Daxxn/KiCAD-Component-Library/Models/Connectors/F26P_ASM.stp

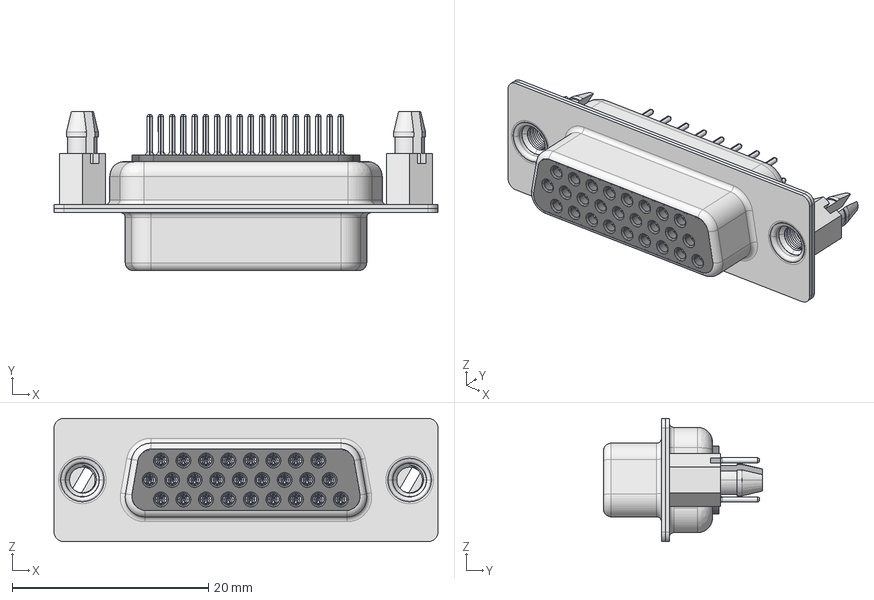
[picture p1: CAD file, 2023-04-23]
Models/Connectors/F26P_ASM.stp
39.1 x 16.2 x 12.6 mm
FHOUSING
26PF_SHELL
FCOVER
FCONTACT_2 x 26
FCONTACT_3 x 26
FCONTACT_4 x 26
HDP-YUCHA x 2
