Daxxn/KiCAD-Component-Library/Models/Arduino/ARDUINO-MICRO v5.step

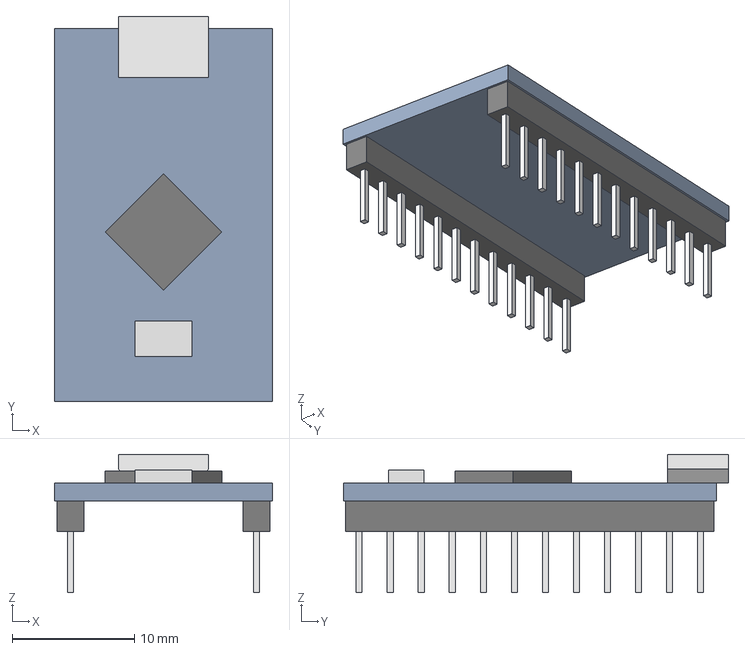
[picture p2: CAD file, 2022-10-09]
Models/Arduino/ARDUINO-MICRO v5.step
17.8 x 31.5 x 11.3 mm
