Daxxn/KiCAD-Component-Library/Models/Batteries/2462.step

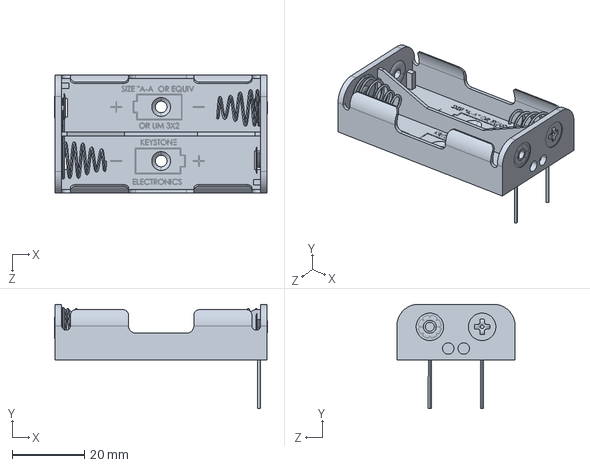
[picture p3: CAD file, 2025-04-12]
Models/Batteries/2462.step
59.1 x 29.0 x 32.8 mm
