Daxxn/KiCAD-Component-Library/Models/Connectors/Connector_BNC/CONBNC001.STEP

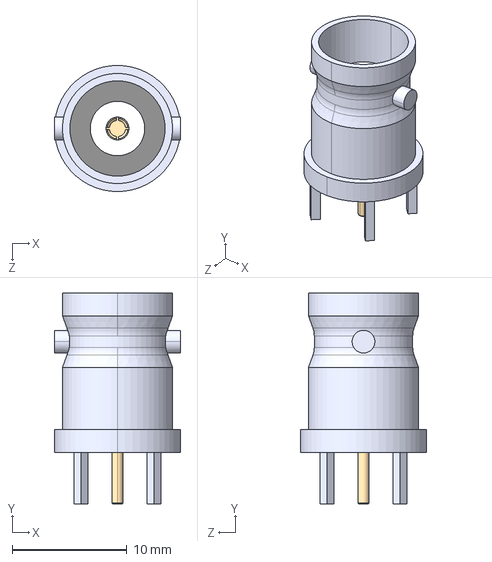
[picture p4: CAD file, 2025-11-15]
Models/Connectors/Connector_BNC/CONBNC001.STEP
11.0 x 18.4 x 11.0 mm
