Daxxn/KiCAD-Component-Library/Models/Connectors/Connector_DIN/57PC5FS.step

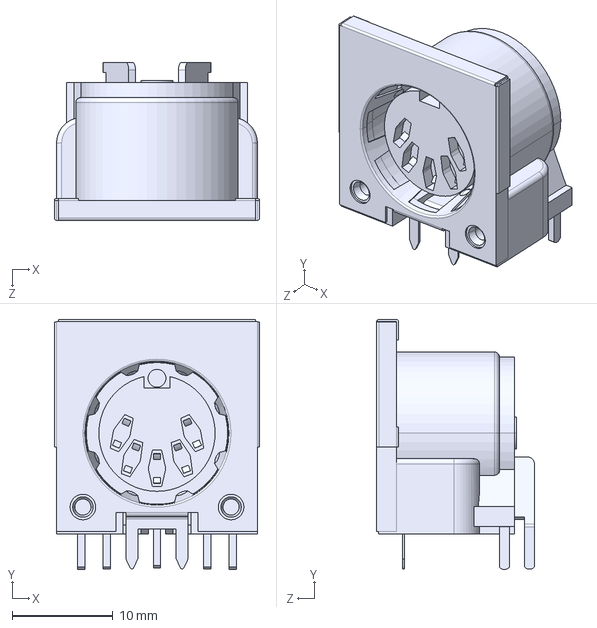
[picture p5: CAD file, 2025-04-12]
Models/Connectors/Connector_DIN/57PC5FS.step
20.4 x 24.9 x 15.7 mm
