Daxxn/KiCAD-Component-Library/Models/Connectors/Connector_DSUB/DD50S564TLF.step

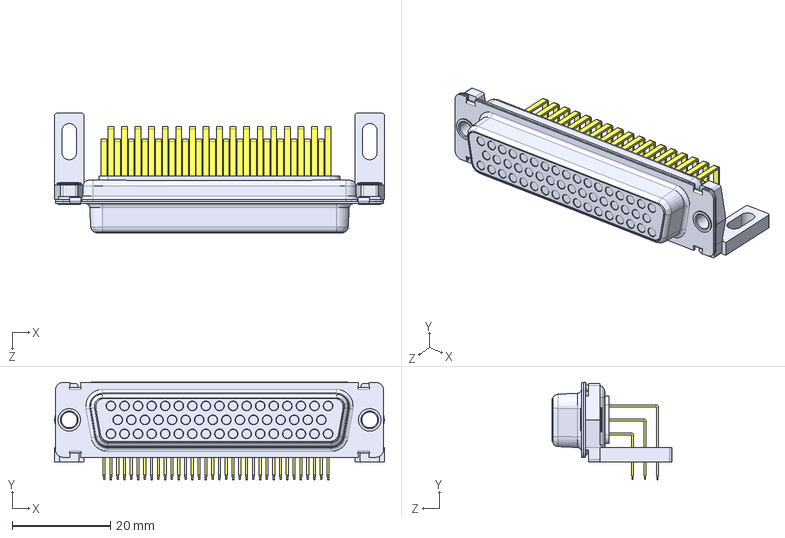
[picture p6: CAD file, 2025-11-15]
Models/Connectors/Connector_DSUB/DD50S564TLF.step
67.1 x 19.9 x 24.4 mm
