Daxxn/KiCAD-Component-Library/Models/Connectors/Connector_Ethernet/RJMG201K21120FR.step

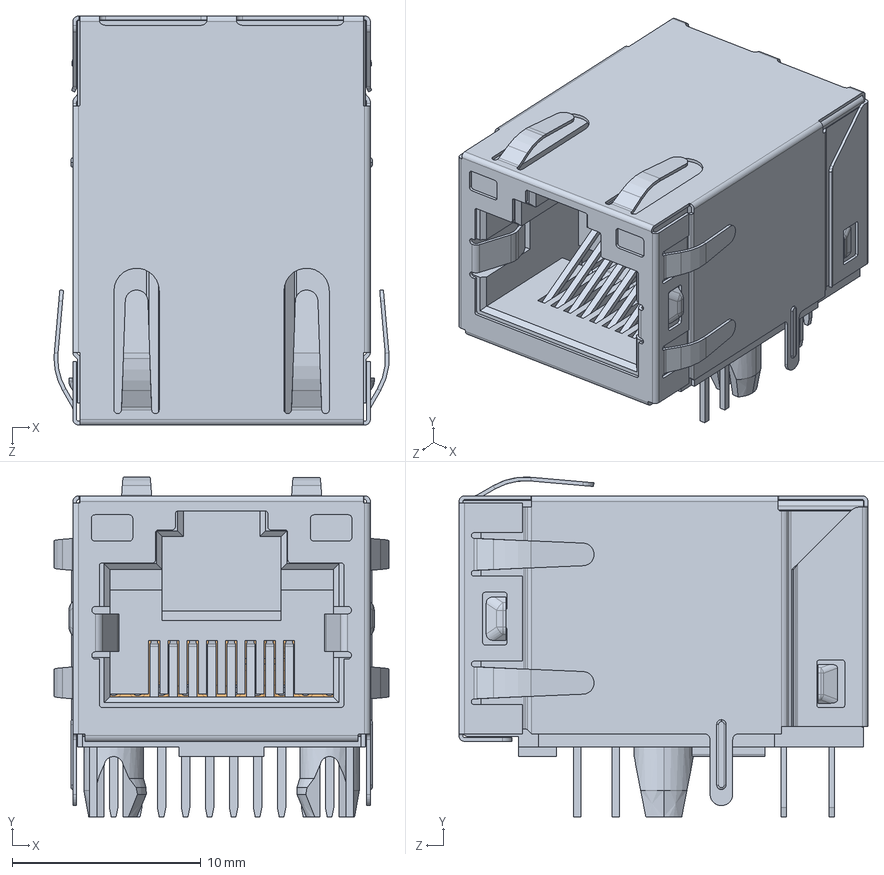
[picture p7: CAD file, 2025-11-15]
Models/Connectors/Connector_Ethernet/RJMG201K21120FR.step
17.7 x 18.0 x 21.7 mm
