Daxxn/KiCAD-Component-Library/Models/Connectors/Connector_Jack/PRT-09739.step

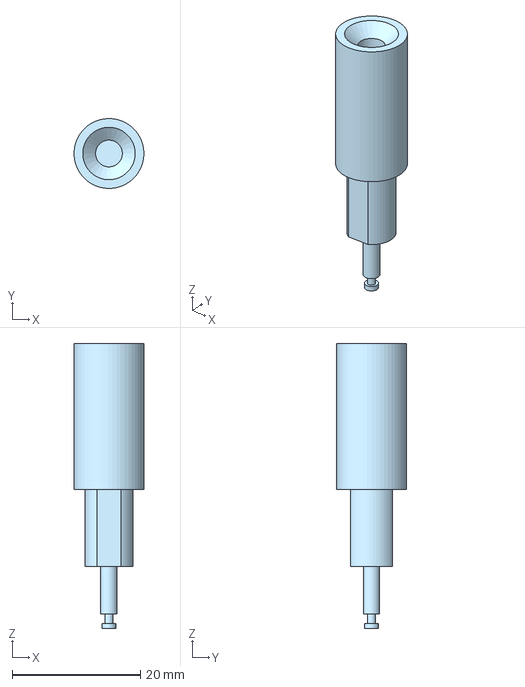
[picture p9: CAD file, 2025-04-12]
Models/Connectors/Connector_Jack/PRT-09739.step
10.9 x 10.9 x 44.4 mm
