Daxxn/KiCAD-Component-Library/Models/Connectors/Connector_PinHeader_2.54mm/PinHeader_2x35_P2.54mm_Vertical_SMD.step

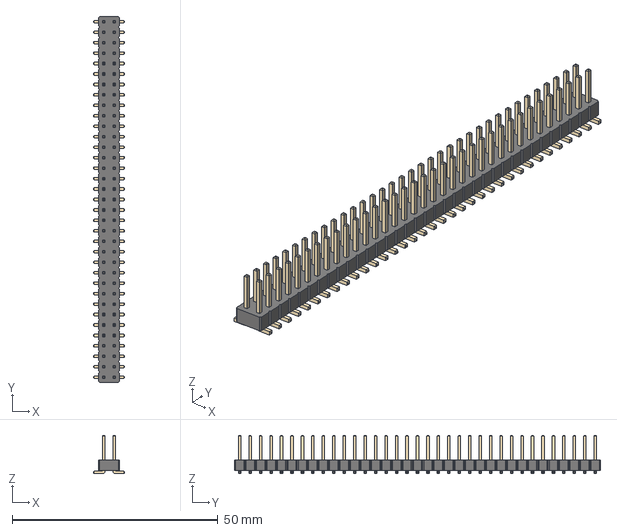
[picture p10: CAD file, 2025-02-12]
Models/Connectors/Connector_PinHeader_2.54mm/PinHeader_2x35_P2.54mm_Vertical_SMD.step
7.54 x 88.9 x 9.30 mm
