Daxxn/KiCAD-Component-Library/Models/Connectors/Connector_Power/739W-X2_03.STEP

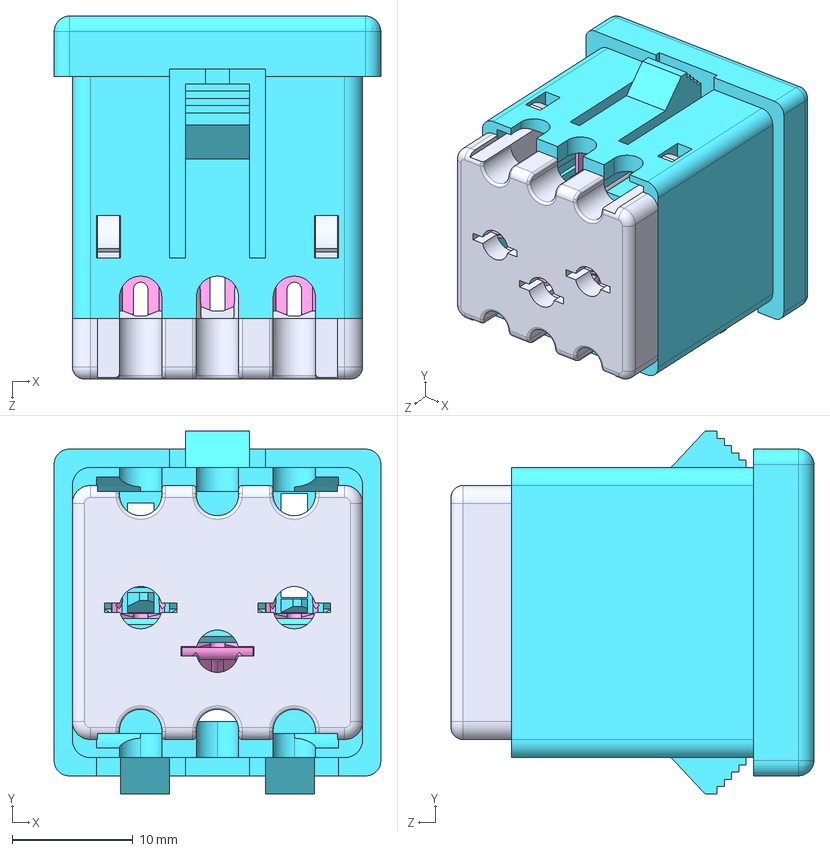
[picture p11: CAD file, 2025-04-12]
Models/Connectors/Connector_Power/739W-X2_03.STEP
27.0 x 30.0 x 30.0 mm
RF6001A
RF6001-001
RF6001-003 x 2
RF6001C
