Daxxn/KiCAD-Component-Library/Models/Connectors/Connector_Programming/FTR-110-51-L-D-06.stp

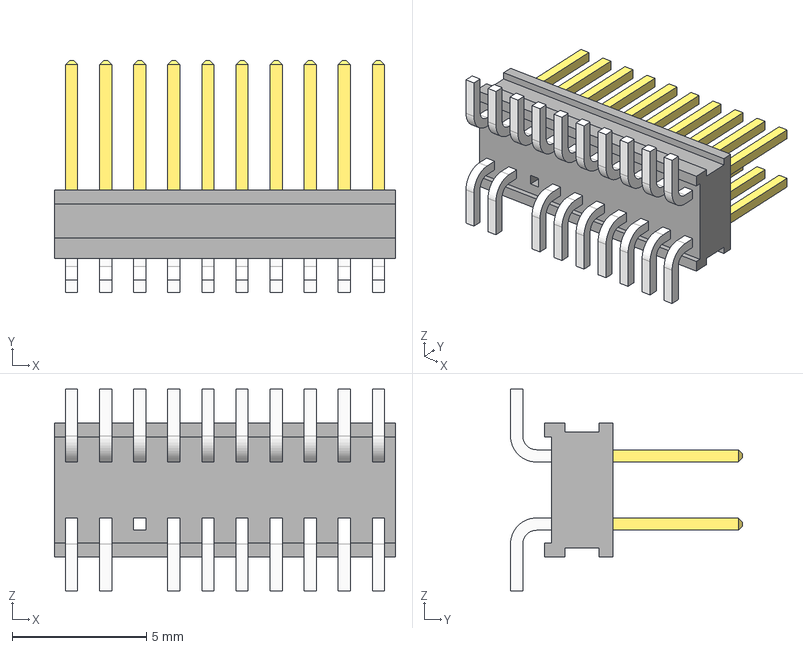
[picture p12: CAD file, 2025-04-12]
Models/Connectors/Connector_Programming/FTR-110-51-L-D-06.stp
12.7 x 8.64 x 7.52 mm
FTR-110-51-L-D-006_body
FTR-110-51-L-D-006_pins
FTR-110-51-L-D-0062PNS
