Daxxn/KiCAD-Component-Library/Models/Connectors/Connector_Samtec/LSHM-110-01-L-DH-A-S-K-TR.step

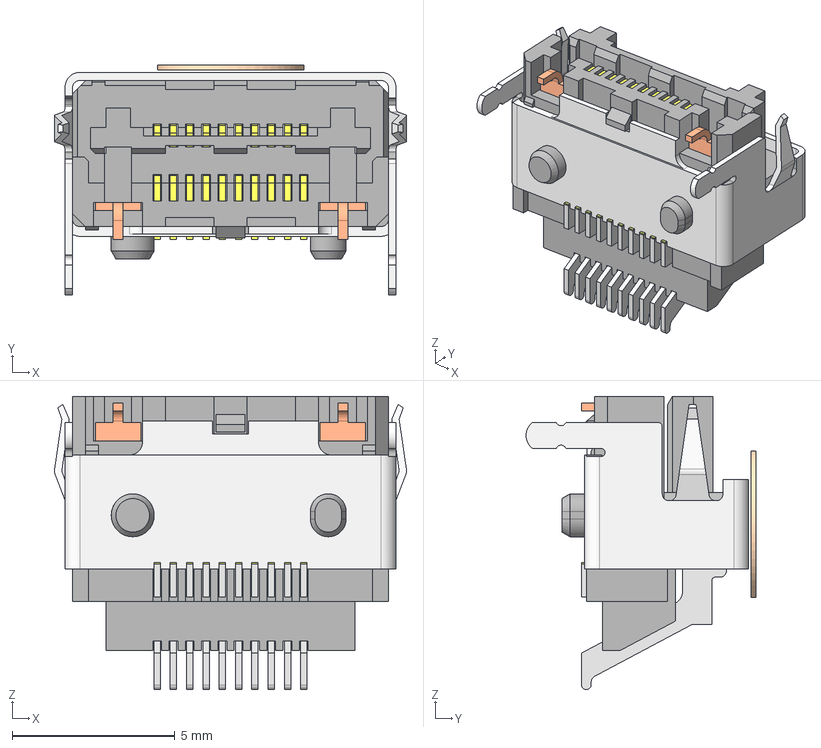
[picture p13: CAD file, 2025-04-12]
Models/Connectors/Connector_Samtec/LSHM-110-01-L-DH-A-S-K-TR.step
10.8 x 7.05 x 9.00 mm
K-DOT-.177-.281-.005pp
WT-135 x 2
C-185--10-01-DH1P2 L
C-185--10-01-L-DH1P
LSHM-10-01-DH-A-S_STRIP
