Daxxn/KiCAD-Component-Library/Models/Connectors/Connector_Samtec_HPM_THT/Samtec_HPM-07-01-x-S_Straight_1x07_Pitch5.08mm.step

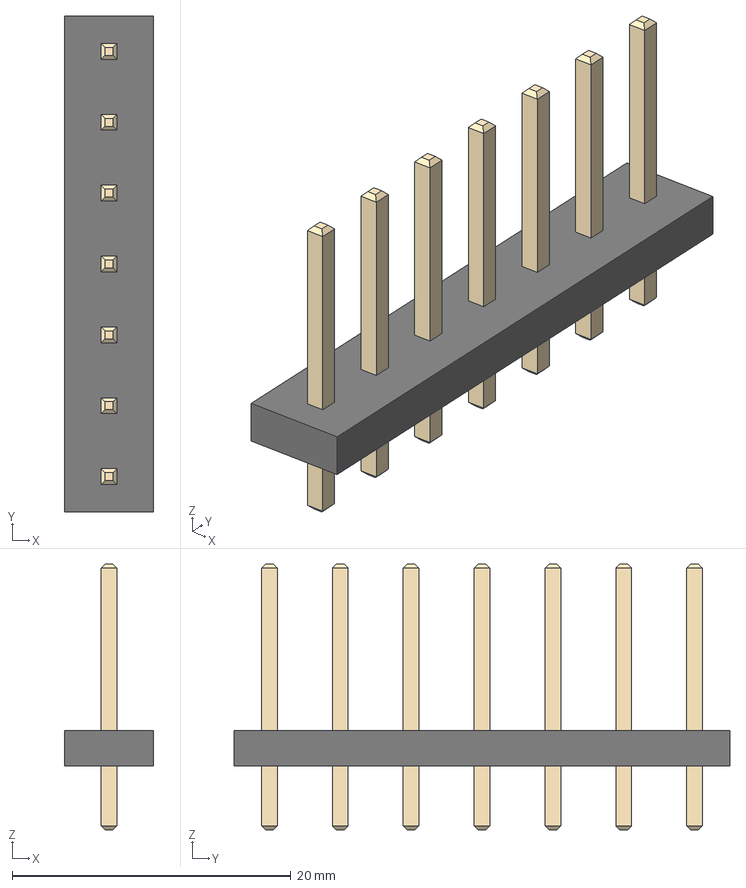
[picture p14: CAD file, 2025-04-12]
Models/Connectors/Connector_Samtec_HPM_THT/Samtec_HPM-07-01-x-S_Straight_1x07_Pitch5.08mm.step
6.35 x 35.6 x 19.1 mm
cf05abca-8c20-11ed-9f4e-a0cec80452fd_part
cf05b020-8c20-11ed-9f4e-a0cec80452fd_part
cf05b32c-8c20-11ed-9f4e-a0cec80452fd_part
