Daxxn/KiCAD-Component-Library/Models/Connectors/Connector_Terminal/7788.STEP

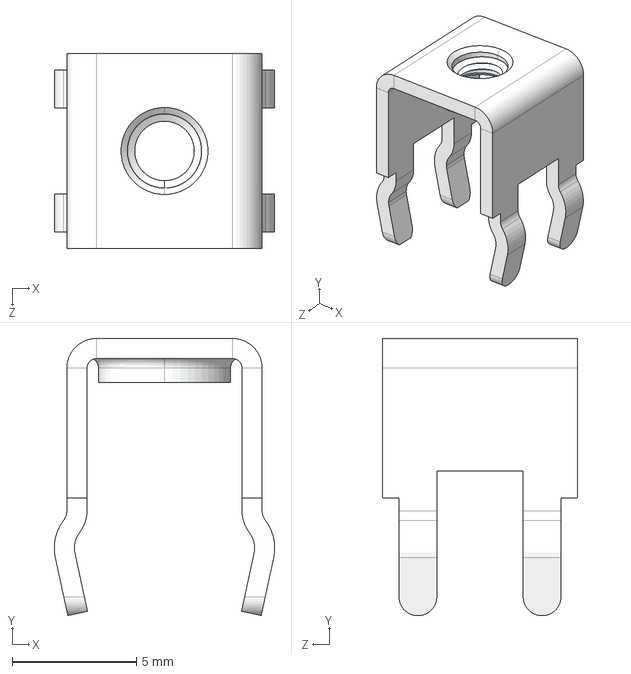
[picture p15: CAD file, 2025-04-12]
Models/Connectors/Connector_Terminal/7788.STEP
8.89 x 11.2 x 7.87 mm
