Daxxn/KiCAD-Component-Library/Models/Connectors/IO-XLR3-M-EH.step

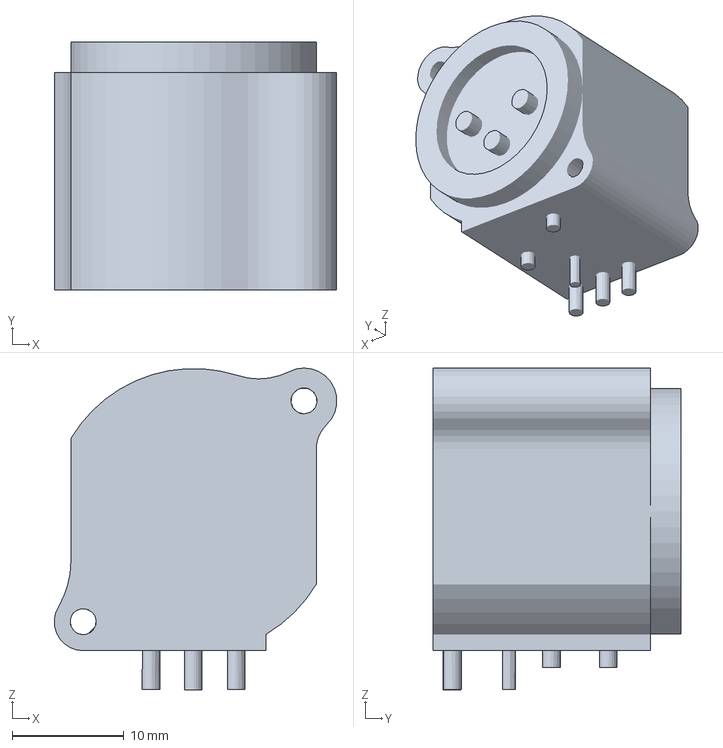
[picture p16: CAD file, 2025-04-12]
Models/Connectors/IO-XLR3-M-EH.step
25.3 x 22.2 x 28.9 mm
