Daxxn/KiCAD-Component-Library/Models/Controls/228CMV.step

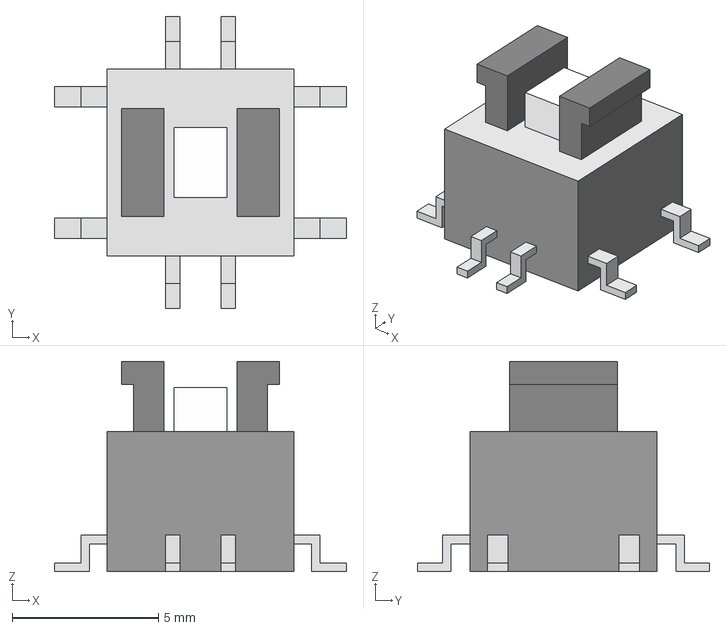
[picture p17: CAD file, 2025-04-12]
Models/Controls/228CMV.step
10.0 x 10.0 x 7.20 mm
