Daxxn/KiCAD-Component-Library/Models/Hardware/Standoff-Brass-M3-10.stp

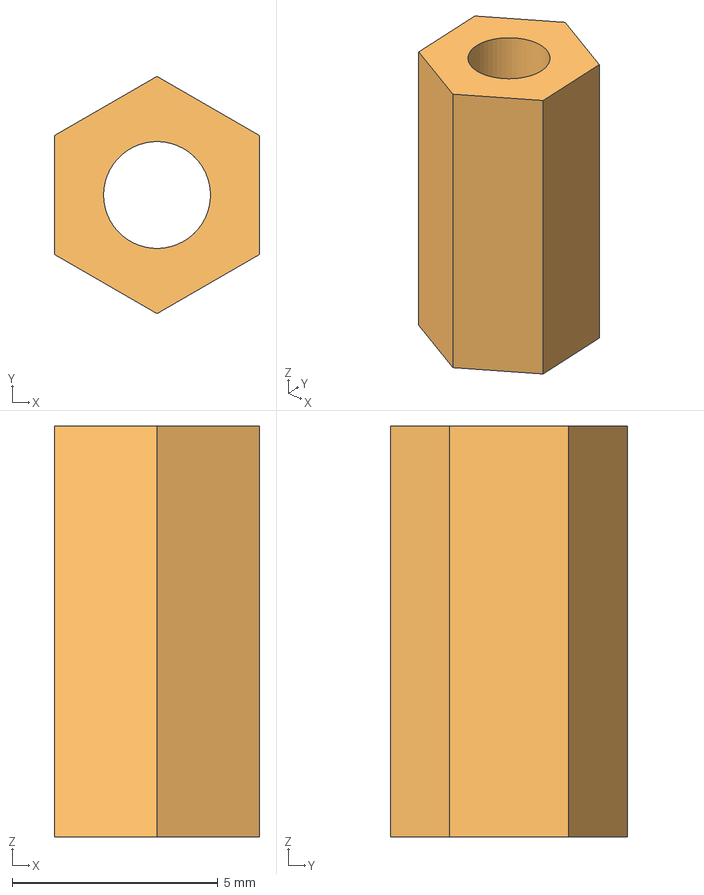
[picture p18: CAD file, 2022-10-09]
Models/Hardware/Standoff-Brass-M3-10.stp
5.00 x 5.77 x 10.0 mm
