Daxxn/KiCAD-Component-Library/Models/LEDs/67-21S.STEP

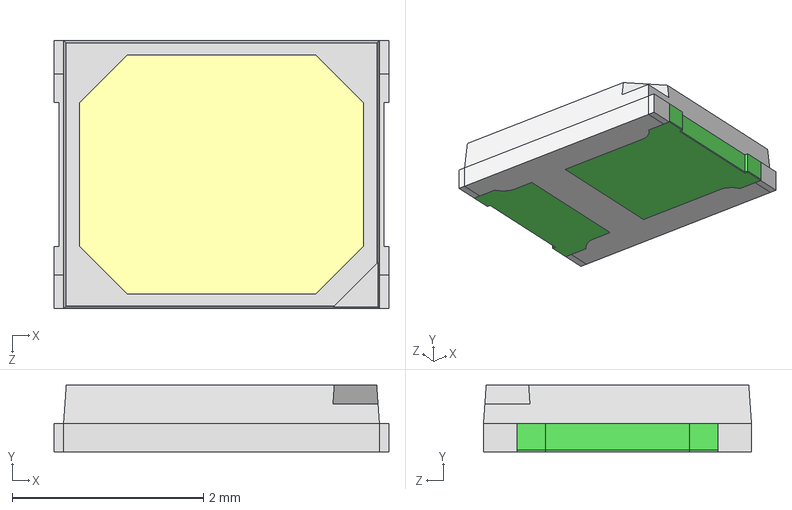
[picture p19: CAD file, 2025-04-12]
Models/LEDs/67-21S.STEP
3.50 x 0.7 x 2.80 mm
