Daxxn/KiCAD-Component-Library/Models/Modules/XBOX-Ctrlr-MCU-1708.step

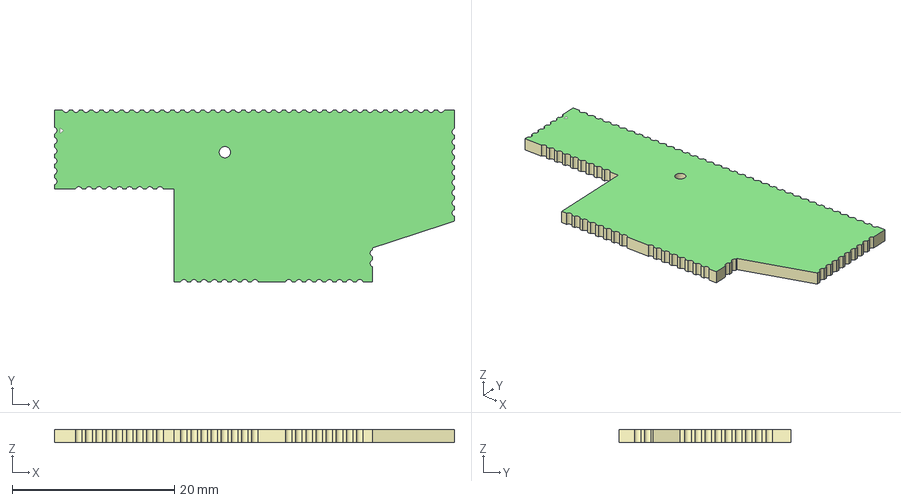
[picture p20: CAD file, 2025-11-15]
Models/Modules/XBOX-Ctrlr-MCU-1708.step
49.3 x 21.2 x 1.61 mm
