Daxxn/KiCAD-Component-Library/Models/Packages/Package_BGA/BGA-96_9.0x13.0mm_Layout2x3x16_P0.8mm.step

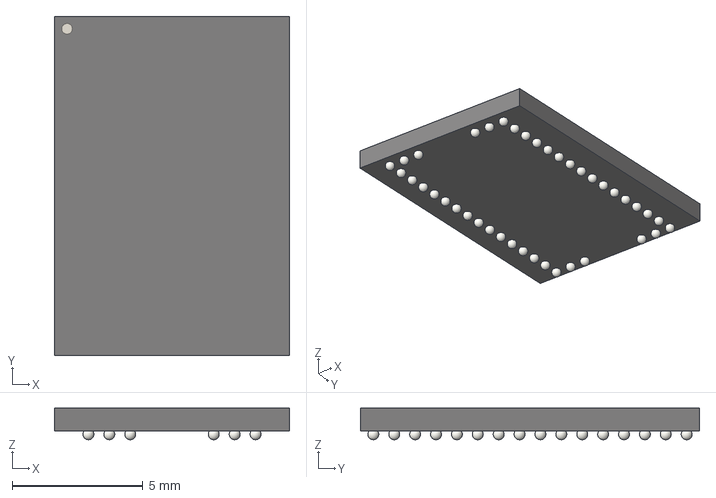
[picture p21: CAD file, 2025-02-12]
Models/Packages/Package_BGA/BGA-96_9.0x13.0mm_Layout2x3x16_P0.8mm.step
9.00 x 13.0 x 1.21 mm
