Daxxn/KiCAD-Component-Library/Models/Packages/Package_CSP/LFCSP-8-1EP_3x3mm_P0.5mm_EP1.45x1.74mm.step

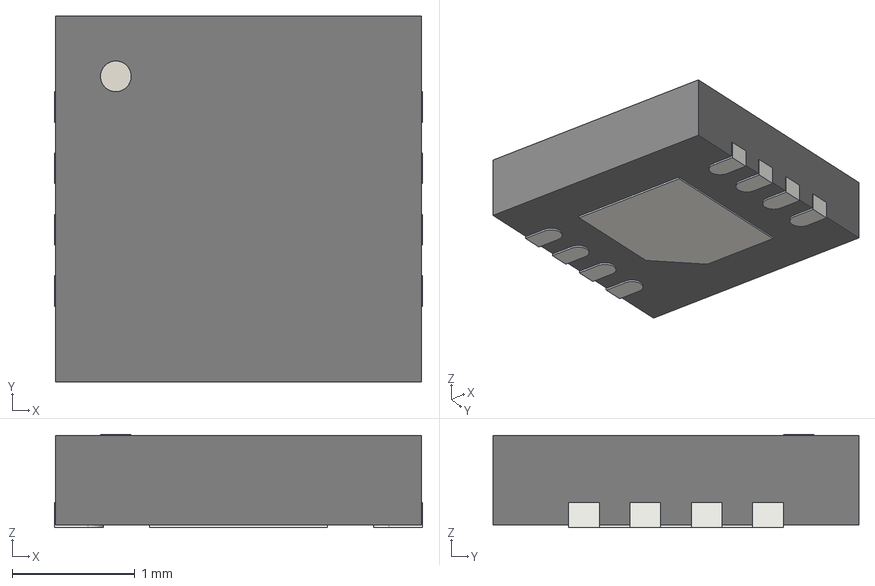
[picture p22: CAD file, 2025-02-12]
Models/Packages/Package_CSP/LFCSP-8-1EP_3x3mm_P0.5mm_EP1.45x1.74mm.step
3.00 x 2.98 x 0.76 mm
b90dc85a-8c68-11ed-89d9-acde48001122_part
b90dcca6-8c68-11ed-89d9-acde48001122_part
b90dcdfa-8c68-11ed-89d9-acde48001122_part
b90dcec2-8c68-11ed-89d9-acde48001122_part
