Daxxn/KiCAD-Component-Library/Models/Packages/Package_DIP/DIP-16_W7.62mm_Socket.step

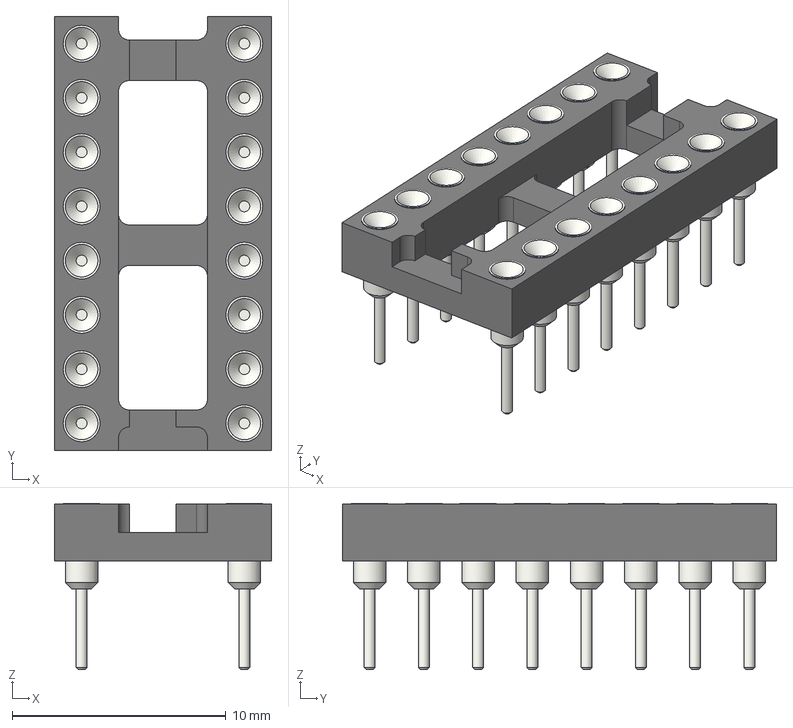
[picture p23: CAD file, 2025-02-12]
Models/Packages/Package_DIP/DIP-16_W7.62mm_Socket.step
10.2 x 20.3 x 7.79 mm
