Daxxn/KiCAD-Component-Library/Models/Packages/Package_LGA/Bosch_LGA-14_3x2.5mm_P0.5mm.step

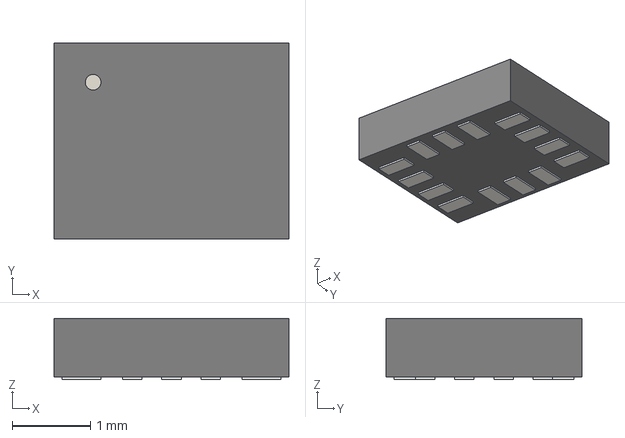
[picture p25: CAD file, 2025-02-12]
Models/Packages/Package_LGA/Bosch_LGA-14_3x2.5mm_P0.5mm.step
3.00 x 2.50 x 0.78 mm
