Daxxn/KiCAD-Component-Library/Models/Packages/Package_QFP/LQFP-32_7x7mm_P0.8mm.step

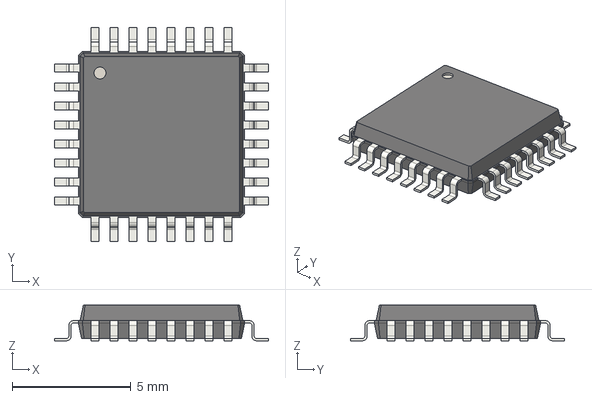
[picture p26: CAD file, 2025-02-12]
Models/Packages/Package_QFP/LQFP-32_7x7mm_P0.8mm.step
9.00 x 9.00 x 1.50 mm
