Daxxn/KiCAD-Component-Library/Models/Packages/Package_SIP/SLA704XM.step

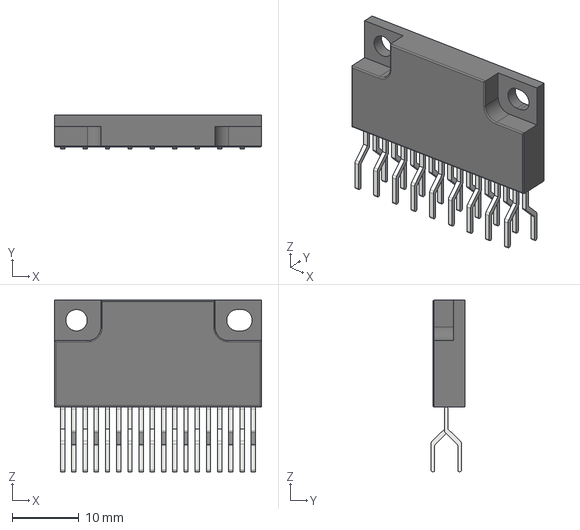
[picture p27: CAD file, 2025-02-12]
Models/Packages/Package_SIP/SLA704XM.step
31.0 x 5.08 x 25.7 mm
