Daxxn/KiCAD-Component-Library/Models/Packages/Package_SO/SSOP-14_5.3x6.2mm_P0.65mm.step

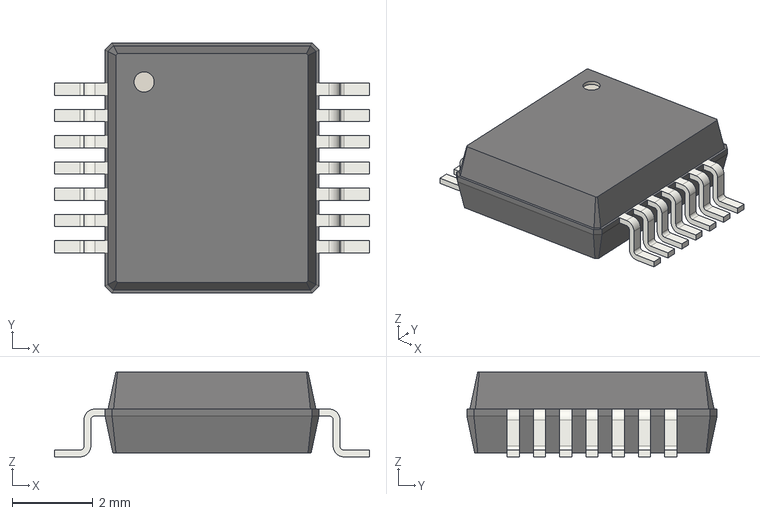
[picture p28: CAD file, 2025-02-12]
Models/Packages/Package_SO/SSOP-14_5.3x6.2mm_P0.65mm.step
7.80 x 6.20 x 2.10 mm
