Daxxn/KiCAD-Component-Library/Models/Packages/Package_SON/VSON-8_PWRPAK_3x3.3mm.step

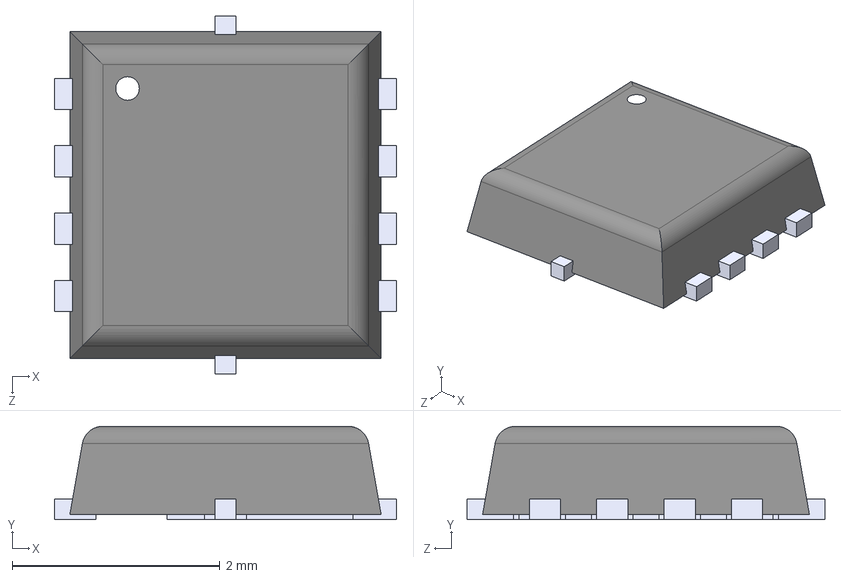
[picture p29: CAD file, 2025-11-15]
Models/Packages/Package_SON/VSON-8_PWRPAK_3x3.3mm.step
3.30 x 0.9 x 3.45 mm
