Daxxn/KiCAD-Component-Library/Models/Packages/Package_TO_SOT_SMD/TO-277A.step

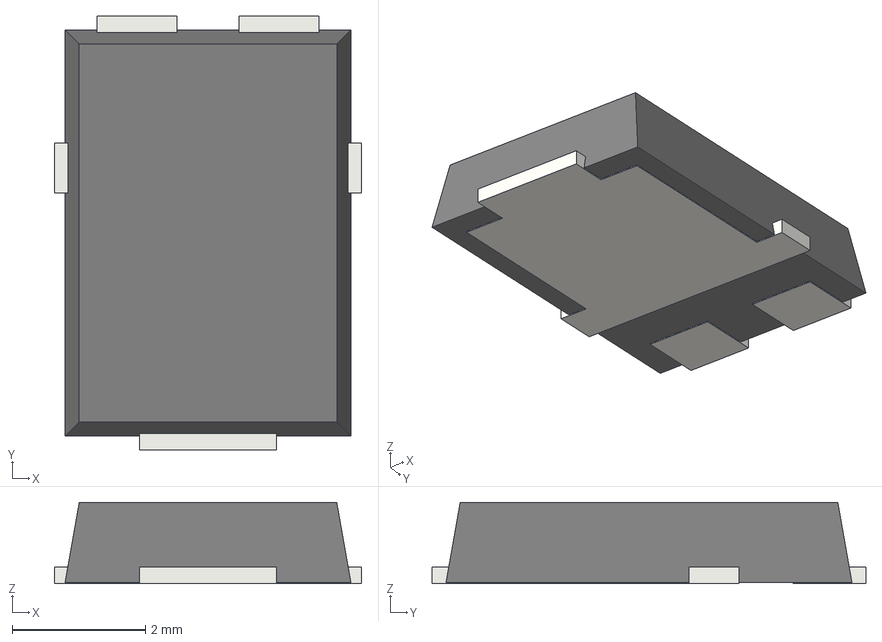
[picture p30: CAD file, 2025-02-12]
Models/Packages/Package_TO_SOT_SMD/TO-277A.step
4.60 x 6.50 x 1.22 mm
