Daxxn/KiCAD-Component-Library/Models/Packages/Package_TO_SOT_THT/TO-92-2_Wide.step

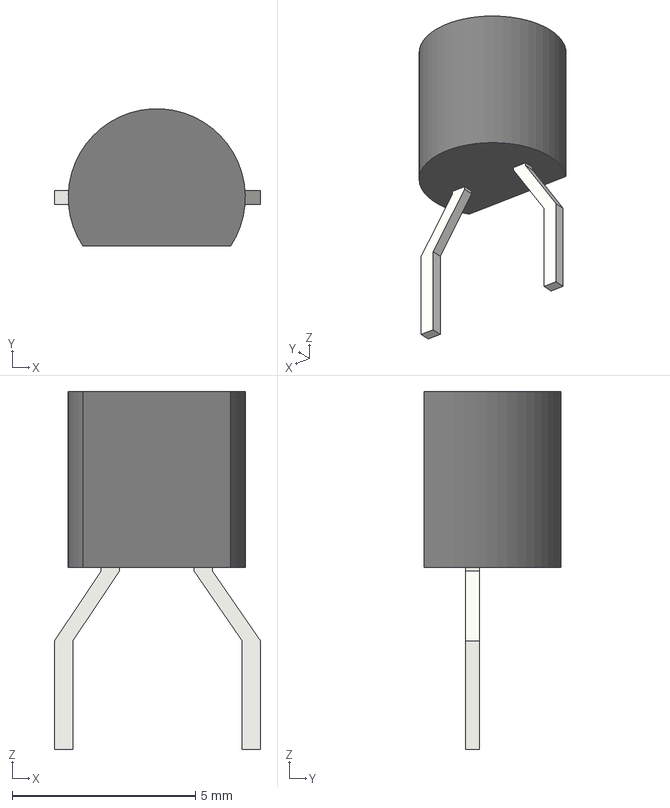
[picture p31: CAD file, 2025-02-12]
Models/Packages/Package_TO_SOT_THT/TO-92-2_Wide.step
5.62 x 3.74 x 9.76 mm
