Daxxn/KiCAD-Component-Library/Models/Packages/QFN-24-1EP_4x4mm_P0.5mm_EP2.6x2.6mm.step

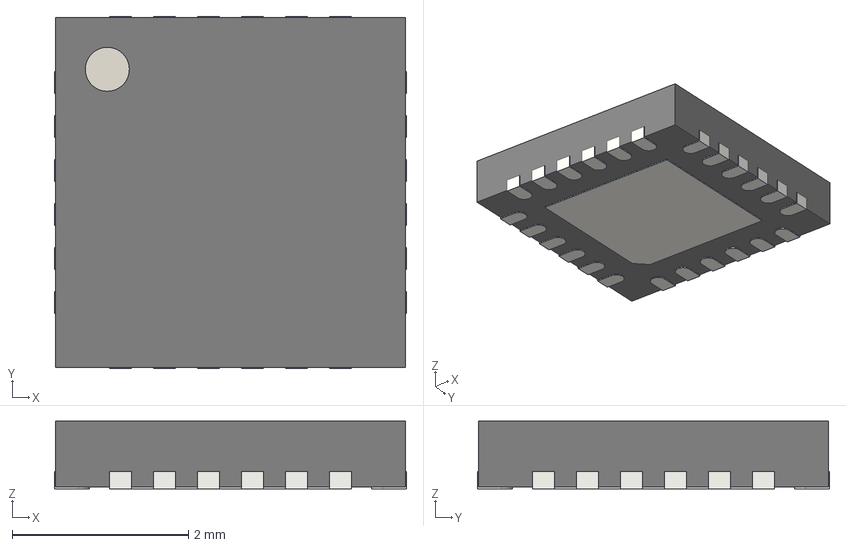
[picture p32: CAD file, 2025-02-12]
Models/Packages/QFN-24-1EP_4x4mm_P0.5mm_EP2.6x2.6mm.step
4.00 x 4.00 x 0.77 mm
