Daxxn/KiCAD-Component-Library/Models/Packages/Transistor_Power_Module/ST_SDIP-25L.step

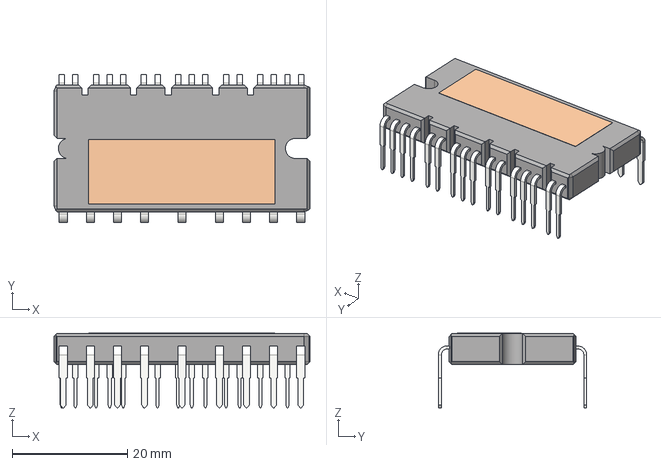
[picture p33: CAD file, 2025-02-12]
Models/Packages/Transistor_Power_Module/ST_SDIP-25L.step
44.4 x 25.8 x 12.9 mm
