Daxxn/KiCAD-Component-Library/Models/Passives/Capacitors/CP_Elec_10x12.5.step

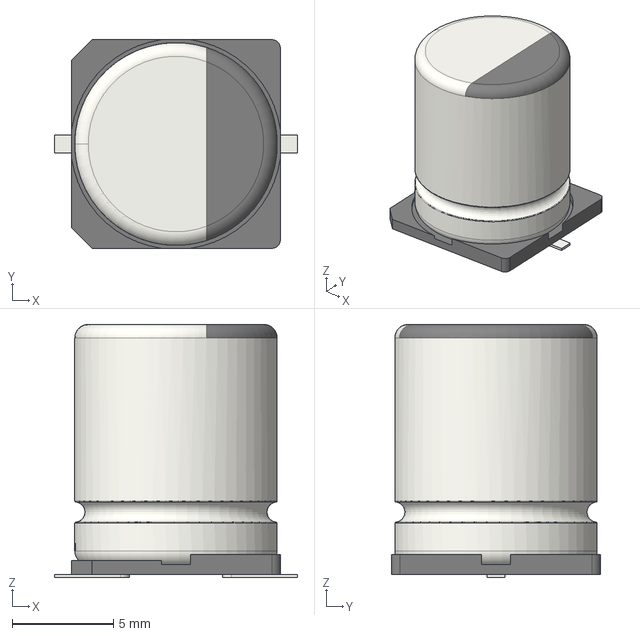
[picture p34: CAD file, 2025-02-12]
Models/Passives/Capacitors/CP_Elec_10x12.5.step
12.0 x 10.3 x 12.5 mm
