Daxxn/KiCAD-Component-Library/Models/Passives/Crystals/Crystal_HC49-4H_Vertical.step

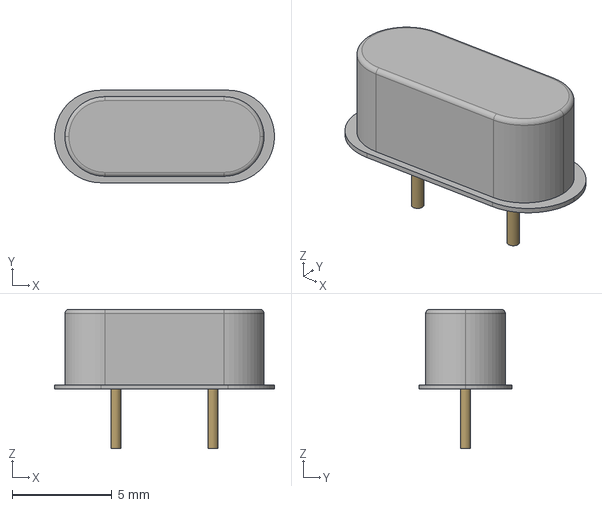
[picture p35: CAD file, 2025-02-12]
Models/Passives/Crystals/Crystal_HC49-4H_Vertical.step
11.1 x 4.65 x 7.00 mm
