Daxxn/KiCAD-Component-Library/Models/Passives/Diodes/D_2010_5025Metric.step

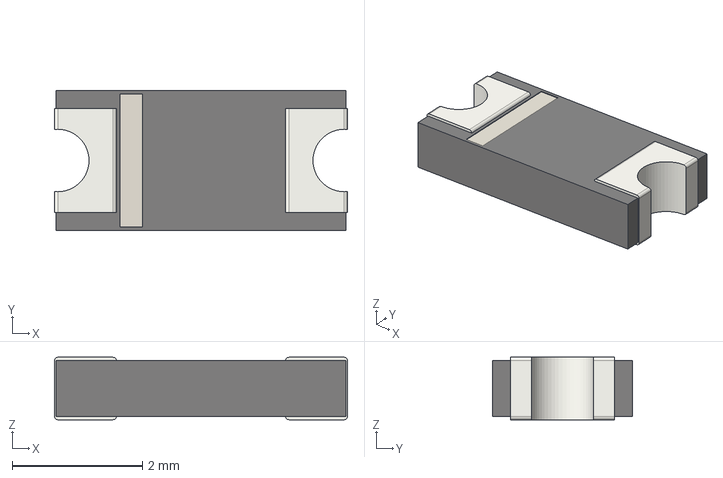
[picture p36: CAD file, 2025-02-12]
Models/Passives/Diodes/D_2010_5025Metric.step
4.50 x 2.15 x 0.96 mm
