Daxxn/KiCAD-Component-Library/Models/Passives/Inductors/IHLP5050FDERR10M01.stp

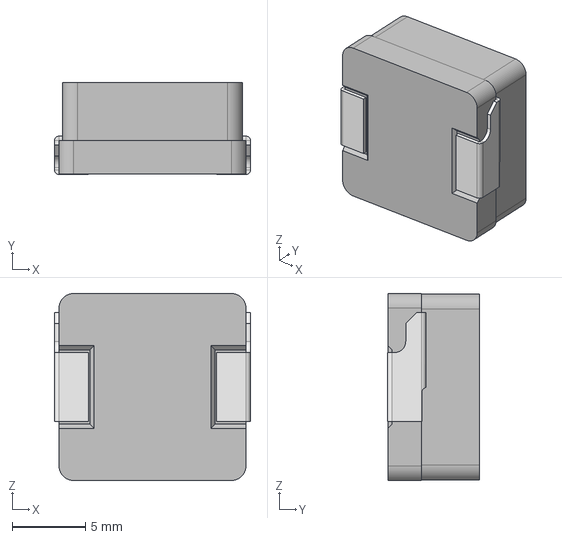
[picture p37: CAD file, 2025-04-12]
Models/Passives/Inductors/IHLP5050FDERR10M01.stp
13.4 x 6.29 x 12.8 mm
