Daxxn/KiCAD-Component-Library/Models/Passives/Resistors/R_Array_Convex_5x1206.step

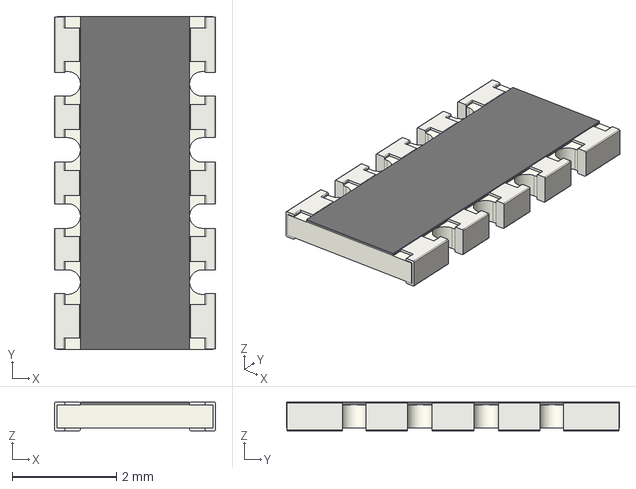
[picture p38: CAD file, 2025-02-12]
Models/Passives/Resistors/R_Array_Convex_5x1206.step
3.10 x 6.40 x 0.55 mm
