Daxxn/KiCAD-Component-Library/Models/Protection/36-3522.step

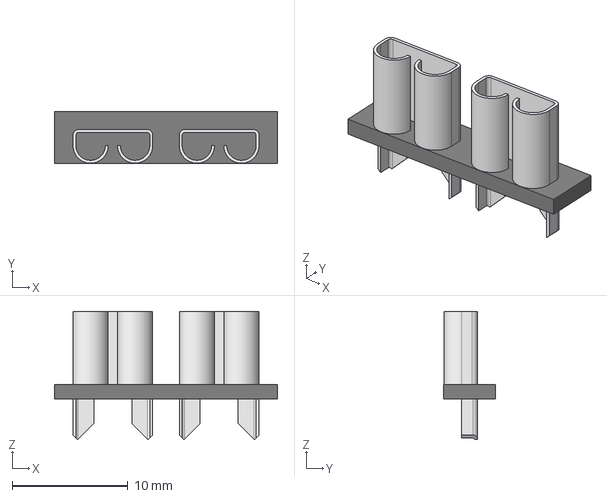
[picture p39: CAD file, 2022-10-09]
Models/Protection/36-3522.step
19.3 x 4.50 x 11.1 mm
