Daxxn/KiCAD-Component-Library/Models/Relays/PT08_0.step

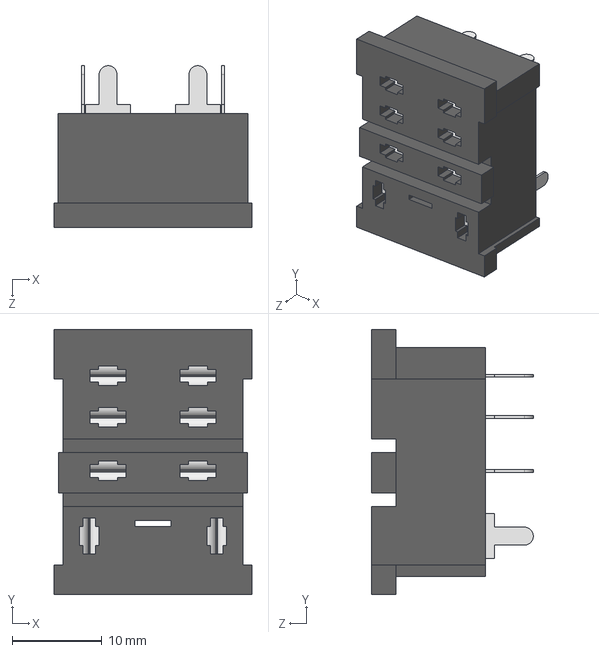
[picture p40: CAD file, 2025-04-12]
Models/Relays/PT08_0.step
22.0 x 29.5 x 18.0 mm
