Daxxn/KiCAD-Component-Library/Models/RF/Antenna/AMCA31-2R450G-S1F-T3.step

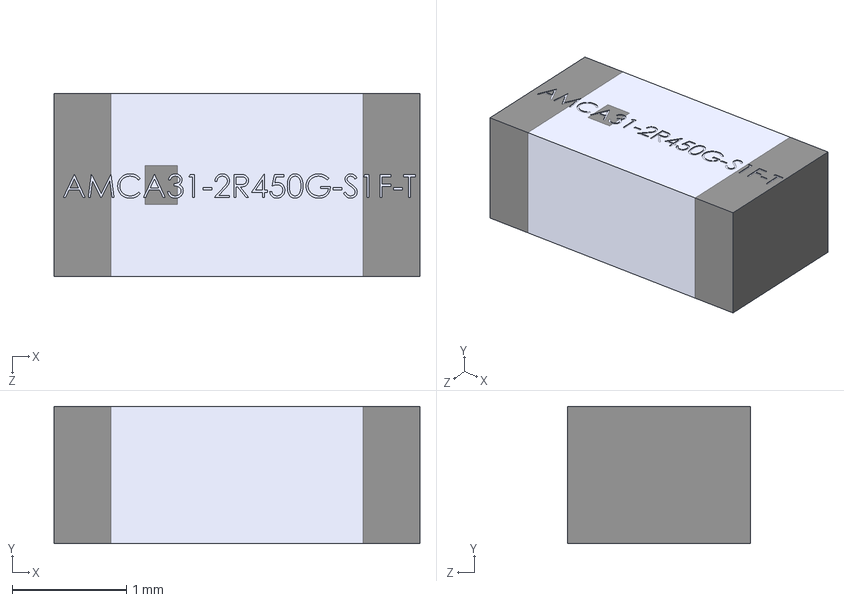
[picture p41: CAD file, 2025-04-12]
Models/RF/Antenna/AMCA31-2R450G-S1F-T3.step
3.20 x 1.20 x 1.60 mm
