Daxxn/KiCAD-Component-Library/Models/Sensors/OPB616.STEP

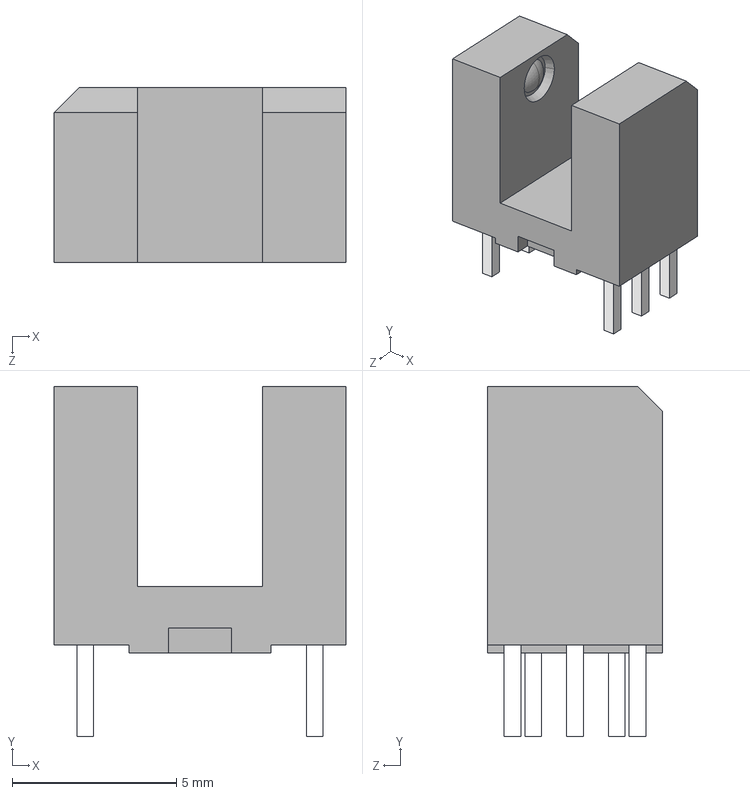
[picture p42: CAD file, 2025-04-12]
Models/Sensors/OPB616.STEP
8.89 x 10.7 x 5.33 mm
