Daxxn/KiCAD-Component-Library/Models/Thermal/ATS-CPX025025015-138-C2-R0.step

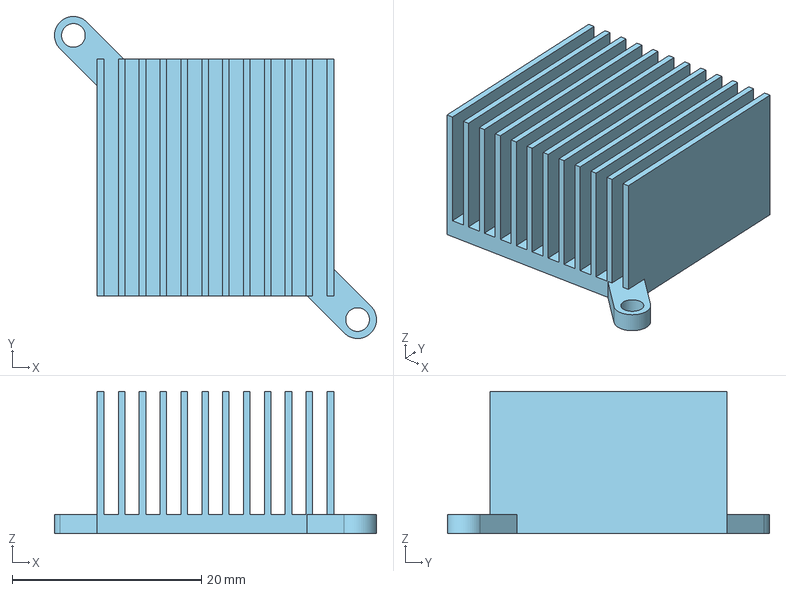
[picture p43: CAD file, 2025-04-12]
Models/Thermal/ATS-CPX025025015-138-C2-R0.step
34.0 x 34.0 x 15.0 mm
