Daxxn/KiCAD-Component-Library/Models/Transformer/Transformer_CHK_EI54-12VA_1xSec.step

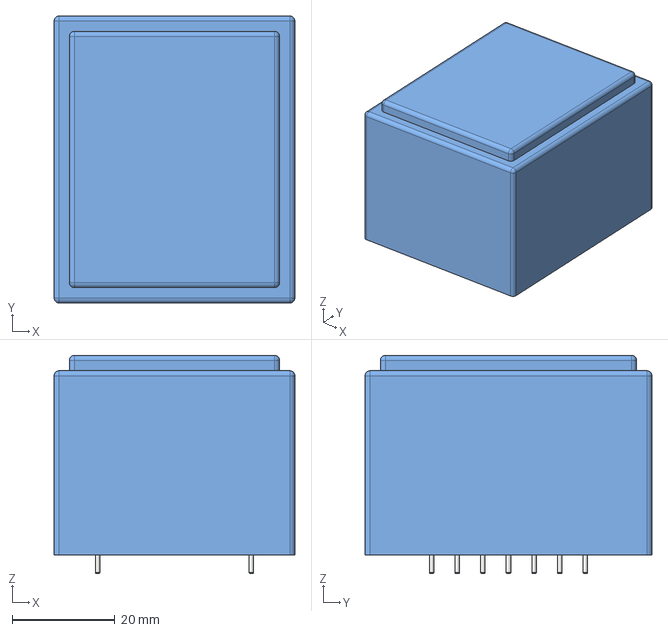
[picture p44: CAD file, 2025-04-12]
Models/Transformer/Transformer_CHK_EI54-12VA_1xSec.step
47.0 x 56.0 x 42.6 mm
Transformer_CHK_EI54_12VA_1xSec001
Transformer_CHK_EI54_12VA_1xSec
