Daxxn/KiCAD-Component-Library/Models/Arduino/ARDUINO-NANO-FP v3.step

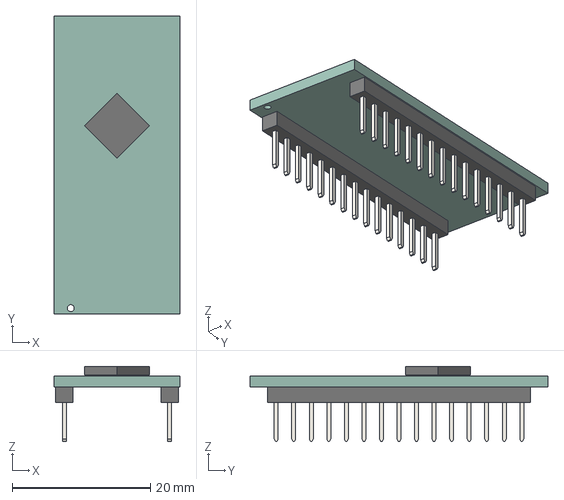
[picture p45: CAD file, 2022-10-09]
Models/Arduino/ARDUINO-NANO-FP v3.step
18.2 x 43.1 x 10.9 mm
