Daxxn/KiCAD-Component-Library/Models/Batteries/BU2032SM-JJ-GTR.step

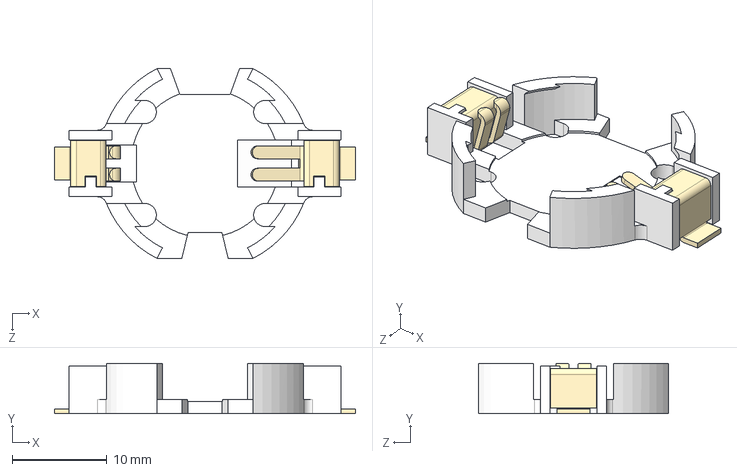
[picture p46: CAD file, 2025-02-12]
Models/Batteries/BU2032SM-JJ-GTR.step
31.7 x 5.30 x 20.0 mm
