Daxxn/KiCAD-Component-Library/Models/Connectors/Connector_DSUB/182-037_NRC.step

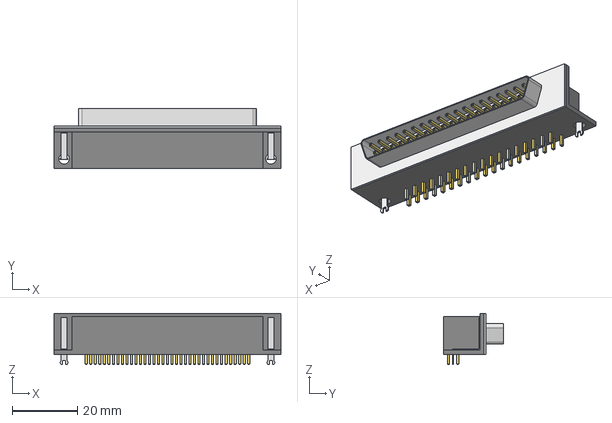
[picture p47: CAD file, 2025-04-12]
Models/Connectors/Connector_DSUB/182-037_NRC.step
69.7 x 18.5 x 15.7 mm
