Daxxn/KiCAD-Component-Library/Models/Connectors/Connector_Ethernet/RJHSE5E80.step

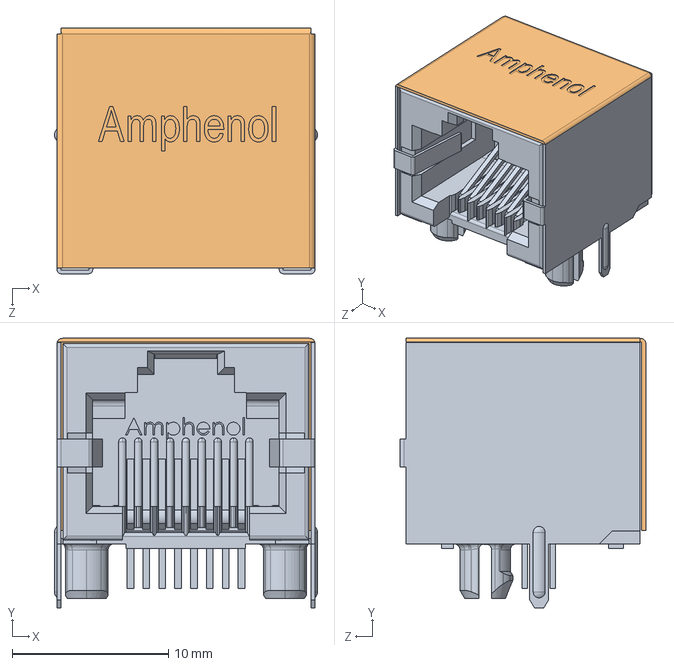
[picture p48: CAD file, 2025-04-12]
Models/Connectors/Connector_Ethernet/RJHSE5E80.step
16.8 x 17.2 x 15.7 mm
