Daxxn/KiCAD-Component-Library/Models/Connectors/Connector_Jack/575-4.step

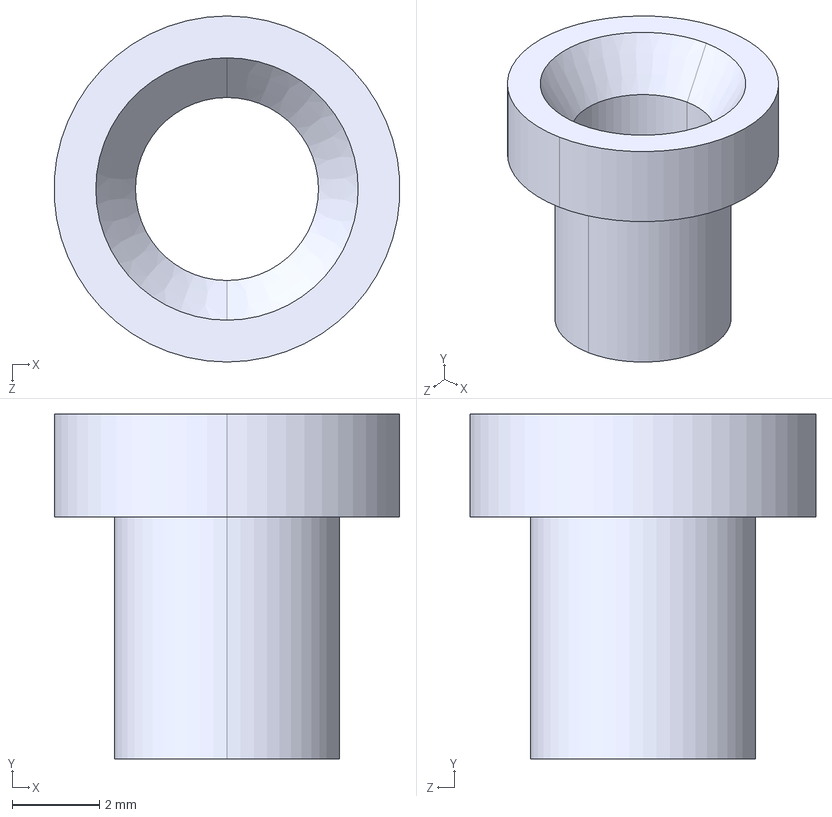
[picture p49: CAD file, 2025-04-12]
Models/Connectors/Connector_Jack/575-4.step
7.91 x 7.90 x 7.92 mm
