Daxxn/KiCAD-Component-Library/Models/Connectors/Connector_Mezzanine/DF40C-100DP.stp

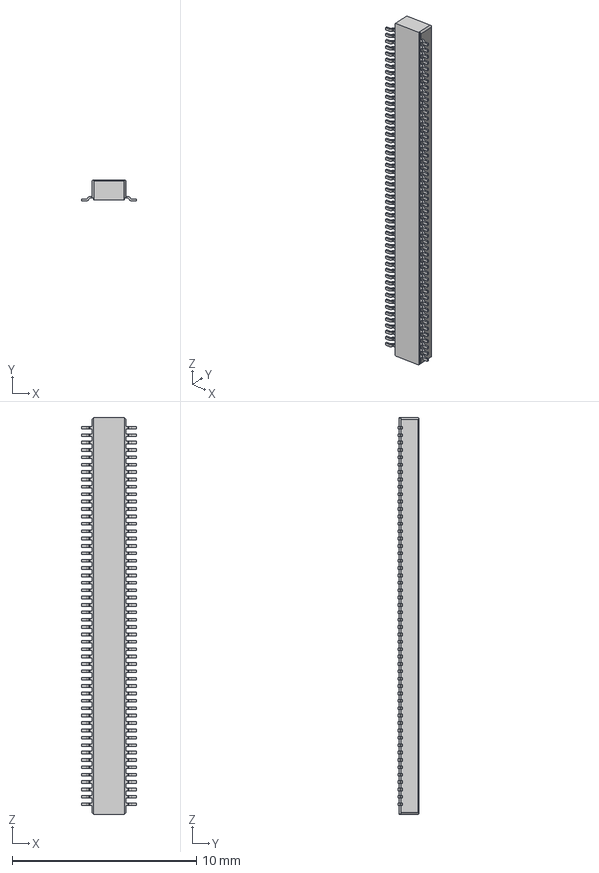
[picture p50: CAD file, 2025-04-12]
Models/Connectors/Connector_Mezzanine/DF40C-100DP.stp
2.97 x 1.14 x 21.5 mm
