Daxxn/KiCAD-Component-Library/Models/Connectors/Connector_PinHeader_2.54mm/PinHeader_1x06_P2.54mm_Vertical.step

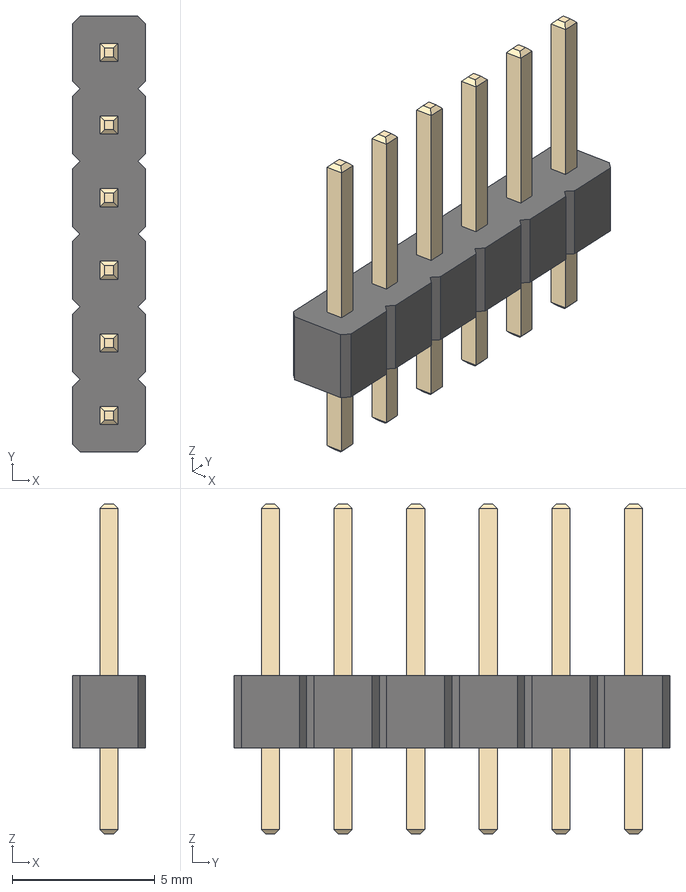
[picture p51: CAD file, 2025-02-12]
Models/Connectors/Connector_PinHeader_2.54mm/PinHeader_1x06_P2.54mm_Vertical.step
2.54 x 15.2 x 11.5 mm
