Daxxn/KiCAD-Component-Library/Models/Connectors/Connector_Samtec/Samtec_FMC_ASP-134602-01_10x40_P1.27mm_Vertical.step

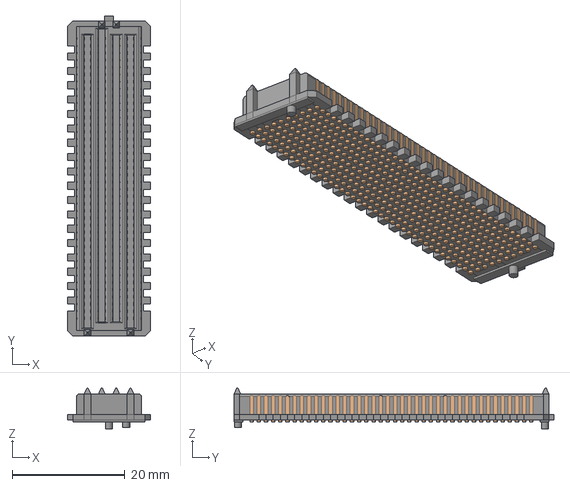
[picture p52: CAD file, 2025-04-12]
Models/Connectors/Connector_Samtec/Samtec_FMC_ASP-134602-01_10x40_P1.27mm_Vertical.step
14.7 x 56.7 x 7.24 mm
