Daxxn/KiCAD-Component-Library/Models/Connectors/Connector_Samtec_HPM_THT/Samtec_HPM-10-05-x-S_Straight_1x10_Pitch5.08mm.step

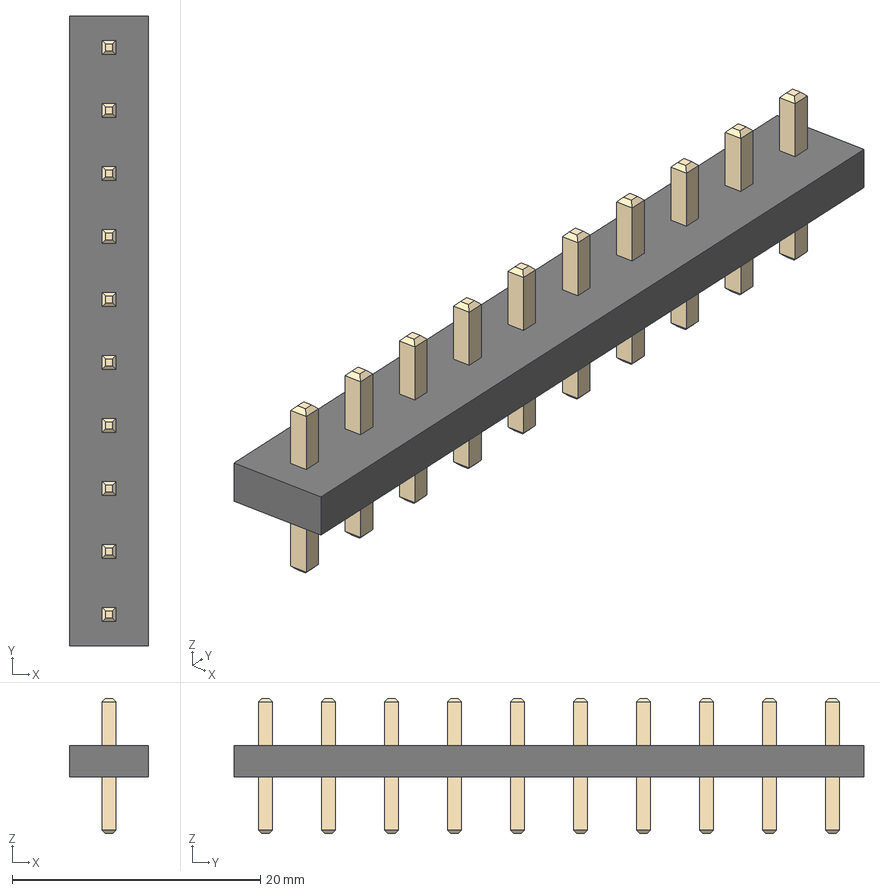
[picture p53: CAD file, 2025-04-12]
Models/Connectors/Connector_Samtec_HPM_THT/Samtec_HPM-10-05-x-S_Straight_1x10_Pitch5.08mm.step
6.35 x 50.8 x 10.9 mm
e14b2620-8c20-11ed-b7ac-a0cec80452fd_part
e14b2a6c-8c20-11ed-b7ac-a0cec80452fd_part
e14b2d3c-8c20-11ed-b7ac-a0cec80452fd_part
