Daxxn/KiCAD-Component-Library/Models/Connectors/Connector_Terminal/7770.STEP

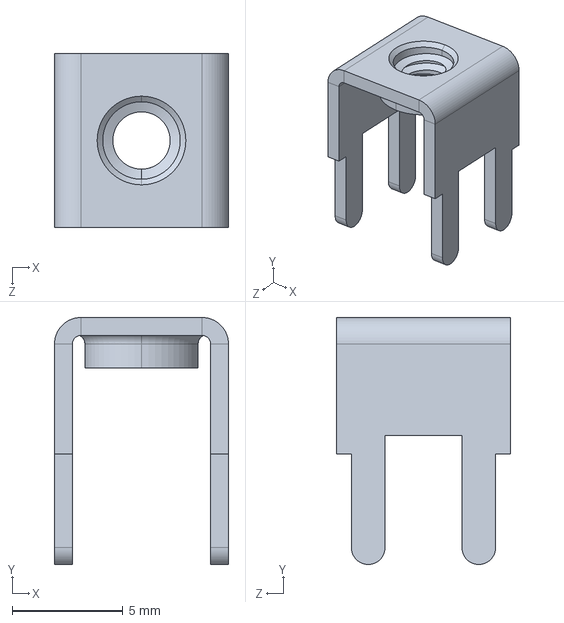
[picture p54: CAD file, 2025-04-12]
Models/Connectors/Connector_Terminal/7770.STEP
7.87 x 11.2 x 7.87 mm
