Daxxn/KiCAD-Component-Library/Models/Connectors/Connector_USB/USB3130-30-A.stp

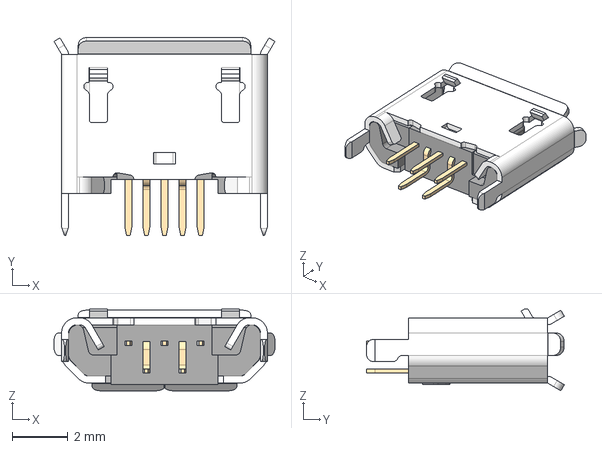
[picture p55: CAD file, 2025-04-12]
Models/Connectors/Connector_USB/USB3130-30-A.stp
7.94 x 7.11 x 2.93 mm
