Daxxn/KiCAD-Component-Library/Models/Connectors/MM8030-2610RJ3.step

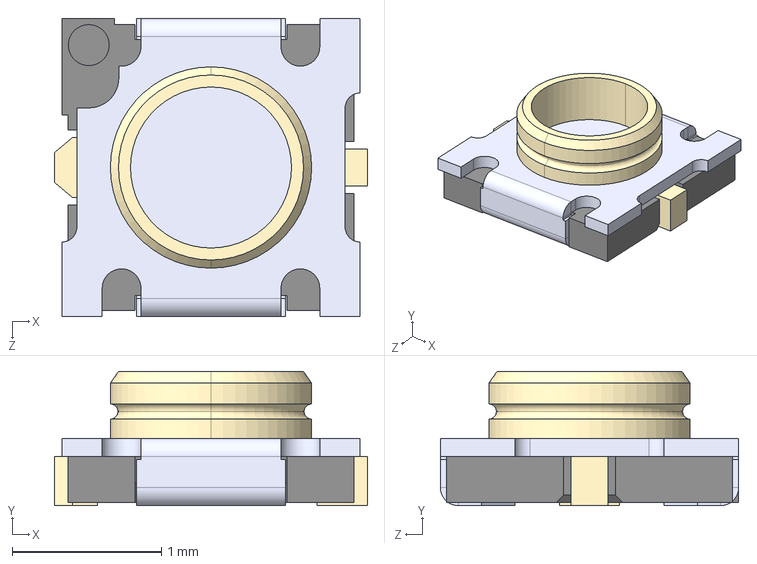
[picture p56: CAD file, 2025-04-12]
Models/Connectors/MM8030-2610RJ3.step
2.10 x 0.9 x 2.00 mm
