Daxxn/KiCAD-Component-Library/Models/Controls/229AP series.stp

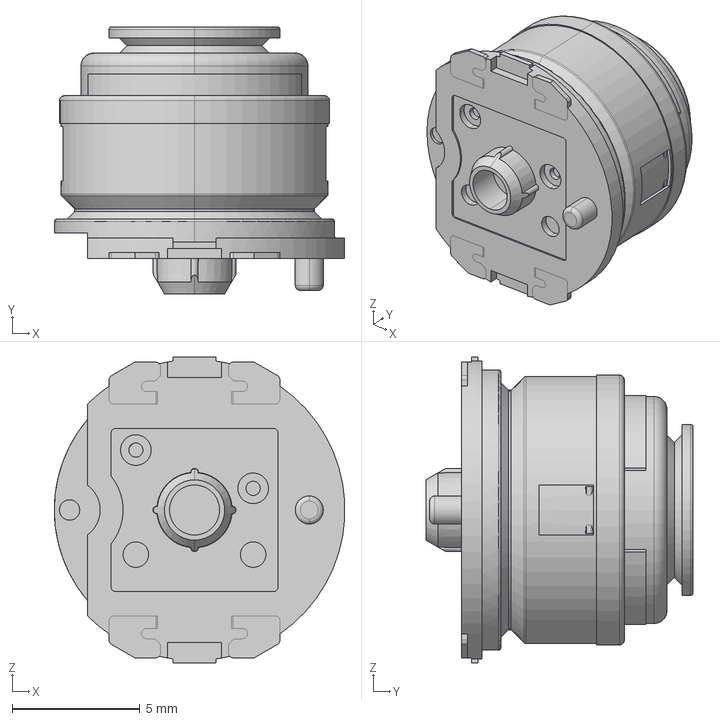
[picture p57: CAD file, 2025-04-12]
Models/Controls/229AP series.stp
11.4 x 10.5 x 12.0 mm
