Daxxn/KiCAD-Component-Library/Models/Displays/HSD088IPW1-A00.step

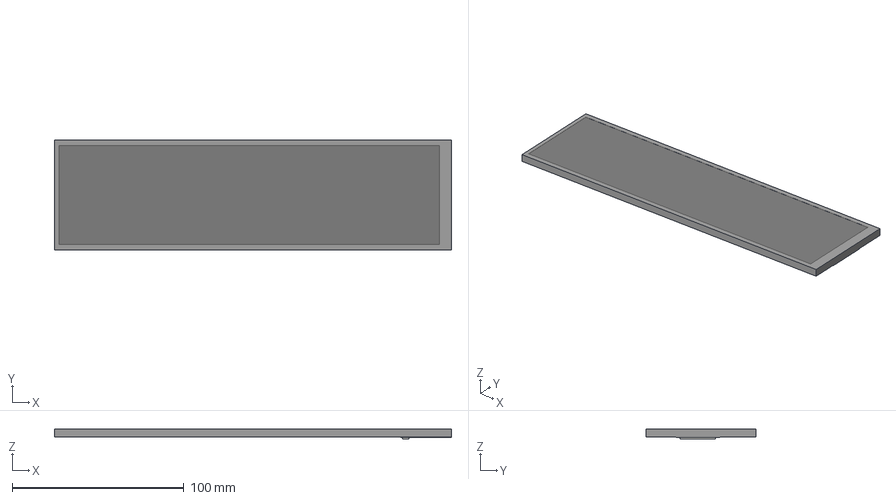
[picture p58: CAD file, 2025-11-15]
Models/Displays/HSD088IPW1-A00.step
231.3 x 64.3 x 6.00 mm
