Daxxn/KiCAD-Component-Library/Models/LEDs/LED_1812_4532Metric.step

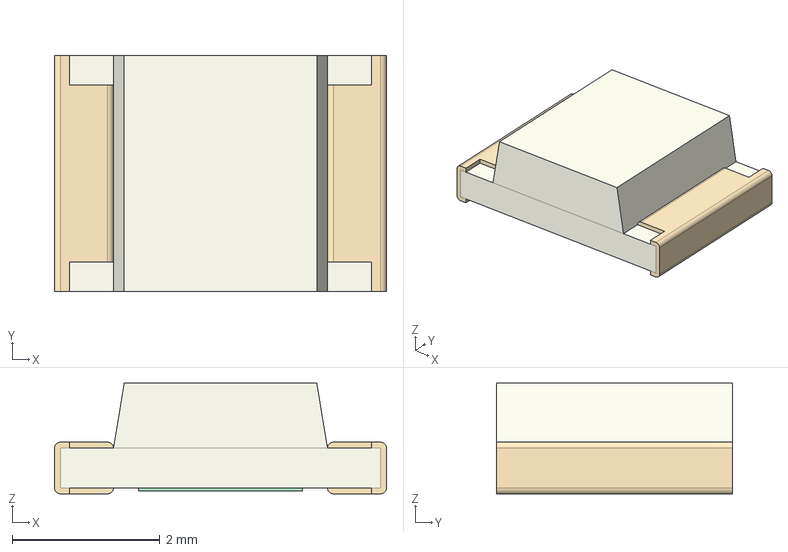
[picture p59: CAD file, 2025-02-12]
Models/LEDs/LED_1812_4532Metric.step
4.50 x 3.20 x 1.50 mm
