Daxxn/KiCAD-Component-Library/Models/Packages/Package_BGA/BGA-100_11.0x11.0mm_Layout10x10_P1.0mm_Ball0.5mm_Pad0.4mm_NSMD.step

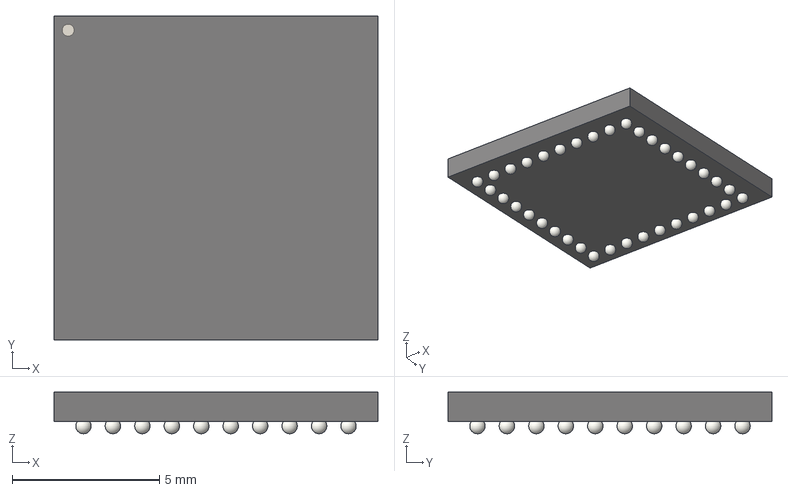
[picture p60: CAD file, 2025-02-12]
Models/Packages/Package_BGA/BGA-100_11.0x11.0mm_Layout10x10_P1.0mm_Ball0.5mm_Pad0.4mm_NSMD.step
11.0 x 11.0 x 1.41 mm
