Daxxn/KiCAD-Component-Library/Models/Packages/Package_CSP/LFCSP-16-1EP_4x4mm_P0.65mm_EP2.6x2.6mm.step

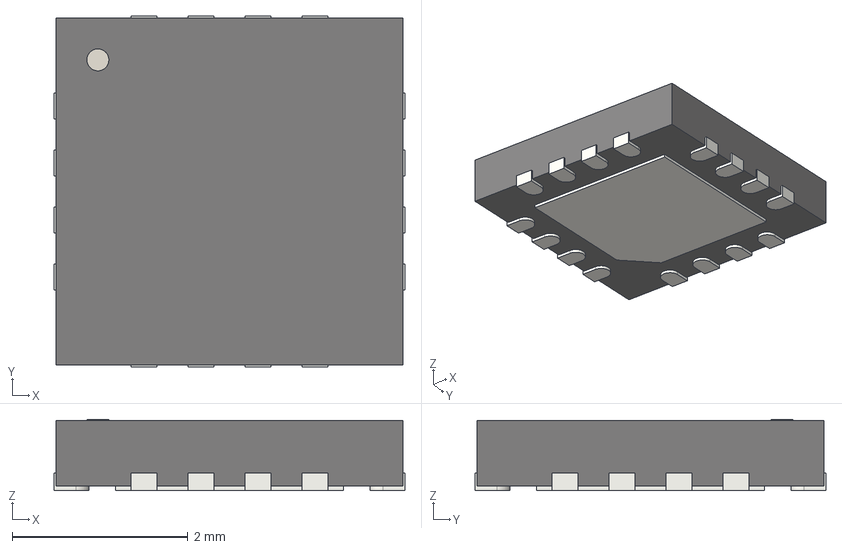
[picture p61: CAD file, 2025-02-12]
Models/Packages/Package_CSP/LFCSP-16-1EP_4x4mm_P0.65mm_EP2.6x2.6mm.step
4.00 x 4.00 x 0.81 mm
2cfbccc0-7fa9-11ed-9d4c-acde48001122_part
2cfbcf72-7fa9-11ed-9d4c-acde48001122_part
2cfbd094-7fa9-11ed-9d4c-acde48001122_part
2cfbd134-7fa9-11ed-9d4c-acde48001122_part
