Daxxn/KiCAD-Component-Library/Models/Packages/Package_DFN_QFN/RWB0012A.stp

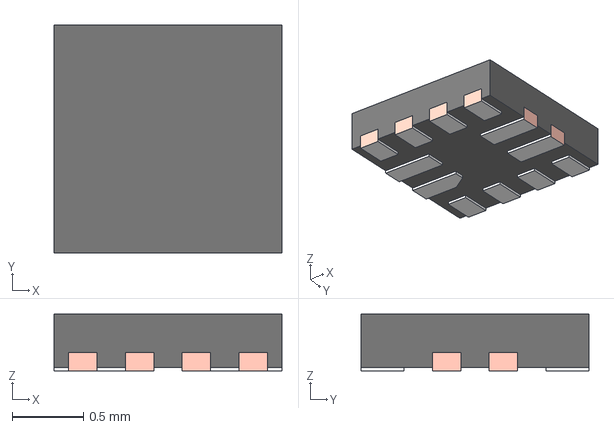
[picture p62: CAD file, 2025-04-12]
Models/Packages/Package_DFN_QFN/RWB0012A.stp
1.60 x 1.60 x 0.4 mm
FRAME-RWB0012A
BODY-QFN
