Daxxn/KiCAD-Component-Library/Models/Packages/Package_DIP/DIP-18_W7.62mm_Socket.step

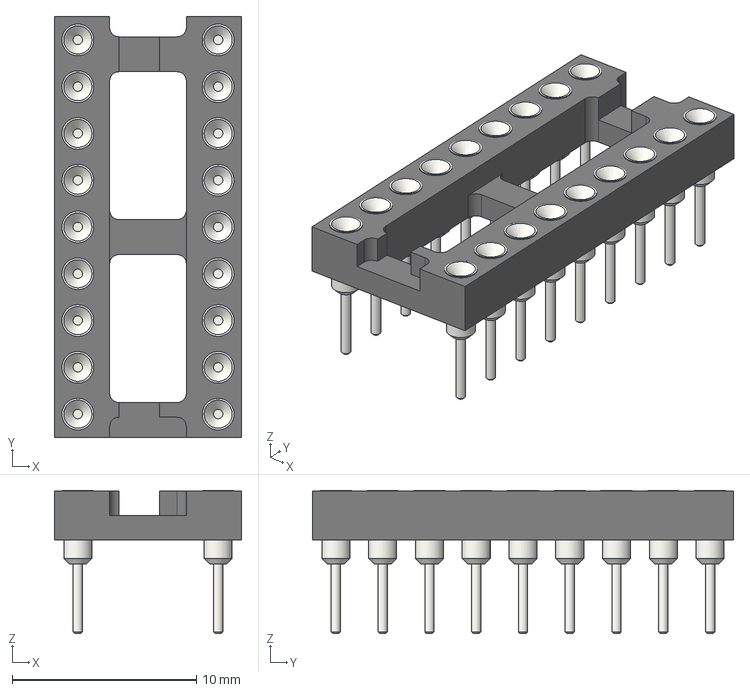
[picture p63: CAD file, 2025-02-12]
Models/Packages/Package_DIP/DIP-18_W7.62mm_Socket.step
10.2 x 22.9 x 7.79 mm
