Daxxn/KiCAD-Component-Library/Models/Packages/Package_DirectFET/DirectFET_MN.step

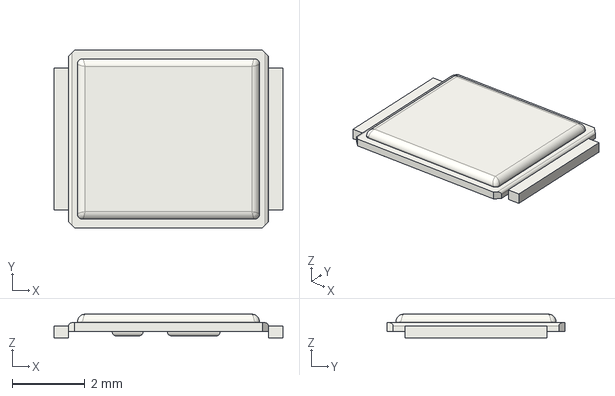
[picture p64: CAD file, 2025-02-12]
Models/Packages/Package_DirectFET/DirectFET_MN.step
6.30 x 4.90 x 0.65 mm
