Daxxn/KiCAD-Component-Library/Models/Packages/Package_LGA/LGA-14_3x5mm_P0.8mm_LayoutBorder1x6y.step

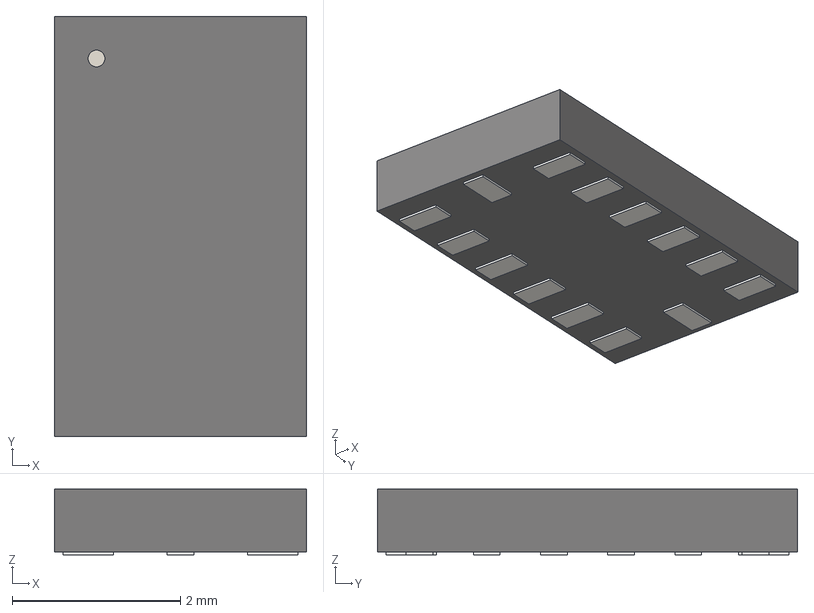
[picture p65: CAD file, 2025-02-12]
Models/Packages/Package_LGA/LGA-14_3x5mm_P0.8mm_LayoutBorder1x6y.step
3.00 x 5.00 x 0.78 mm
