Daxxn/KiCAD-Component-Library/Models/Packages/Package_QFP/LQFP-100_14x14mm_P0.5mm.step

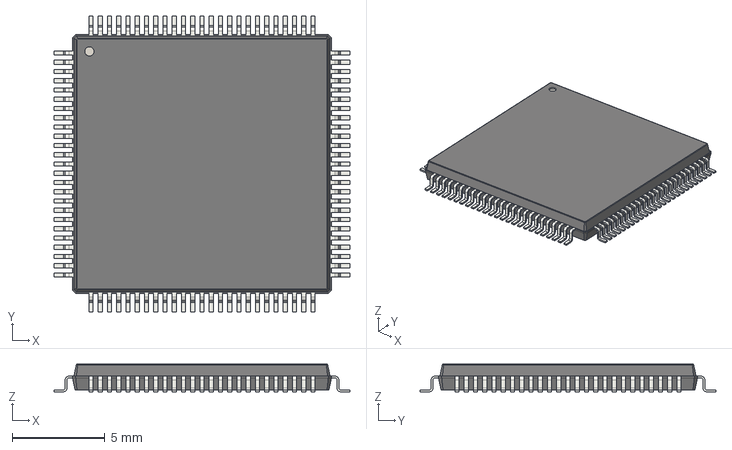
[picture p66: CAD file, 2025-02-12]
Models/Packages/Package_QFP/LQFP-100_14x14mm_P0.5mm.step
16.0 x 16.0 x 1.50 mm
