Daxxn/KiCAD-Component-Library/Models/Packages/Package_SIP/SIP-8_19x3mm_P2.54mm.step

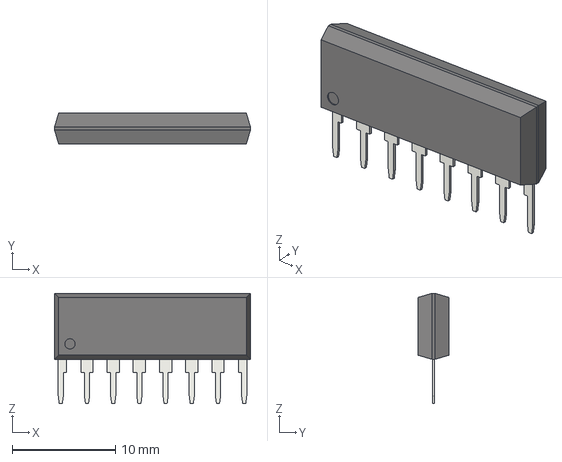
[picture p67: CAD file, 2025-02-12]
Models/Packages/Package_SIP/SIP-8_19x3mm_P2.54mm.step
19.0 x 3.00 x 10.7 mm
