Daxxn/KiCAD-Component-Library/Models/Packages/Package_SO/SSOP-20_5.3x7.2mm_P0.65mm.step

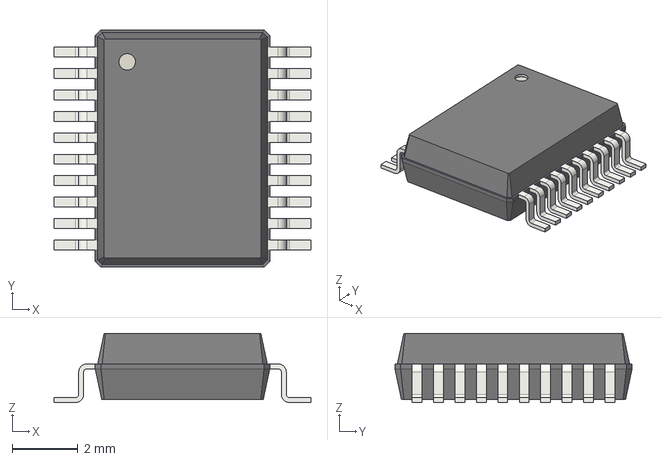
[picture p68: CAD file, 2025-02-12]
Models/Packages/Package_SO/SSOP-20_5.3x7.2mm_P0.65mm.step
7.80 x 7.20 x 2.10 mm
