Daxxn/KiCAD-Component-Library/Models/Packages/Package_SON/DSQ0010A.stp

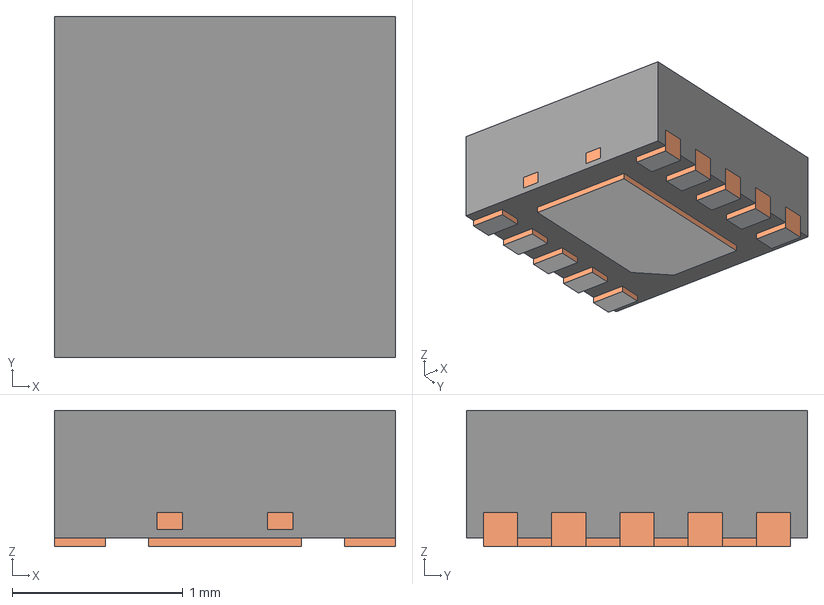
[picture p69: CAD file, 2025-04-12]
Models/Packages/Package_SON/DSQ0010A.stp
2.00 x 2.00 x 0.8 mm
BODY-SON
FRAME-DSQ0010A
PIN1-ID
