Daxxn/KiCAD-Component-Library/Models/Packages/Package_TO_SOT_SMD/TO-252-3_TabPin2.step

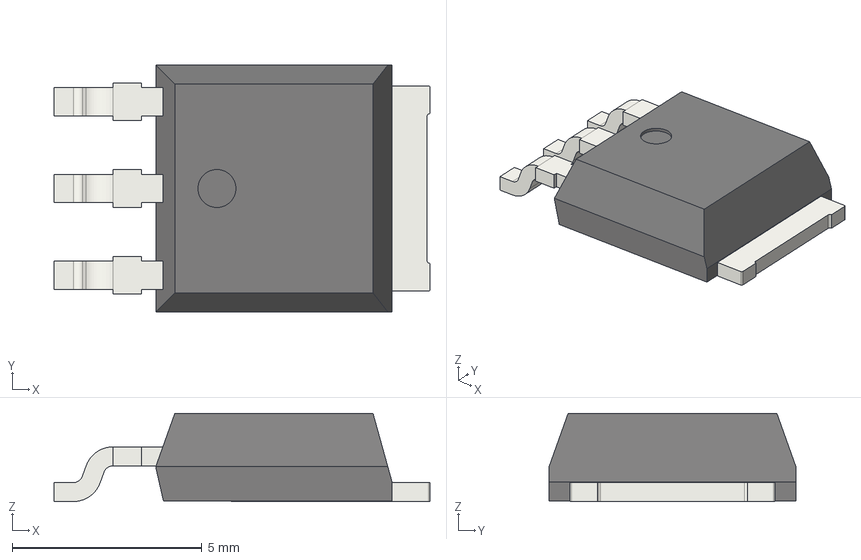
[picture p70: CAD file, 2025-02-12]
Models/Packages/Package_TO_SOT_SMD/TO-252-3_TabPin2.step
9.90 x 6.50 x 2.32 mm
98f8d7e1-9c39-11ed-93f0-dde97e994e83_part
98f8d7e2-9c39-11ed-93f0-dde97e994e83_part
98f8d7e3-9c39-11ed-93f0-dde97e994e83_part
