Daxxn/KiCAD-Component-Library/Models/Packages/Package_TO_SOT_THT/TO-11-2_Window.step

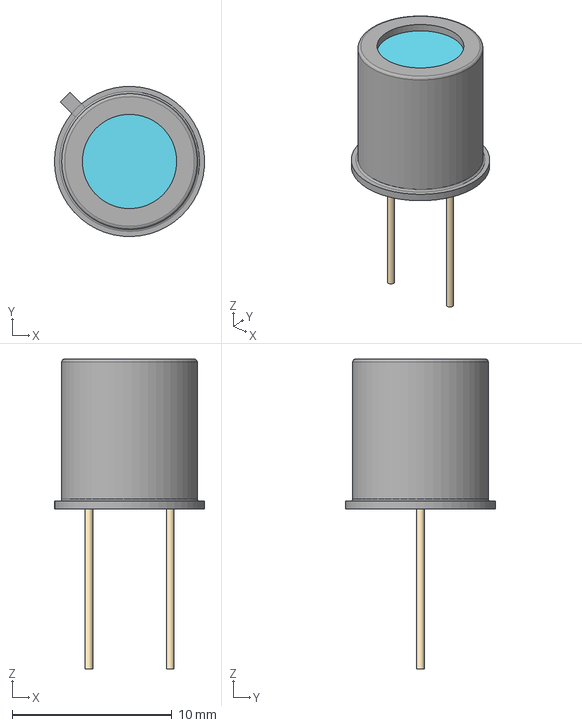
[picture p71: CAD file, 2025-02-12]
Models/Packages/Package_TO_SOT_THT/TO-11-2_Window.step
9.39 x 9.39 x 19.4 mm
