Daxxn/KiCAD-Component-Library/Models/Packages/SOT-223.step

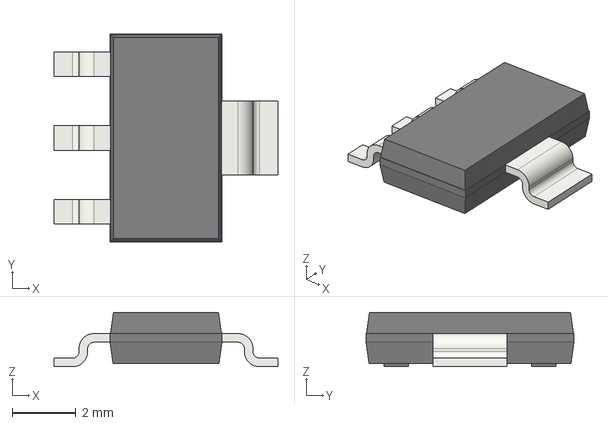
[picture p72: CAD file, 2025-02-12]
Models/Packages/SOT-223.step
7.00 x 6.50 x 1.70 mm
