Daxxn/KiCAD-Component-Library/Models/Packages/Transistor_Power_Module/ST_ACEPACK-2-CIB.step

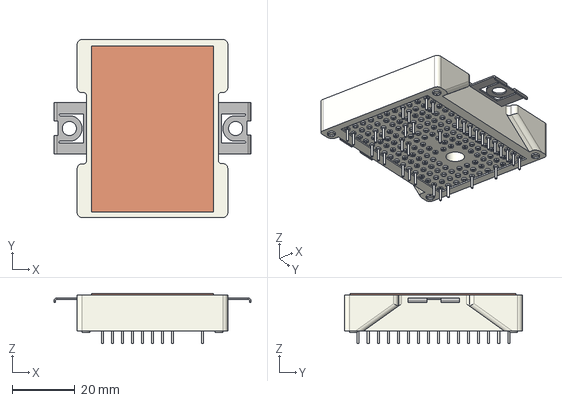
[picture p73: CAD file, 2025-02-12]
Models/Packages/Transistor_Power_Module/ST_ACEPACK-2-CIB.step
62.8 x 56.7 x 16.0 mm
