Daxxn/KiCAD-Component-Library/Models/Passives/Capacitors/C_Elec_8x5.4.step

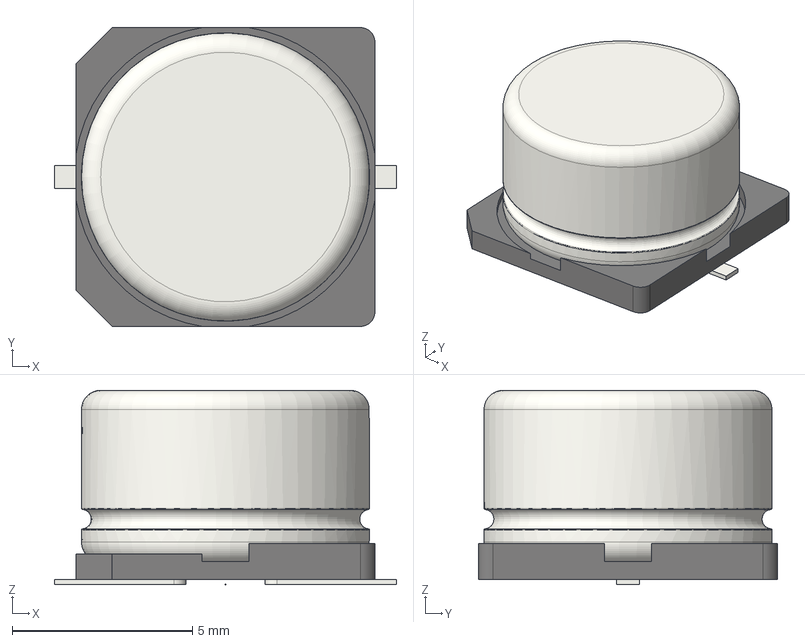
[picture p74: CAD file, 2025-02-12]
Models/Passives/Capacitors/C_Elec_8x5.4.step
9.50 x 8.30 x 5.40 mm
