Daxxn/KiCAD-Component-Library/Models/Passives/Crystals/Crystal_C38-LF_D3.0mm_L8.0mm_Horizontal.step

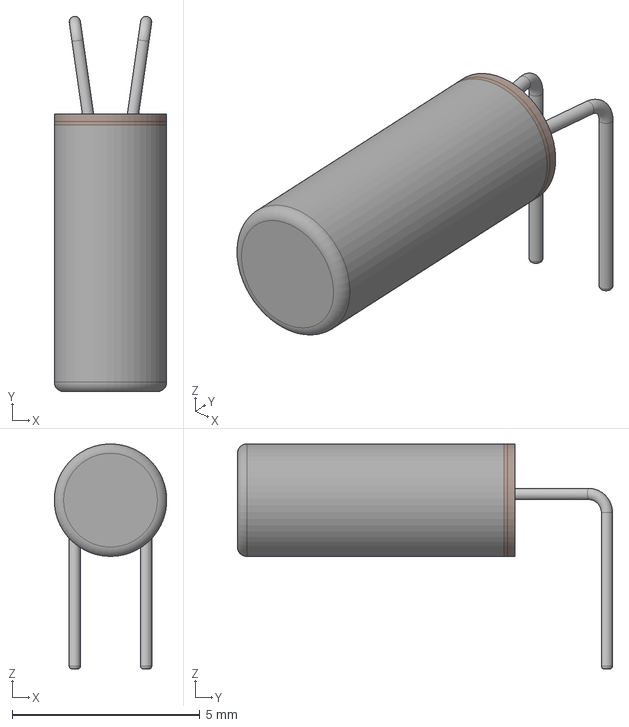
[picture p75: CAD file, 2025-02-12]
Models/Passives/Crystals/Crystal_C38-LF_D3.0mm_L8.0mm_Horizontal.step
3.00 x 10.00 x 6.00 mm
