Daxxn/KiCAD-Component-Library/Models/Passives/Diodes/D_2114_3652Metric.step

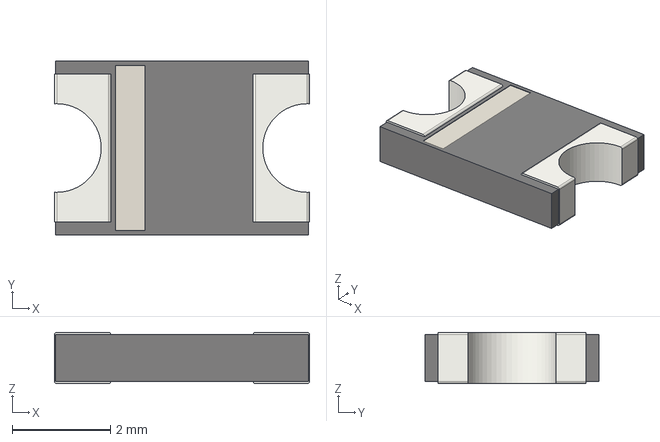
[picture p76: CAD file, 2025-02-12]
Models/Passives/Diodes/D_2114_3652Metric.step
5.20 x 3.55 x 1.05 mm
