Daxxn/KiCAD-Component-Library/Models/Passives/Inductors/LQH32DN3R3M53L.step

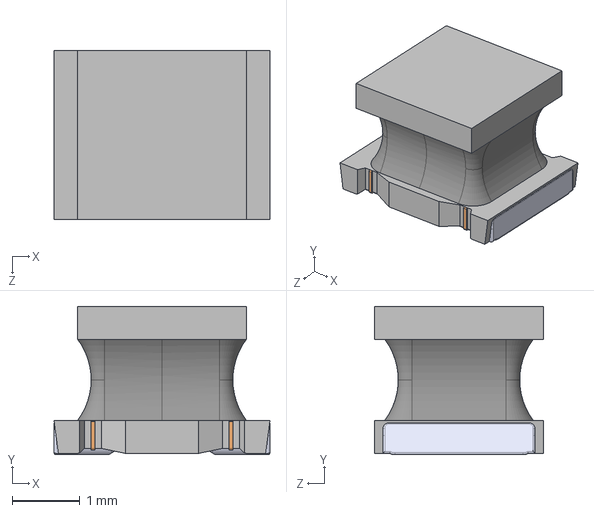
[picture p77: CAD file, 2025-04-12]
Models/Passives/Inductors/LQH32DN3R3M53L.step
3.20 x 2.20 x 2.50 mm
