Daxxn/KiCAD-Component-Library/Models/Passives/Resistors/R_Shunt_Ohmite_LVK25.step

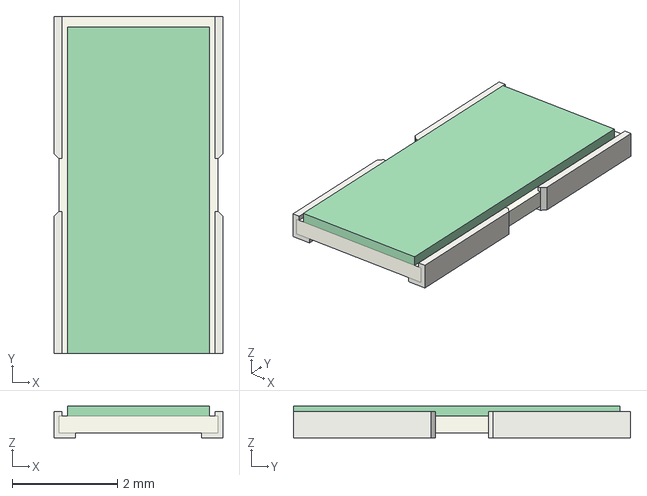
[picture p78: CAD file, 2025-02-12]
Models/Passives/Resistors/R_Shunt_Ohmite_LVK25.step
3.20 x 6.40 x 0.6 mm
