Daxxn/KiCAD-Component-Library/Models/Protection/3557-10.step

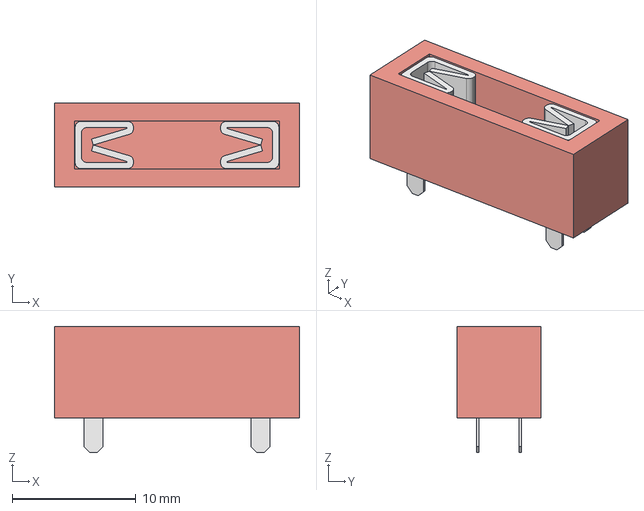
[picture p79: CAD file, 2022-10-09]
Models/Protection/3557-10.step
19.8 x 6.80 x 10.2 mm
