Daxxn/KiCAD-Component-Library/Models/Relays/J1512CT12VDC.9D.stp

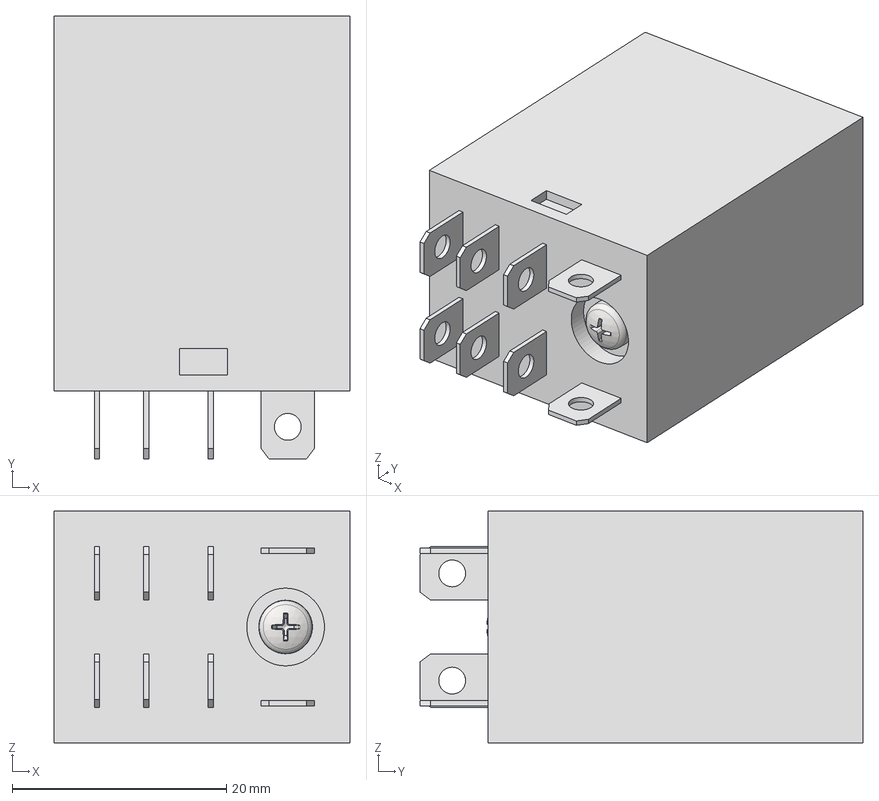
[picture p80: CAD file, 2025-04-12]
Models/Relays/J1512CT12VDC.9D.stp
27.6 x 41.3 x 21.6 mm
COVER
TERMINAL x 8
EN ISO 7045 - M2.5 x 3 - 4.8 - H
