Daxxn/KiCAD-Component-Library/Models/Sensors/FuleLevelSenderHousing v2.step

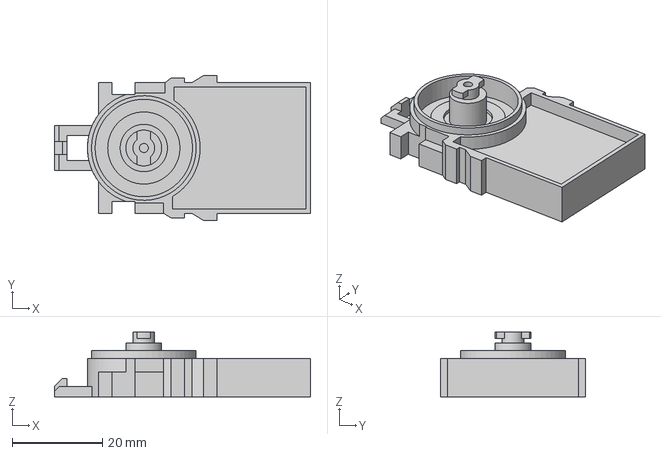
[picture p81: CAD file, 2022-10-09]
Models/Sensors/FuleLevelSenderHousing v2.step
56.8 x 32.1 x 14.4 mm
