Daxxn/KiCAD-Component-Library/Models/Thermal/7106DG.step

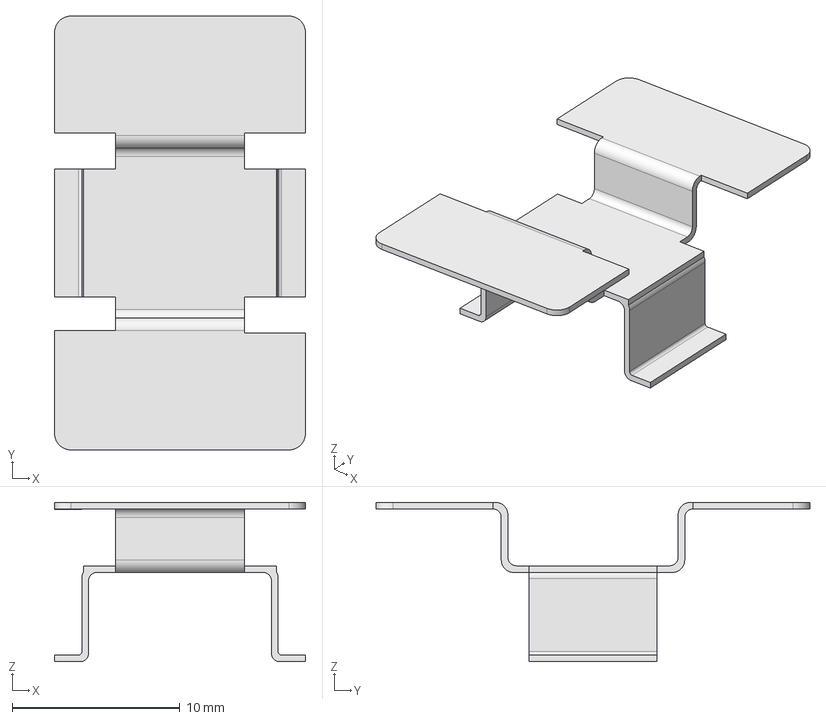
[picture p82: CAD file, 2025-04-12]
Models/Thermal/7106DG.step
15.0 x 25.9 x 9.52 mm
