Daxxn/KiCAD-Component-Library/Models/Transformer/Transformer_CHK_EI48-10VA_1xSec.step

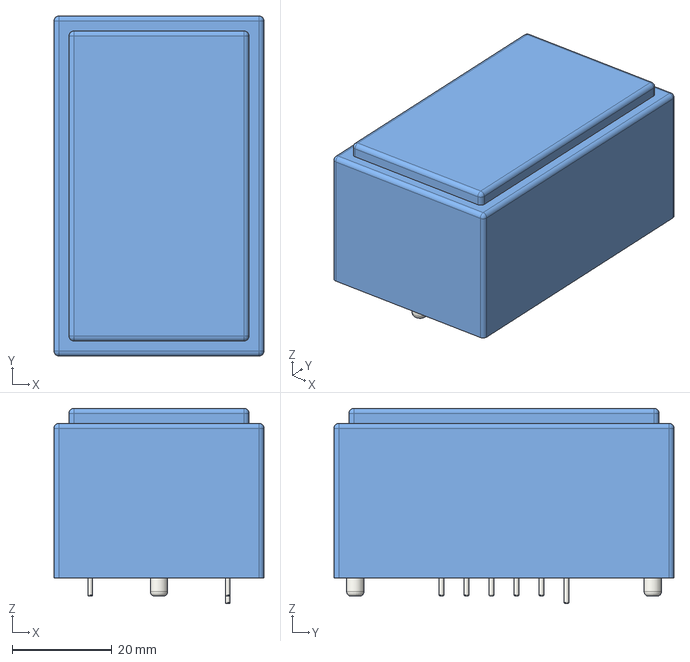
[picture p83: CAD file, 2025-04-12]
Models/Transformer/Transformer_CHK_EI48-10VA_1xSec.step
42.0 x 68.0 x 39.1 mm
Transformer_CHK_EI48_10VA_1xSec001
Transformer_CHK_EI48_10VA_1xSec
