Daxxn/KiCAD-Component-Library/Models/Arduino/ARDUINO-MEGA-2560 v10.step

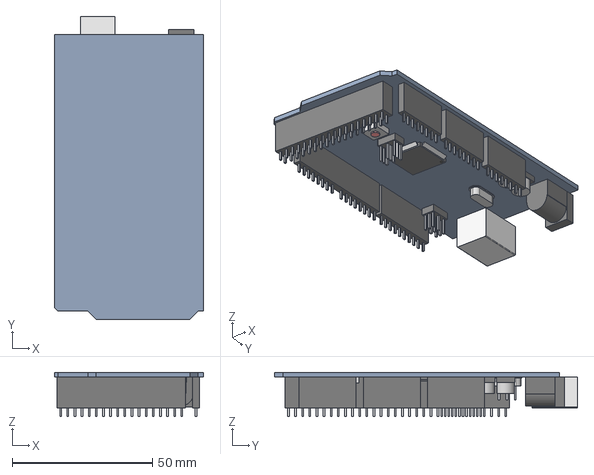
[picture p84: CAD file, 2022-10-09]
Models/Arduino/ARDUINO-MEGA-2560 v10.step
53.2 x 108.0 x 15.9 mm
