Daxxn/KiCAD-Component-Library/Models/Connectors/Connector_DSUB/K66X(HT)-A26P-N_rA4.step

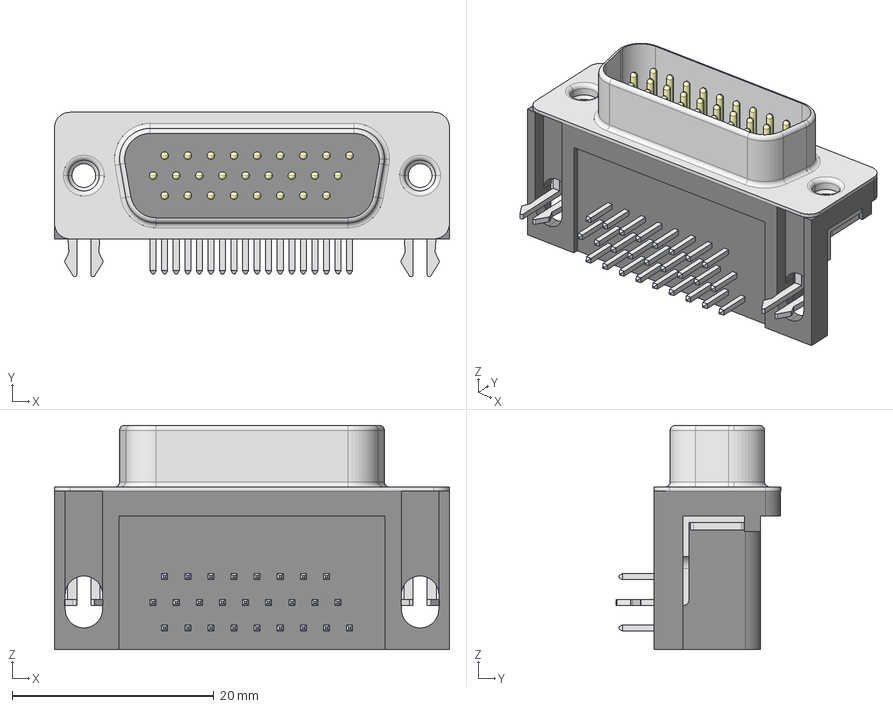
[picture p85: CAD file, 2025-04-12]
Models/Connectors/Connector_DSUB/K66X(HT)-A26P-N_rA4.step
39.1 x 16.3 x 22.2 mm
