Daxxn/KiCAD-Component-Library/Models/Connectors/Connector_Ethernet/RJMG1BD3B8K1ANR.step

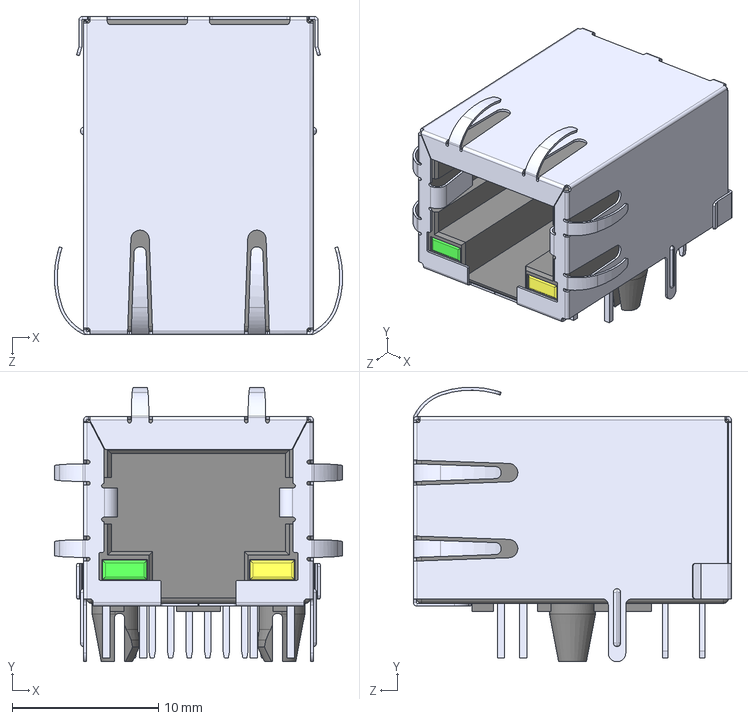
[picture p86: CAD file, 2025-04-12]
Models/Connectors/Connector_Ethernet/RJMG1BD3B8K1ANR.step
19.7 x 18.8 x 21.8 mm
