Daxxn/KiCAD-Component-Library/Models/Connectors/Connector_PinHeader_2.54mm/PinHeader_1x32_P2.54mm_Horizontal.step

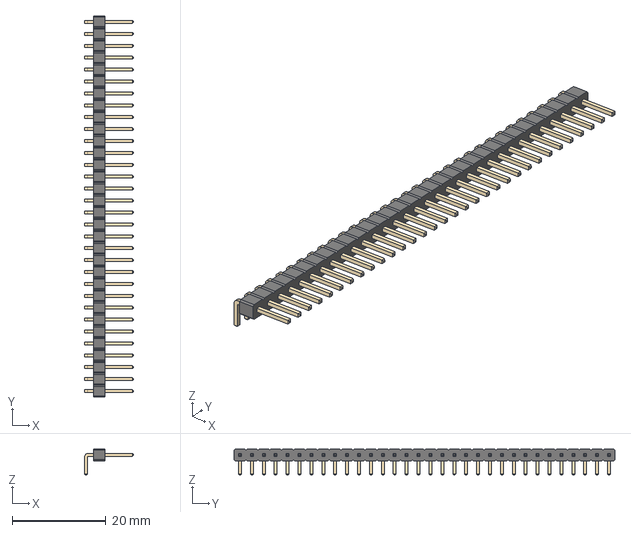
[picture p87: CAD file, 2025-02-12]
Models/Connectors/Connector_PinHeader_2.54mm/PinHeader_1x32_P2.54mm_Horizontal.step
10.4 x 81.3 x 5.54 mm
