Daxxn/KiCAD-Component-Library/Models/Connectors/Connector_Samtec/LSHM-110-02.5-L-DV-A-N-K-TR.step

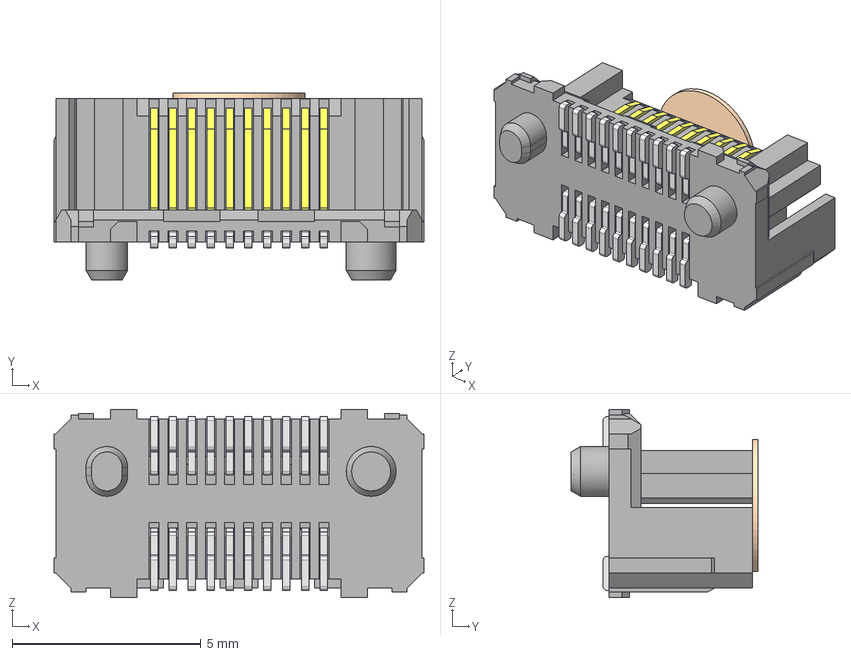
[picture p88: CAD file, 2025-04-12]
Models/Connectors/Connector_Samtec/LSHM-110-02.5-L-DV-A-N-K-TR.step
9.80 x 4.95 x 4.98 mm
K-DOT-.138-.250-.005.pp
C-185--10-02.5-DV1P2 L
C-185--10-02.5-L-DV1P
LSHM-10-02.5-DV-A-N_STRIP
