Daxxn/KiCAD-Component-Library/Models/Connectors/Connector_Samtec_HPM_THT/Samtec_HPM-01-01-x-S_Straight_1x01_Pitch5.08mm.step

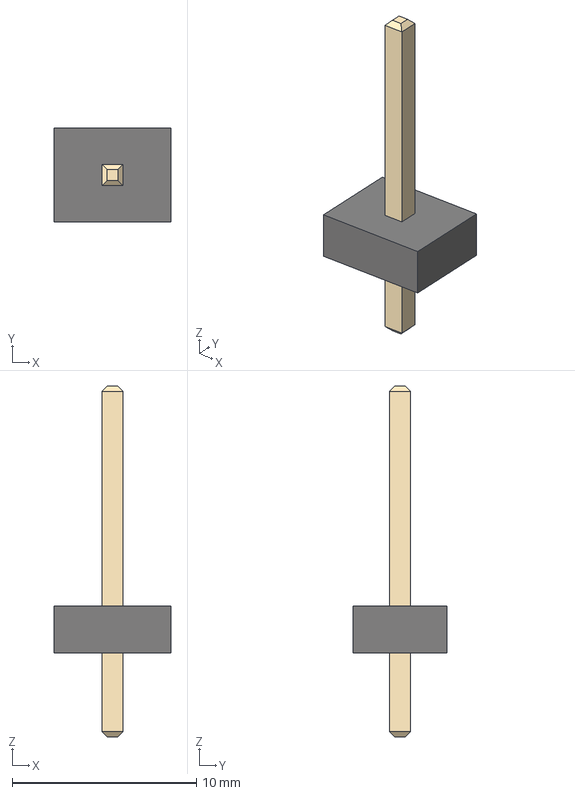
[picture p89: CAD file, 2025-04-12]
Models/Connectors/Connector_Samtec_HPM_THT/Samtec_HPM-01-01-x-S_Straight_1x01_Pitch5.08mm.step
6.35 x 5.08 x 19.1 mm
ce0b80dc-8c20-11ed-9f4e-a0cec80452fd_part
ce0b8596-8c20-11ed-9f4e-a0cec80452fd_part
ce0b885c-8c20-11ed-9f4e-a0cec80452fd_part
