Daxxn/KiCAD-Component-Library/Models/Connectors/Connector_Terminal/7698.STEP

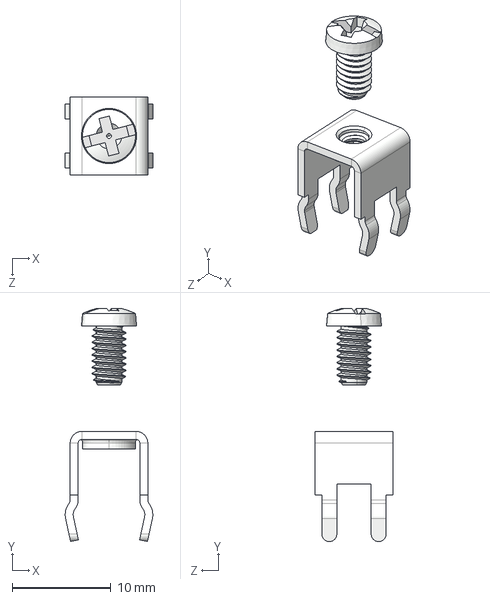
[picture p90: CAD file, 2025-04-12]
Models/Connectors/Connector_Terminal/7698.STEP
8.89 x 23.6 x 7.87 mm
