Daxxn/KiCAD-Component-Library/Models/Controls/229A series.stp

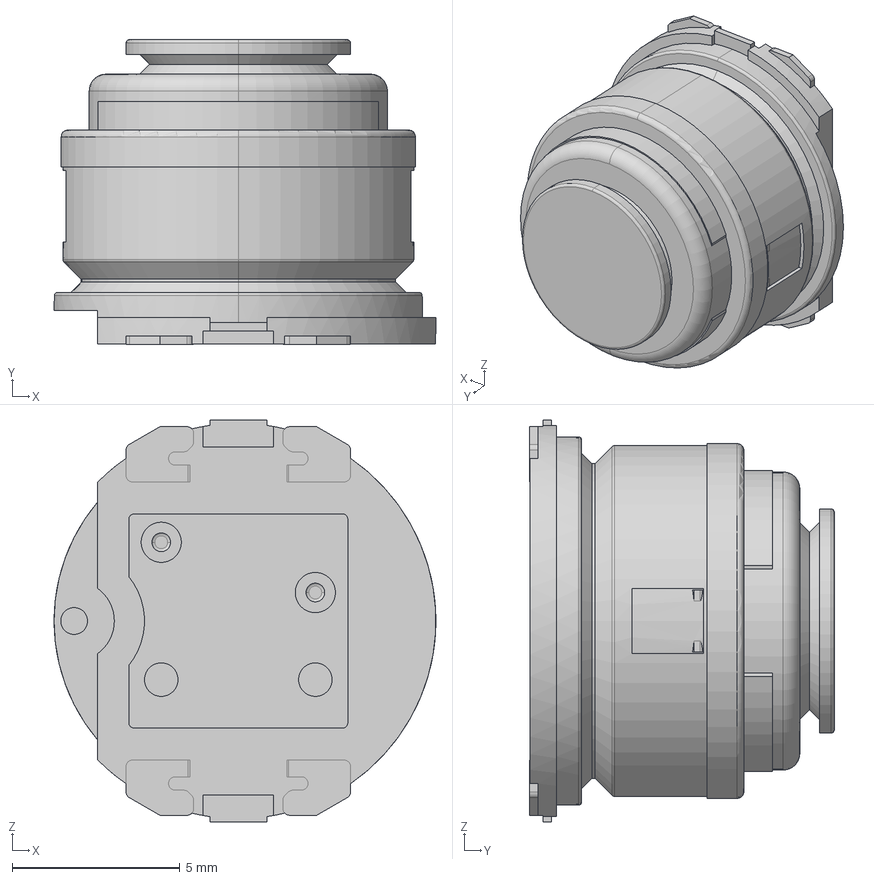
[picture p91: CAD file, 2025-04-12]
Models/Controls/229A series.stp
11.4 x 9.09 x 12.0 mm
