Daxxn/KiCAD-Component-Library/Models/Displays/NHD-C0220BiZ-FSW-FBW-3V3M.STEP

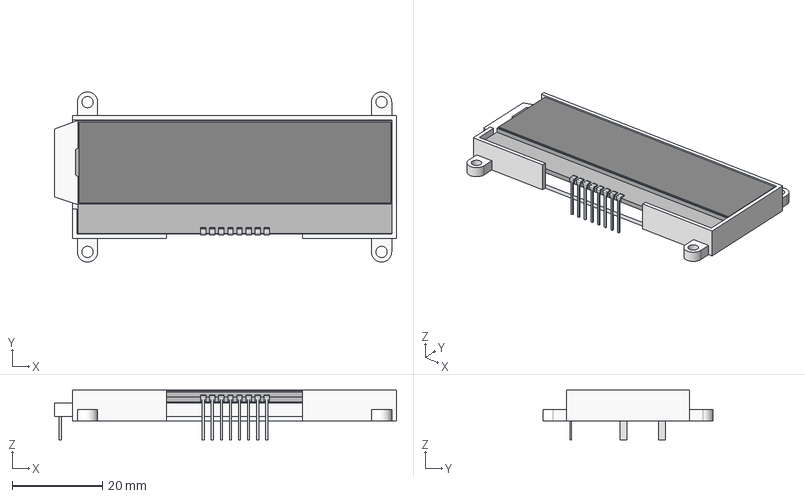
[picture p92: CAD file, 2025-04-12]
Models/Displays/NHD-C0220BiZ-FSW-FBW-3V3M.STEP
75.6 x 37.6 x 11.0 mm
PRT0001 x 8
1112W-3
LCD
