Daxxn/KiCAD-Component-Library/Models/Hardware/Standoff-Alum-M3-15.stp

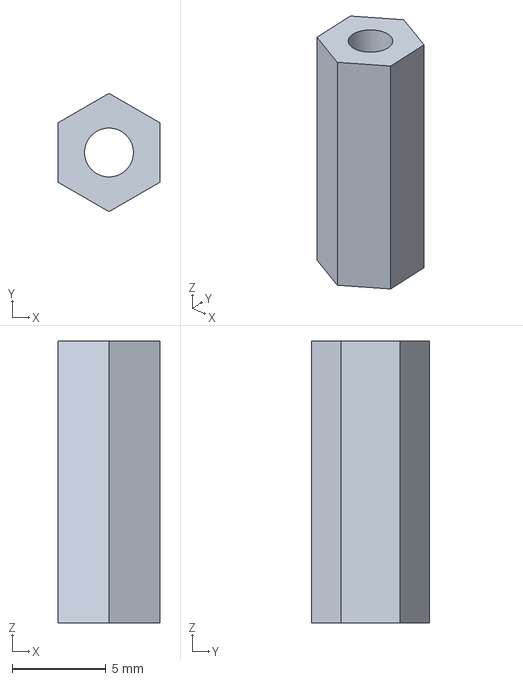
[picture p93: CAD file, 2022-10-09]
Models/Hardware/Standoff-Alum-M3-15.stp
5.45 x 6.29 x 15.0 mm
