Daxxn/KiCAD-Component-Library/Models/LEDs/LED_1206_3216Metric.step

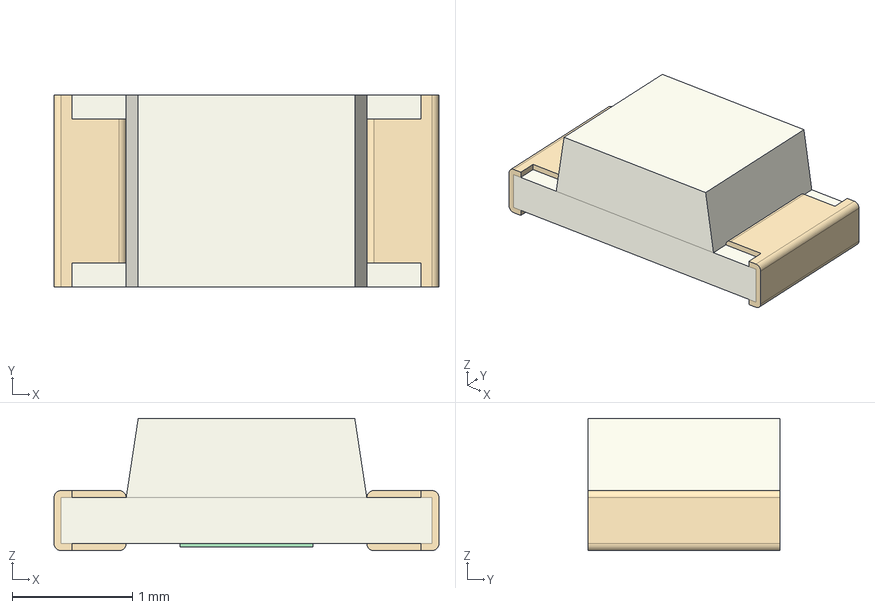
[picture p94: CAD file, 2025-02-12]
Models/LEDs/LED_1206_3216Metric.step
3.20 x 1.60 x 1.10 mm
