Daxxn/KiCAD-Component-Library/Models/Modules/1602A-LCD v3.step

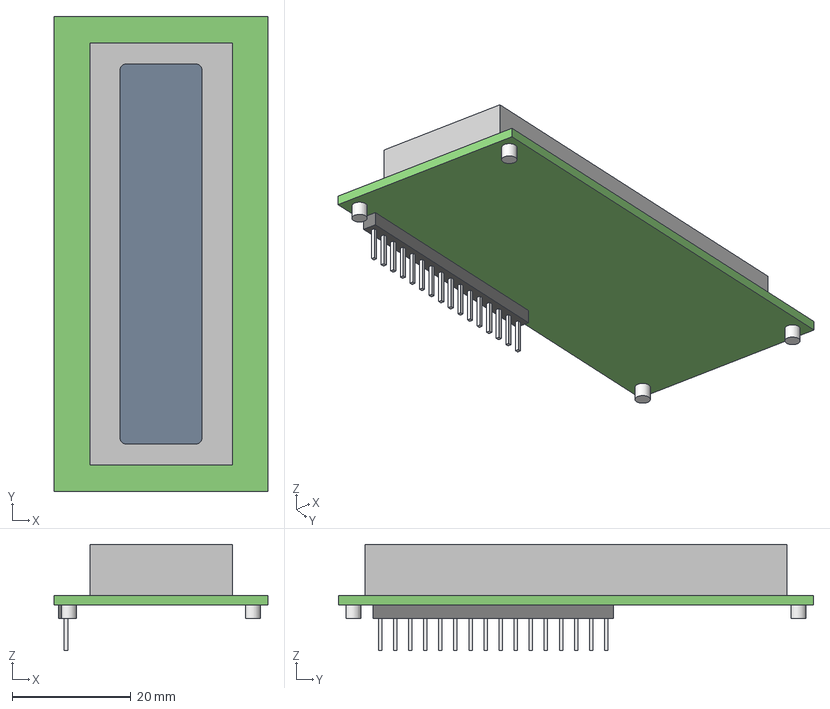
[picture p95: CAD file, 2022-10-09]
Models/Modules/1602A-LCD v3.step
36.0 x 80.0 x 17.9 mm
