Daxxn/KiCAD-Component-Library/Models/Packages/Package_BGA/UFBGA-176+25_P0.65mm_B10x10mm.step

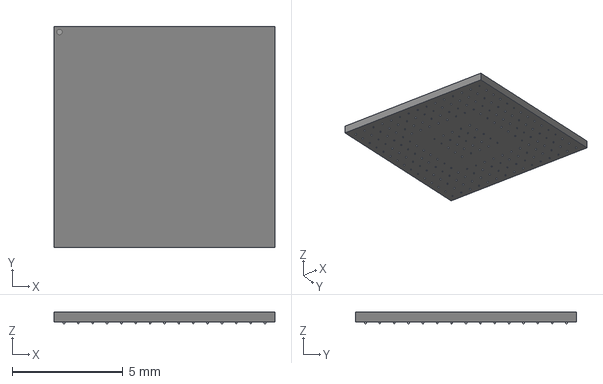
[picture p96: CAD file, 2025-02-12]
Models/Packages/Package_BGA/UFBGA-176+25_P0.65mm_B10x10mm.step
10.0 x 10.0 x 0.53 mm
