Daxxn/KiCAD-Component-Library/Models/Packages/Package_CSP/LFCSP-20-1EP_4x4mm_P0.5mm_EP2.5x2.5mm.step

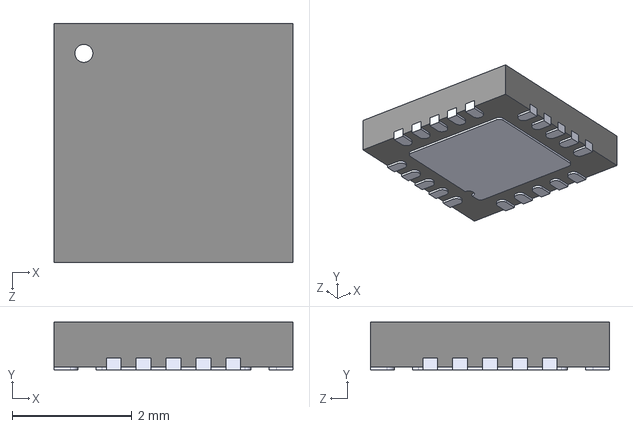
[picture p97: CAD file, 2025-02-12]
Models/Packages/Package_CSP/LFCSP-20-1EP_4x4mm_P0.5mm_EP2.5x2.5mm.step
4.00 x 0.8 x 4.00 mm
