Daxxn/KiCAD-Component-Library/Models/Packages/Package_DFN_QFN/DFN-8_2x2mm_P0.5mm.step

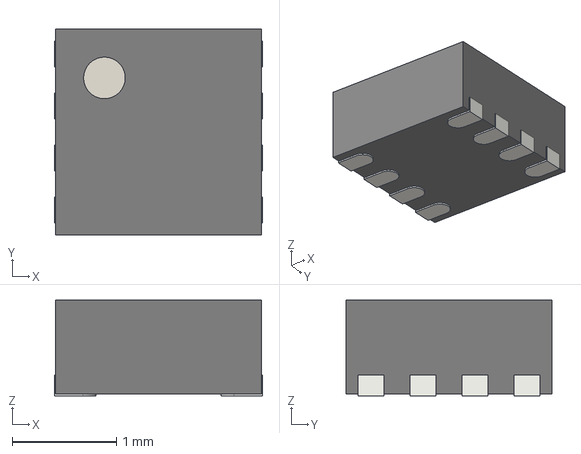
[picture p98: CAD file, 2025-02-12]
Models/Packages/Package_DFN_QFN/DFN-8_2x2mm_P0.5mm.step
2.00 x 1.98 x 0.92 mm
