Daxxn/KiCAD-Component-Library/Models/Packages/Package_DIP/SMDIP-4_W9.53mm_Clearance8mm.step

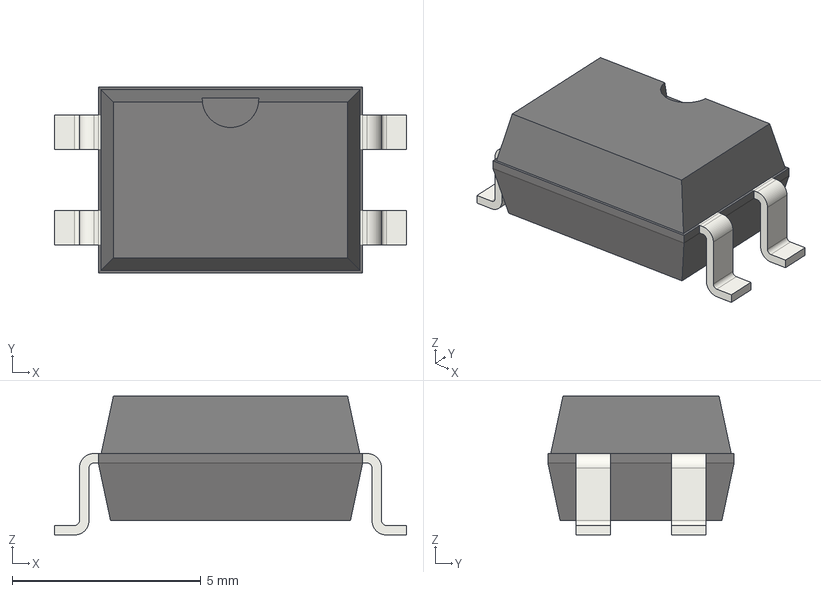
[picture p99: CAD file, 2025-02-12]
Models/Packages/Package_DIP/SMDIP-4_W9.53mm_Clearance8mm.step
9.32 x 4.93 x 3.68 mm
