Daxxn/KiCAD-Component-Library/Models/Packages/Package_DirectFET/DirectFET_SQ.step

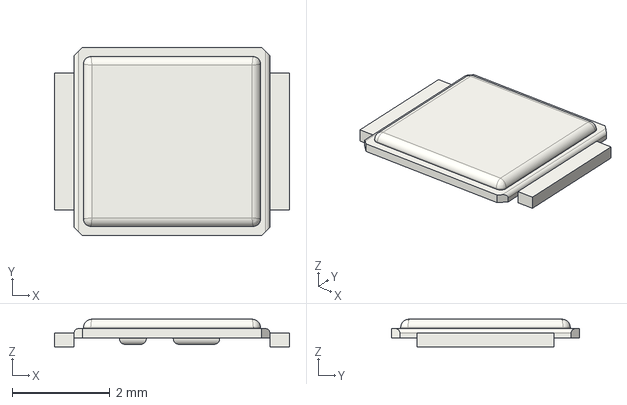
[picture p100: CAD file, 2025-02-12]
Models/Packages/Package_DirectFET/DirectFET_SQ.step
4.80 x 3.85 x 0.565 mm
