Daxxn/KiCAD-Component-Library/Models/Packages/Package_LGA/VLGA-4_2x2.5mm_P1.65mm.step

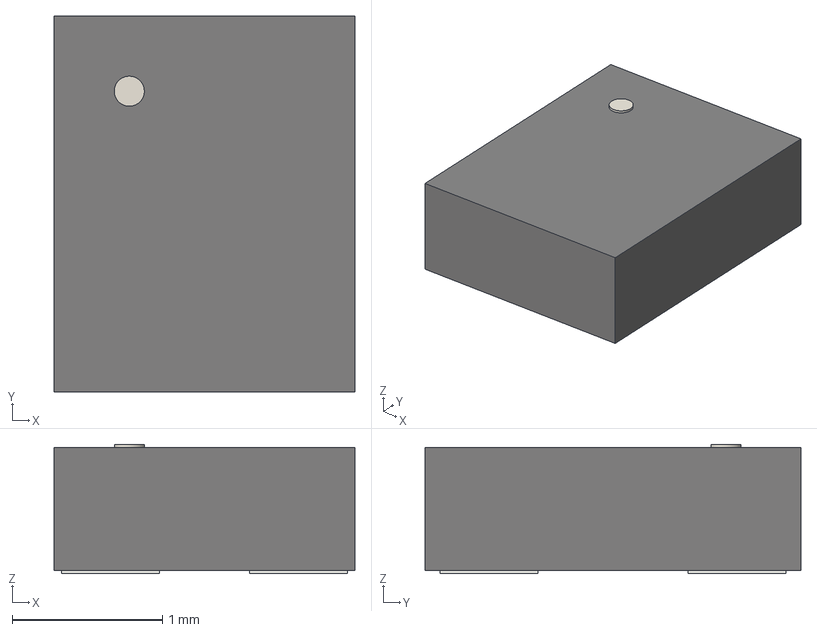
[picture p101: CAD file, 2025-02-12]
Models/Packages/Package_LGA/VLGA-4_2x2.5mm_P1.65mm.step
2.00 x 2.50 x 0.86 mm
acd0f824-8c67-11ed-a6ab-acde48001122_part
acd0fce8-8c67-11ed-a6ab-acde48001122_part
acd0fe14-8c67-11ed-a6ab-acde48001122_part
acd0fee6-8c67-11ed-a6ab-acde48001122_part
