Daxxn/KiCAD-Component-Library/Models/Packages/Package_QFP/TQFP-100_14x14mm_P0.5mm_EP5x5mm.step

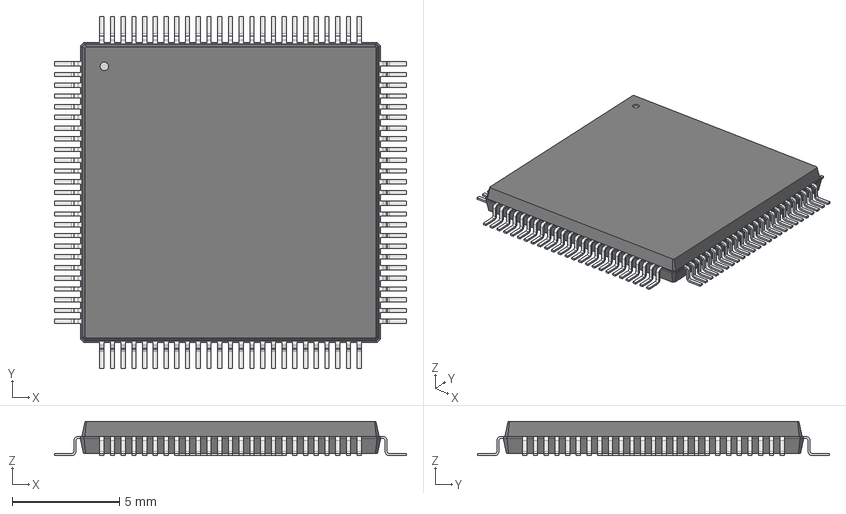
[picture p102: CAD file, 2025-02-12]
Models/Packages/Package_QFP/TQFP-100_14x14mm_P0.5mm_EP5x5mm.step
16.4 x 16.4 x 1.60 mm
