Daxxn/KiCAD-Component-Library/Models/Packages/Package_SIP/SIP-9_21.54x3mm_P2.54mm.step

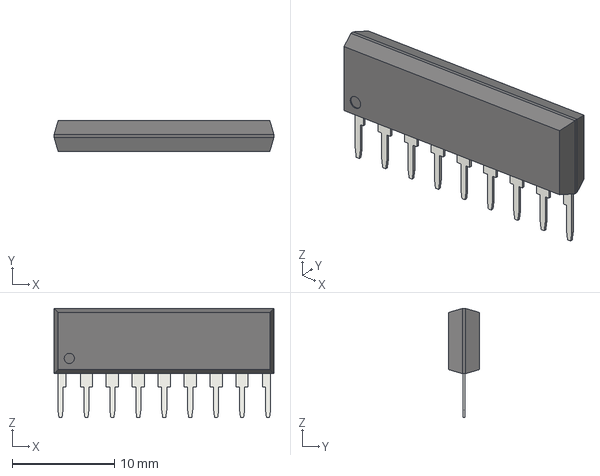
[picture p103: CAD file, 2025-02-12]
Models/Packages/Package_SIP/SIP-9_21.54x3mm_P2.54mm.step
21.5 x 3.00 x 10.7 mm
