Daxxn/KiCAD-Component-Library/Models/Packages/Package_SO/TSSOP-16-1EP_4.4x5mm_P0.65mm.step

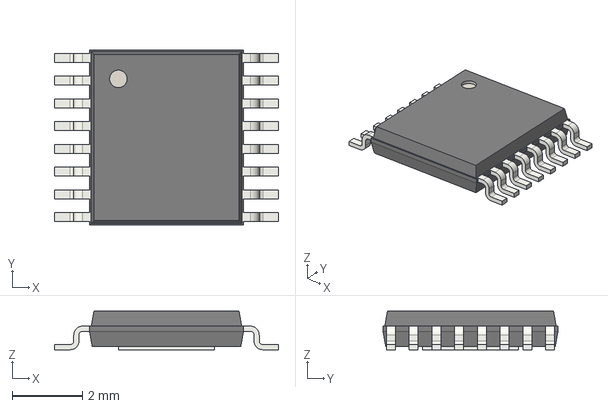
[picture p104: CAD file, 2025-02-12]
Models/Packages/Package_SO/TSSOP-16-1EP_4.4x5mm_P0.65mm.step
6.40 x 5.00 x 1.10 mm
