Daxxn/KiCAD-Component-Library/Models/Packages/Package_SON/WSON-8_4x4mm_P0.8mm.step

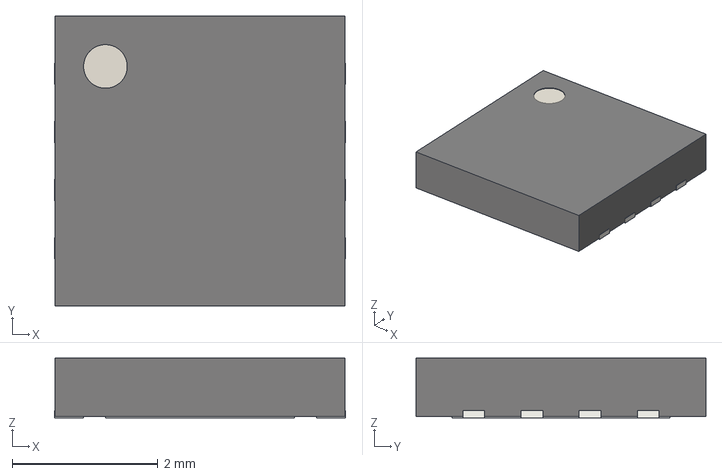
[picture p105: CAD file, 2025-02-12]
Models/Packages/Package_SON/WSON-8_4x4mm_P0.8mm.step
4.00 x 3.98 x 0.82 mm
