Daxxn/KiCAD-Component-Library/Models/Packages/Package_TO_SOT_SMD/TSOT-23-5.step

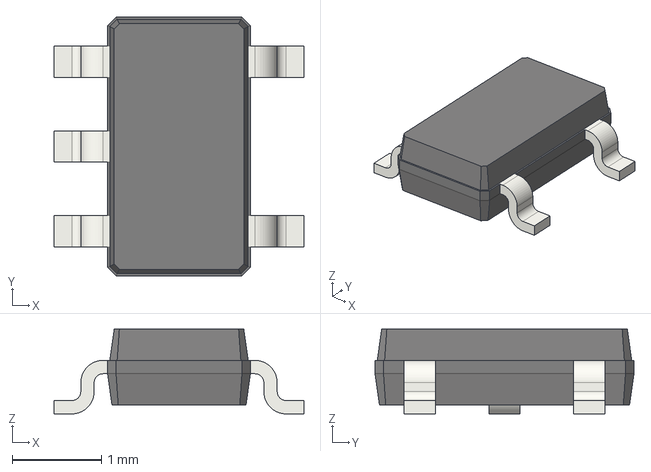
[picture p106: CAD file, 2025-02-12]
Models/Packages/Package_TO_SOT_SMD/TSOT-23-5.step
2.80 x 2.90 x 0.95 mm
