Daxxn/KiCAD-Component-Library/Models/Packages/Package_TO_SOT_THT/TO-92L-2.step

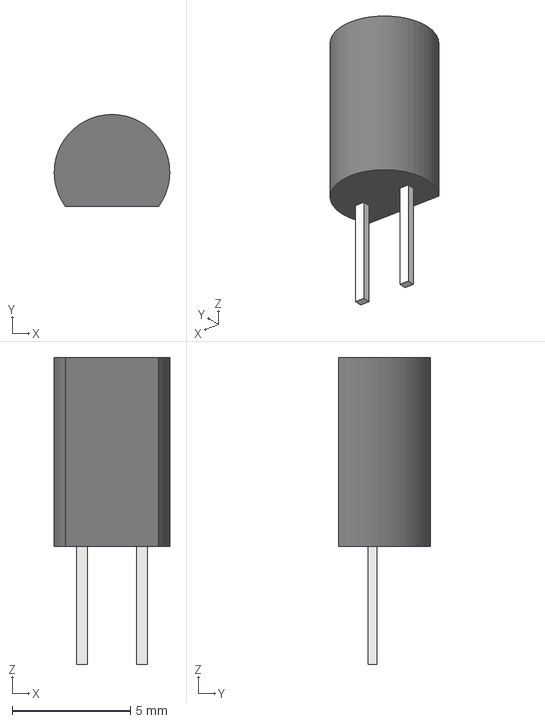
[picture p107: CAD file, 2025-02-12]
Models/Packages/Package_TO_SOT_THT/TO-92L-2.step
4.90 x 3.90 x 13.0 mm
