Daxxn/KiCAD-Component-Library/Models/Packages/QFN-64-1EP_8x8mm_P0.4mm_EP6.5x6.5mm.step

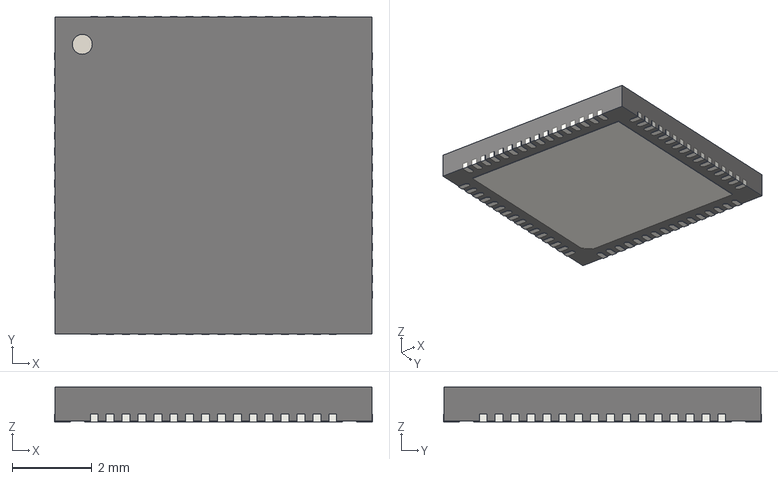
[picture p108: CAD file, 2025-02-12]
Models/Packages/QFN-64-1EP_8x8mm_P0.4mm_EP6.5x6.5mm.step
8.00 x 8.00 x 0.87 mm
