Daxxn/KiCAD-Component-Library/Models/Passives/Capacitors/C_3640_9110Metric.step

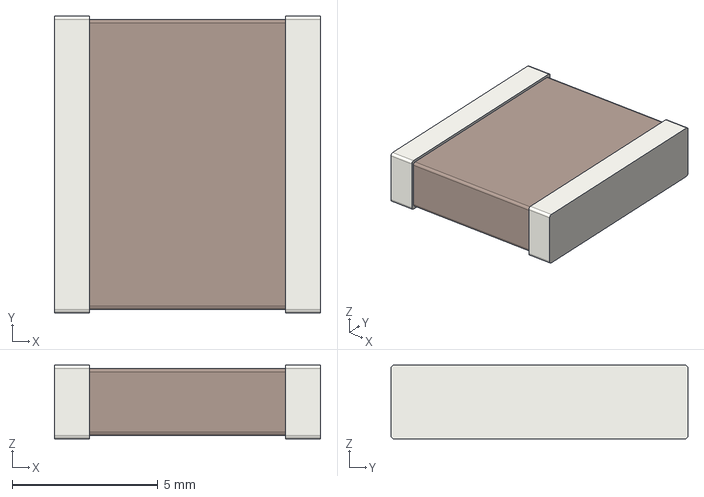
[picture p109: CAD file, 2025-02-12]
Models/Passives/Capacitors/C_3640_9110Metric.step
9.14 x 10.2 x 2.54 mm
