Daxxn/KiCAD-Component-Library/Models/Passives/Crystals/Crystal_SMD_SeikoEpson_FA238-4Pin_3.2x2.5mm_HandSoldering.step

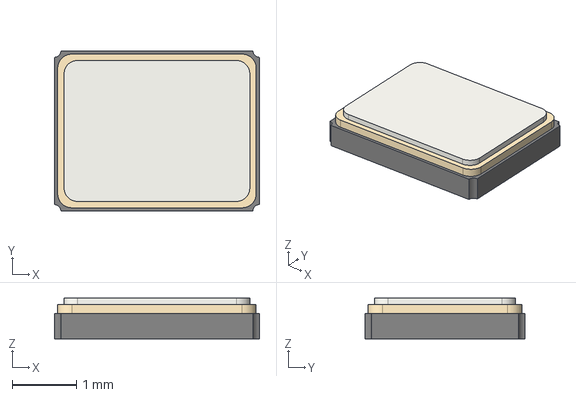
[picture p110: CAD file, 2025-02-12]
Models/Passives/Crystals/Crystal_SMD_SeikoEpson_FA238-4Pin_3.2x2.5mm_HandSoldering.step
3.20 x 2.50 x 0.64 mm
