Daxxn/KiCAD-Component-Library/Models/Passives/Diodes/Diode_Bridge_Diotec_ABS.step

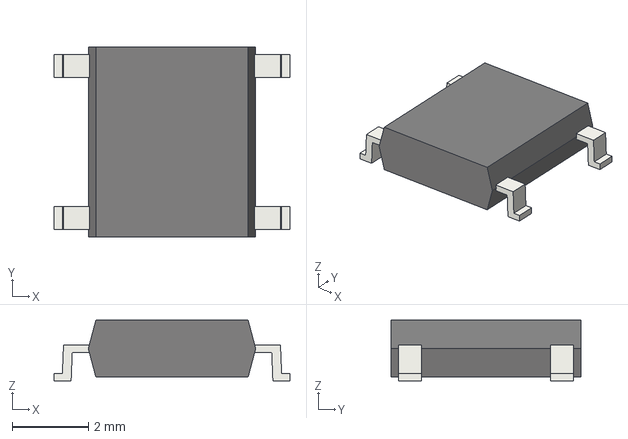
[picture p111: CAD file, 2025-02-12]
Models/Passives/Diodes/Diode_Bridge_Diotec_ABS.step
6.20 x 5.00 x 1.60 mm
