Daxxn/KiCAD-Component-Library/Models/Passives/Inductors/SRP1038WA.step

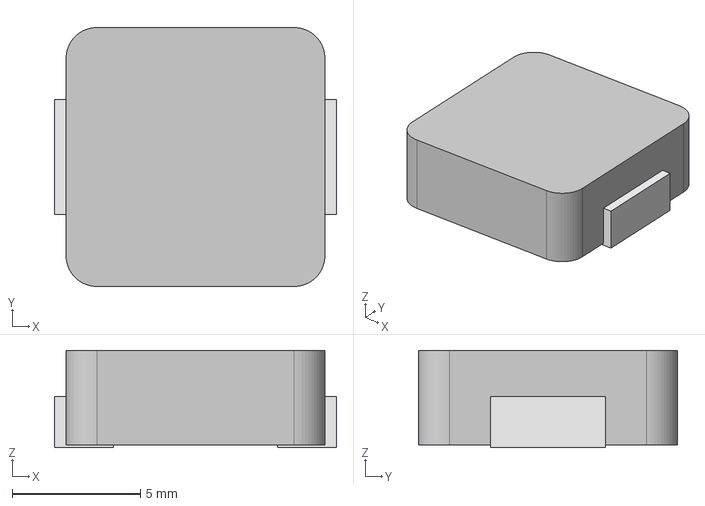
[picture p112: CAD file, 2025-04-12]
Models/Passives/Inductors/SRP1038WA.step
11.0 x 10.1 x 3.80 mm
