Daxxn/KiCAD-Component-Library/Models/Passives/Resistors/R_1206_3216Metric.step

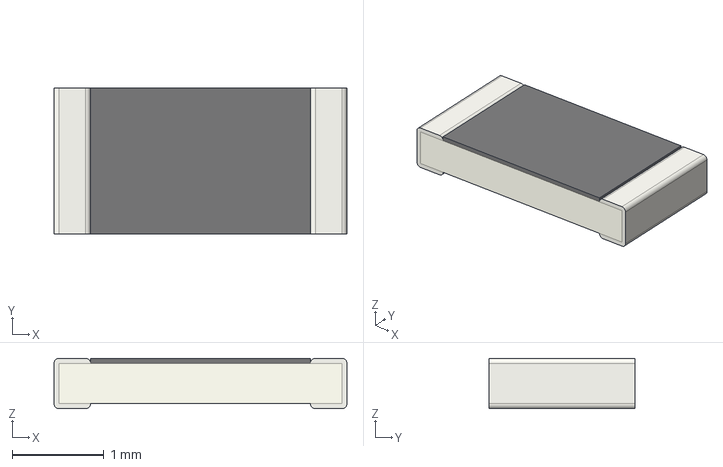
[picture p113: CAD file, 2025-02-12]
Models/Passives/Resistors/R_1206_3216Metric.step
3.20 x 1.60 x 0.55 mm
