Daxxn/KiCAD-Component-Library/Models/Relays/JW2SN-DC5V.step

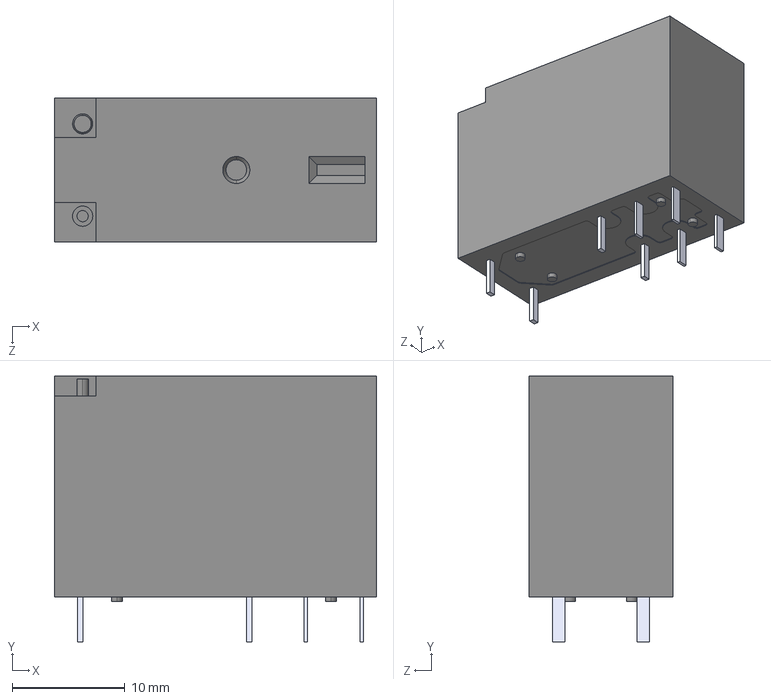
[picture p114: CAD file, 2025-04-12]
Models/Relays/JW2SN-DC5V.step
28.6 x 23.6 x 12.8 mm
