Daxxn/KiCAD-Component-Library/Models/Thermal/ATS-CPX054054025-128-C2-R0.step

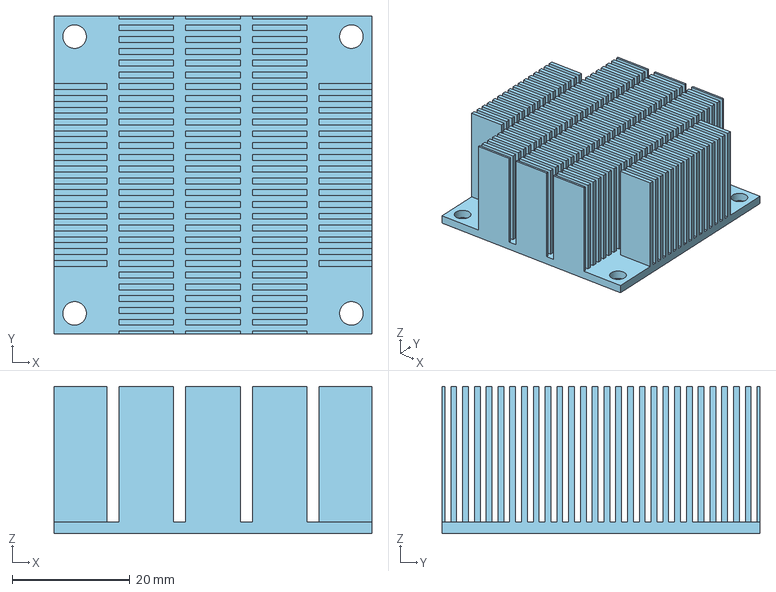
[picture p115: CAD file, 2025-04-12]
Models/Thermal/ATS-CPX054054025-128-C2-R0.step
54.0 x 54.0 x 25.0 mm
