Daxxn/KiCAD-Component-Library/Models/Transformer/Transformer_CHK_EI30-2VA_Neutral.step

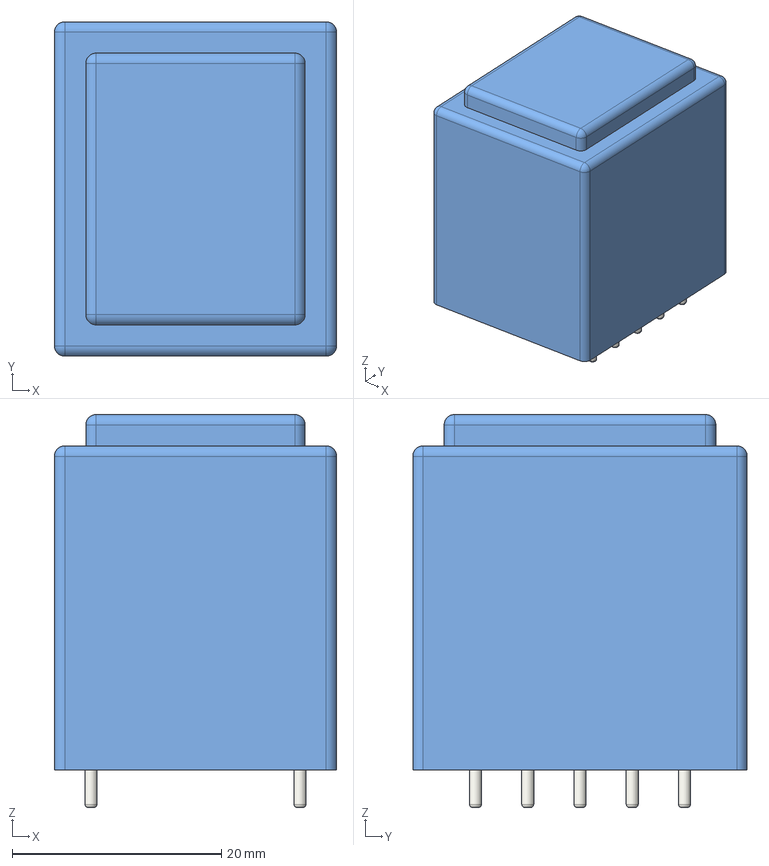
[picture p116: CAD file, 2025-04-12]
Models/Transformer/Transformer_CHK_EI30-2VA_Neutral.step
27.0 x 32.0 x 37.6 mm
Transformer_CHK_EI30_2VA_Neutral001
Transformer_CHK_EI30_2VA_Neutral
