Daxxn/KiCAD-Component-Library/Models/Connectors/Connector_DSUB/A-DF_09_A_KG-T4S.step

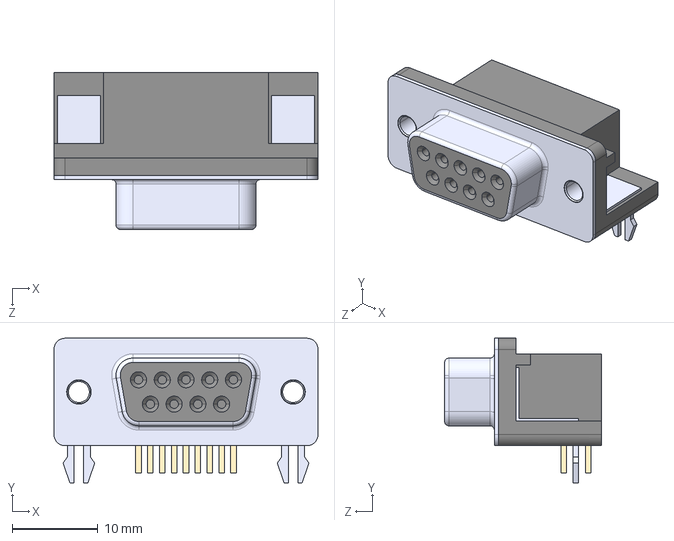
[picture p117: CAD file, 2025-04-12]
Models/Connectors/Connector_DSUB/A-DF_09_A_KG-T4S.step
30.8 x 16.9 x 18.3 mm
