Daxxn/KiCAD-Component-Library/Models/Connectors/Connector_Mezzanine/DF40HC3.0-100DS-0.4V.stp

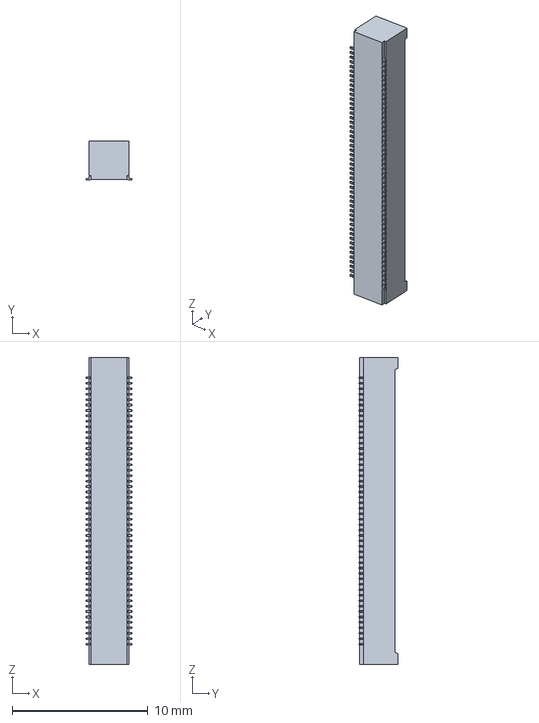
[picture p118: CAD file, 2025-02-12]
Models/Connectors/Connector_Mezzanine/DF40HC3.0-100DS-0.4V.stp
3.38 x 2.90 x 22.6 mm
