Daxxn/KiCAD-Component-Library/Models/Connectors/Connector_Molex/c-350211-1-af-3d.stp

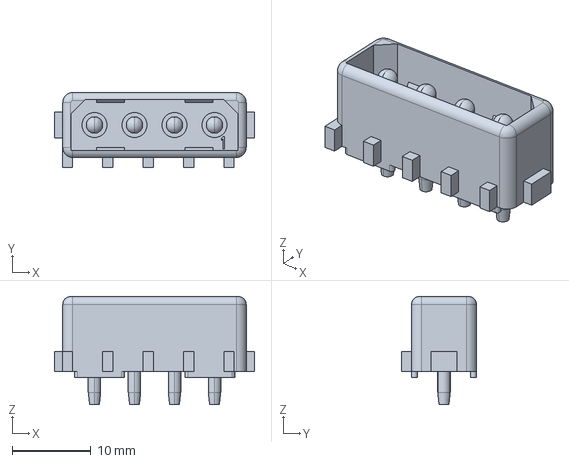
[picture p119: CAD file, 2025-02-12]
Models/Connectors/Connector_Molex/c-350211-1-af-3d.stp
25.4 x 9.53 x 13.7 mm
