Daxxn/KiCAD-Component-Library/Models/Connectors/Connector_PinHeader_2.54mm/PinHeader_1x28_P2.54mm_Horizontal.step

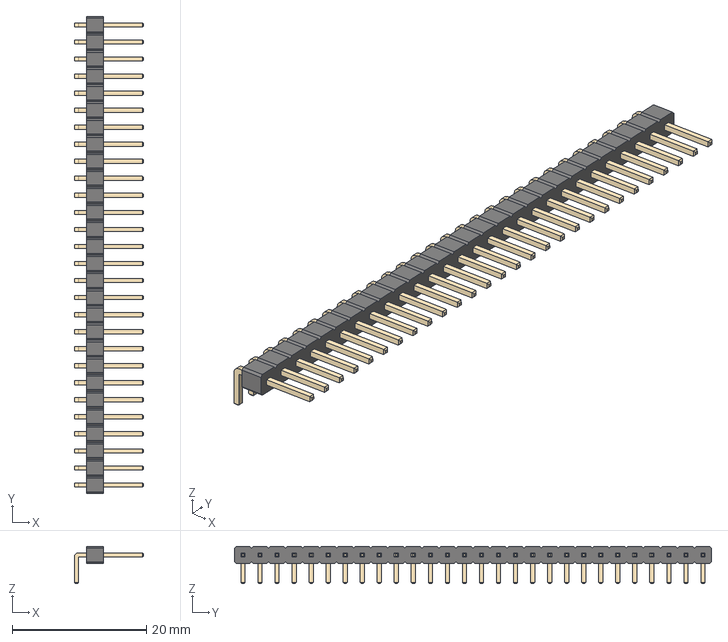
[picture p120: CAD file, 2025-02-12]
Models/Connectors/Connector_PinHeader_2.54mm/PinHeader_1x28_P2.54mm_Horizontal.step
10.4 x 71.1 x 5.54 mm
