Daxxn/KiCAD-Component-Library/Models/Connectors/Connector_Samtec_HPM_THT/Samtec_HPM-18-05-x-S_Straight_1x18_Pitch5.08mm.step

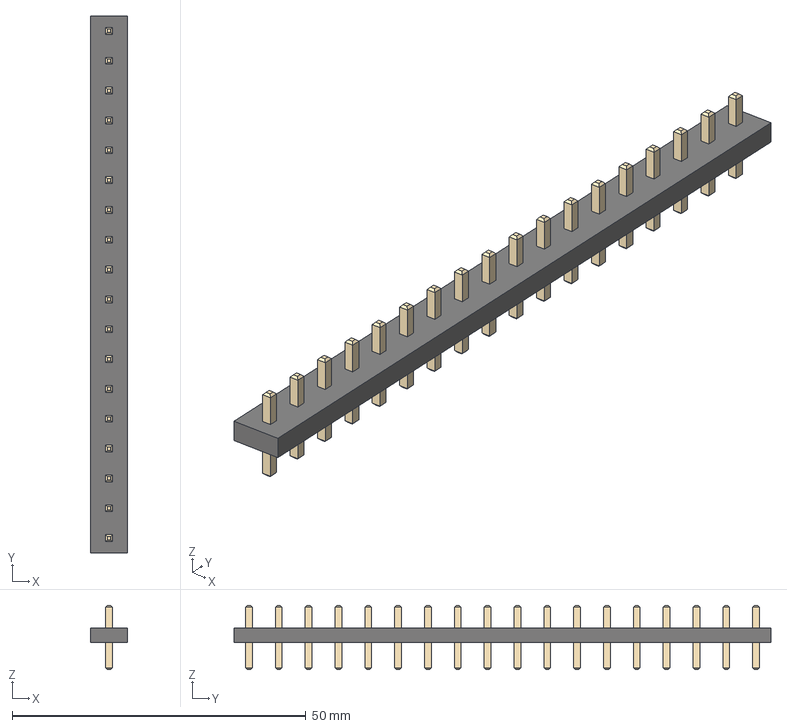
[picture p121: CAD file, 2025-04-12]
Models/Connectors/Connector_Samtec_HPM_THT/Samtec_HPM-18-05-x-S_Straight_1x18_Pitch5.08mm.step
6.35 x 91.4 x 10.9 mm
e7c15bfa-8c20-11ed-b7ac-a0cec80452fd_part
e7c16050-8c20-11ed-b7ac-a0cec80452fd_part
e7c16316-8c20-11ed-b7ac-a0cec80452fd_part
