Daxxn/KiCAD-Component-Library/Models/Connectors/Connector_USB/USB1135-15-P-L-B.stp

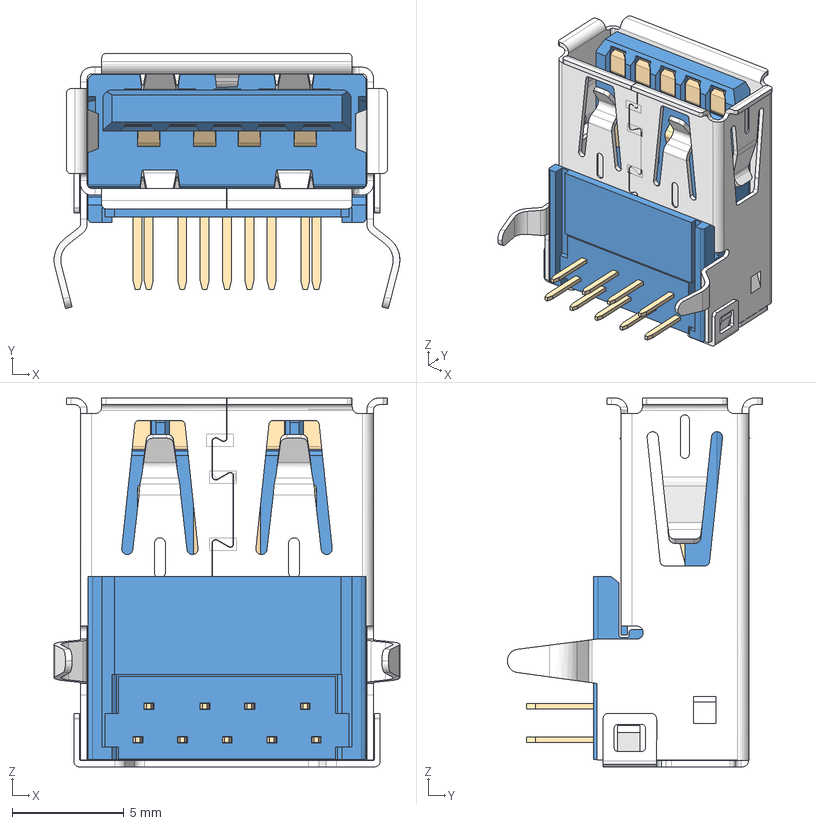
[picture p122: CAD file, 2025-04-12]
Models/Connectors/Connector_USB/USB1135-15-P-L-B.stp
15.5 x 11.4 x 16.5 mm
USB1135-15-P-L-B_PART1
USB1135-15-P-L-B_PART2
USB1135-15-P-L-B_PART3
USB1135-15-P-L-B_PART4
USB1135-15-P-L-B_PART5
