Daxxn/KiCAD-Component-Library/Models/Controls/TL3215A.step

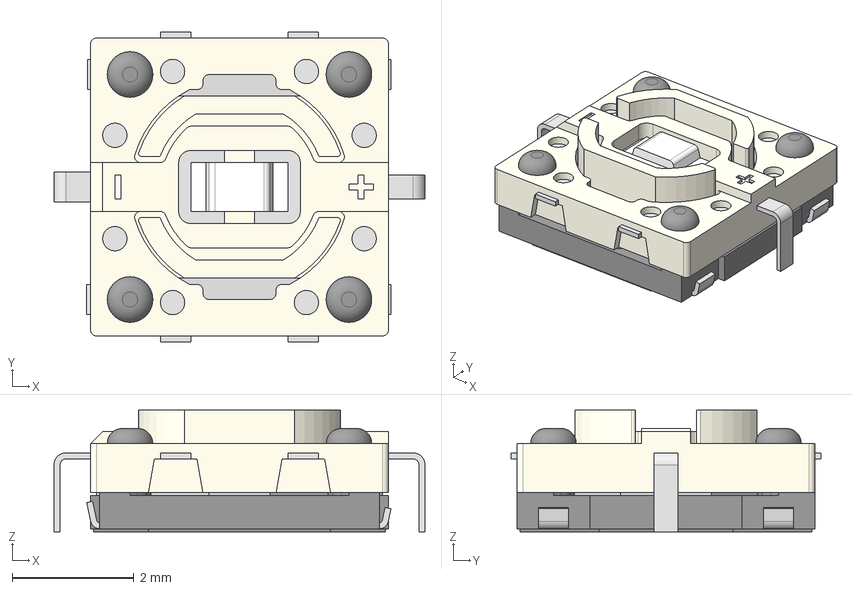
[picture p123: CAD file, 2025-04-12]
Models/Controls/TL3215A.step
6.10 x 5.10 x 2.00 mm
