Daxxn/KiCAD-Component-Library/Models/Displays/NHD-0440WH-ATMI-JT#.step

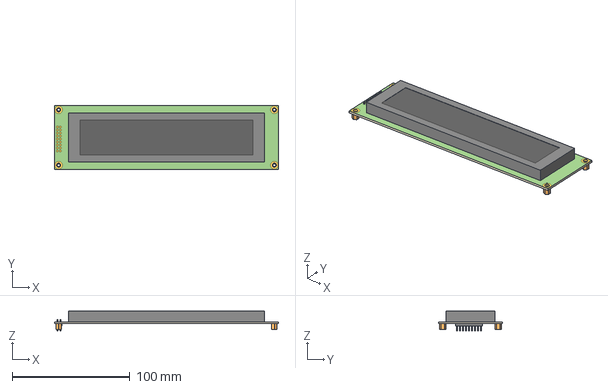
[picture p124: CAD file, 2025-02-12]
Models/Displays/NHD-0440WH-ATMI-JT#.step
190.0 x 54.0 x 16.6 mm
