Daxxn/KiCAD-Component-Library/Models/LEDs/LED_WS2812_PLCC6_5.0x5.0mm_P1.6mm.step

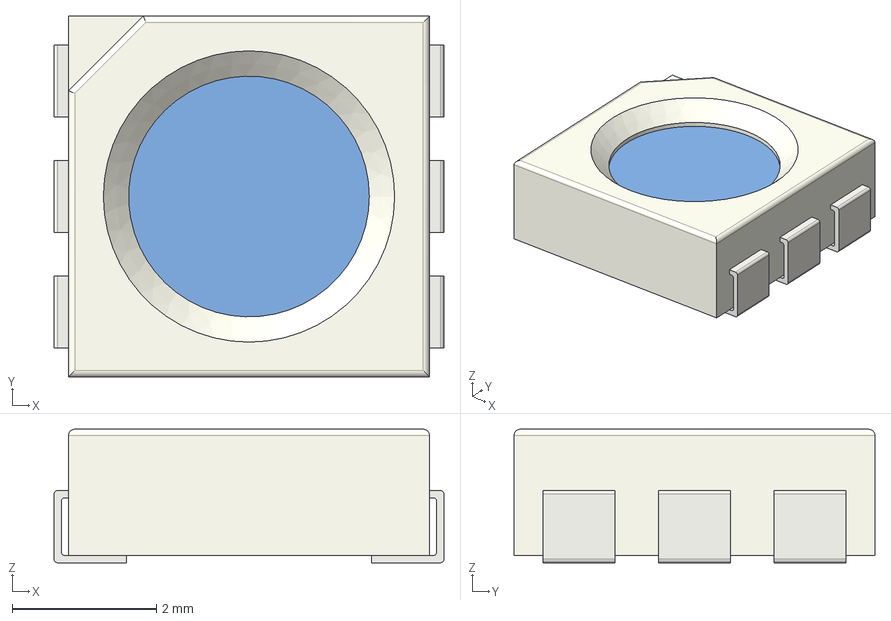
[picture p125: CAD file, 2025-02-12]
Models/LEDs/LED_WS2812_PLCC6_5.0x5.0mm_P1.6mm.step
5.40 x 5.00 x 1.85 mm
