Daxxn/KiCAD-Component-Library/Models/Packages/LQFP-52_10x10mm_P0.65mm.step

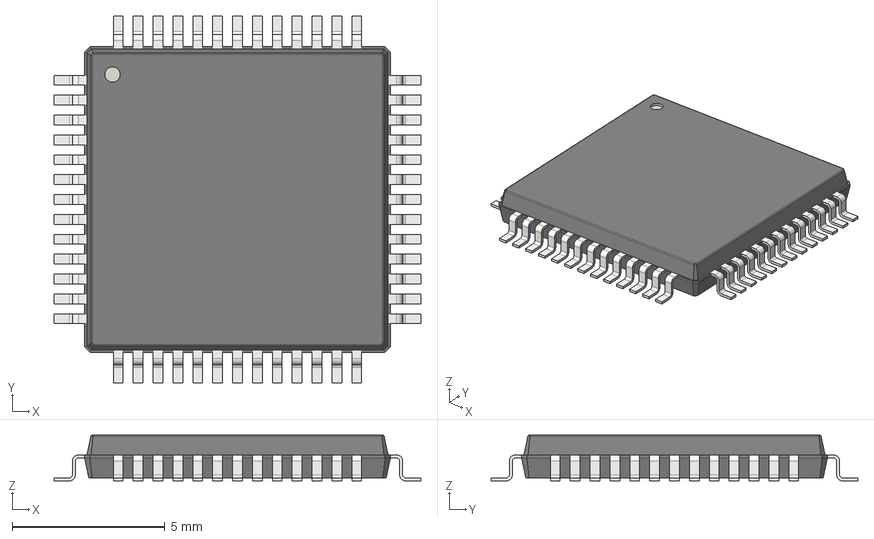
[picture p126: CAD file, 2025-02-12]
Models/Packages/LQFP-52_10x10mm_P0.65mm.step
12.0 x 12.0 x 1.50 mm
