Daxxn/KiCAD-Component-Library/Models/Packages/Package_BGA/VFBGA-100_7.0x7.0mm_Layout10x10_P0.65mm.step

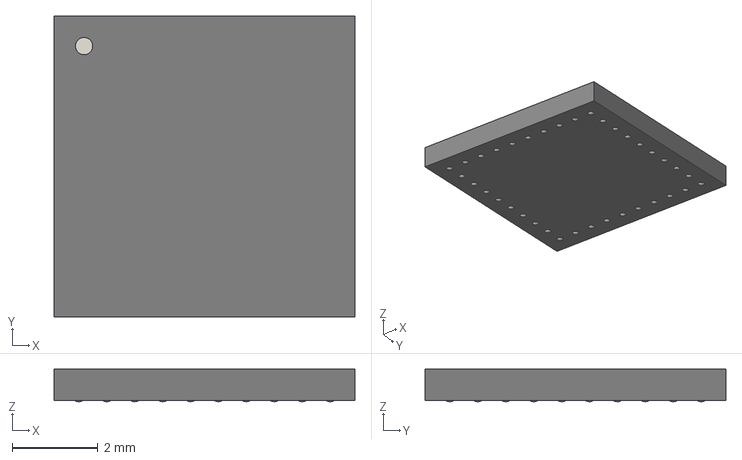
[picture p127: CAD file, 2025-02-12]
Models/Packages/Package_BGA/VFBGA-100_7.0x7.0mm_Layout10x10_P0.65mm.step
7.00 x 7.00 x 0.758 mm
