Daxxn/KiCAD-Component-Library/Models/Packages/Package_CSP/LFCSP-32-1EP_5x5mm_P0.5mm_EP3.6x3.6mm.step

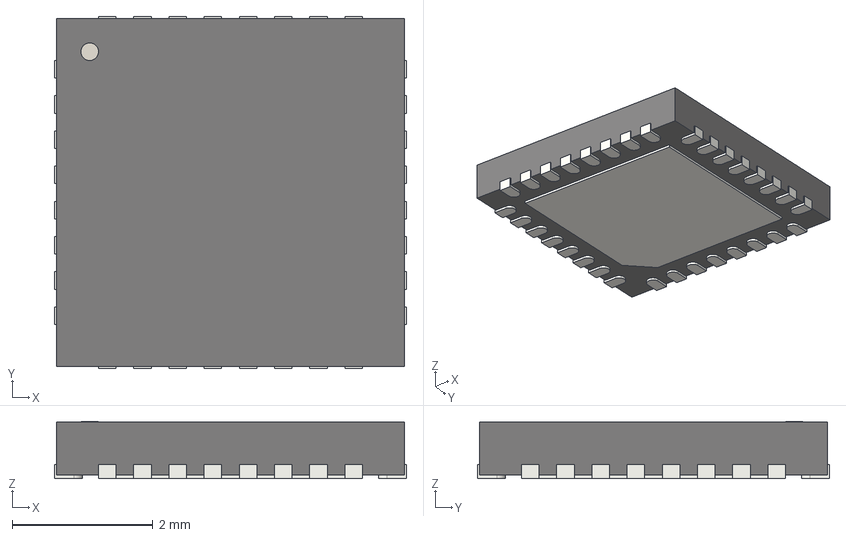
[picture p128: CAD file, 2025-02-12]
Models/Packages/Package_CSP/LFCSP-32-1EP_5x5mm_P0.5mm_EP3.6x3.6mm.step
5.00 x 5.00 x 0.81 mm
2728c7a2-7f7d-11ed-bbe7-acde48001122_part
2728ca22-7f7d-11ed-bbe7-acde48001122_part
2728cb12-7f7d-11ed-bbe7-acde48001122_part
2728cba8-7f7d-11ed-bbe7-acde48001122_part
