Daxxn/KiCAD-Component-Library/Models/Packages/Package_DFN_QFN/QFN-64-1EP_9x9mm_P0.5mm_EP7.25x7.25mm.step

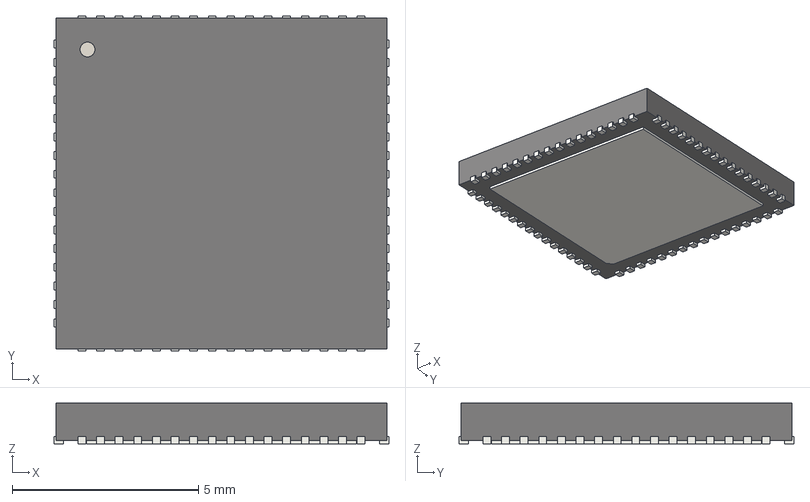
[picture p129: CAD file, 2025-02-12]
Models/Packages/Package_DFN_QFN/QFN-64-1EP_9x9mm_P0.5mm_EP7.25x7.25mm.step
9.00 x 9.00 x 1.10 mm
