Daxxn/KiCAD-Component-Library/Models/Packages/Package_DIP/DIP-32_W16.51mm_SMDSocket_LongPads.step

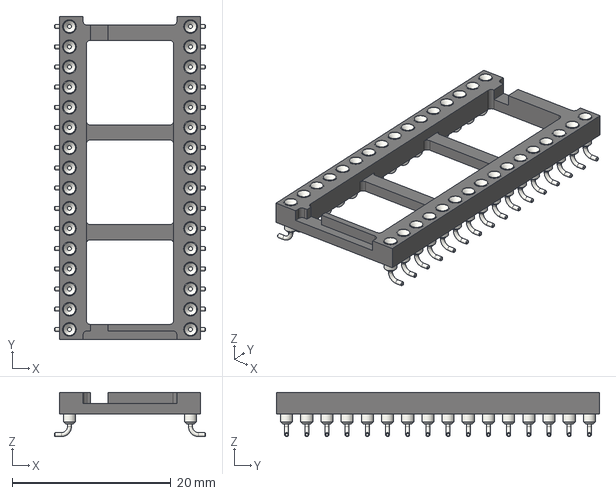
[picture p130: CAD file, 2025-02-12]
Models/Packages/Package_DIP/DIP-32_W16.51mm_SMDSocket_LongPads.step
19.0 x 40.6 x 5.58 mm
