Daxxn/KiCAD-Component-Library/Models/Packages/Package_LGA/AMS_LGA-10-1EP_2.7x4mm_P0.6mm.step

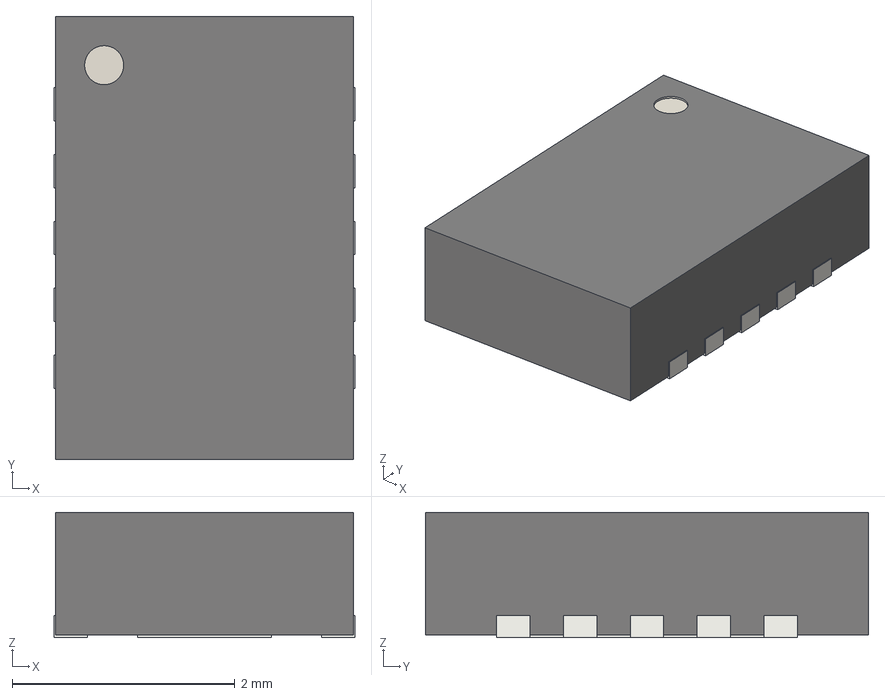
[picture p131: CAD file, 2025-02-12]
Models/Packages/Package_LGA/AMS_LGA-10-1EP_2.7x4mm_P0.6mm.step
2.70 x 3.98 x 1.12 mm
