Daxxn/KiCAD-Component-Library/Models/Packages/Package_QFP/TQFP-144_20x20mm_P0.5mm.step

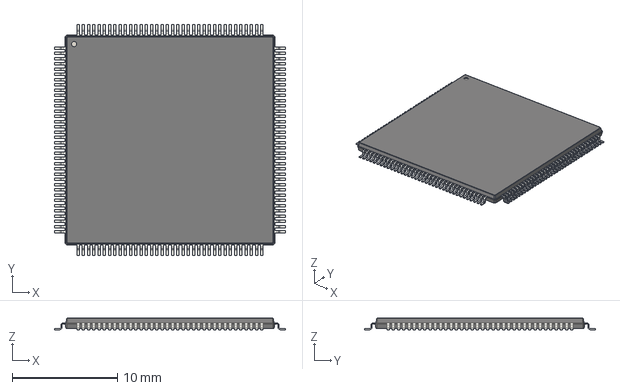
[picture p132: CAD file, 2025-02-12]
Models/Packages/Package_QFP/TQFP-144_20x20mm_P0.5mm.step
22.0 x 22.0 x 1.10 mm
