Daxxn/KiCAD-Component-Library/Models/Packages/Package_SIP/SIP4_Sharp-SSR_P7.62mm_Angled.step

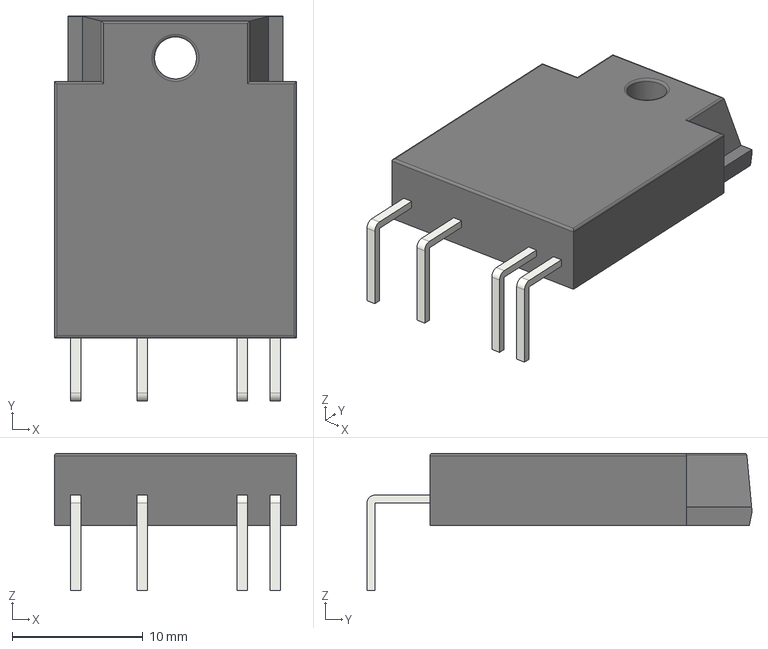
[picture p133: CAD file, 2025-02-12]
Models/Packages/Package_SIP/SIP4_Sharp-SSR_P7.62mm_Angled.step
18.5 x 29.4 x 10.5 mm
