Daxxn/KiCAD-Component-Library/Models/Packages/Package_SO/TSOP-I-24_18.4x6mm_P0.5mm.step

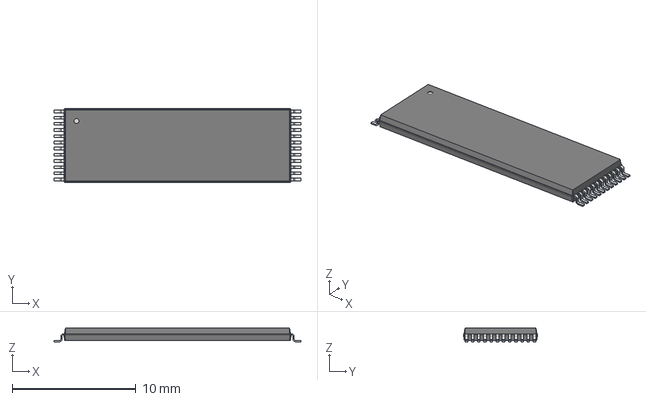
[picture p134: CAD file, 2025-02-12]
Models/Packages/Package_SO/TSOP-I-24_18.4x6mm_P0.5mm.step
20.0 x 6.00 x 1.10 mm
