Daxxn/KiCAD-Component-Library/Models/Packages/Package_SON/NXP_XSON-16.step

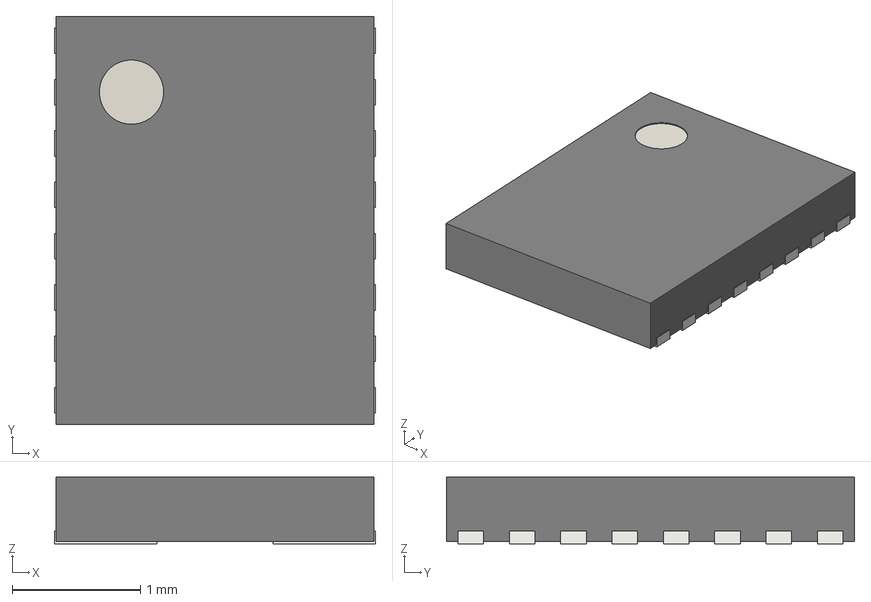
[picture p135: CAD file, 2025-02-12]
Models/Packages/Package_SON/NXP_XSON-16.step
2.50 x 3.18 x 0.52 mm
