Daxxn/KiCAD-Component-Library/Models/Packages/Package_TO_SOT_SMD/TO-263-7_TabPin4.step

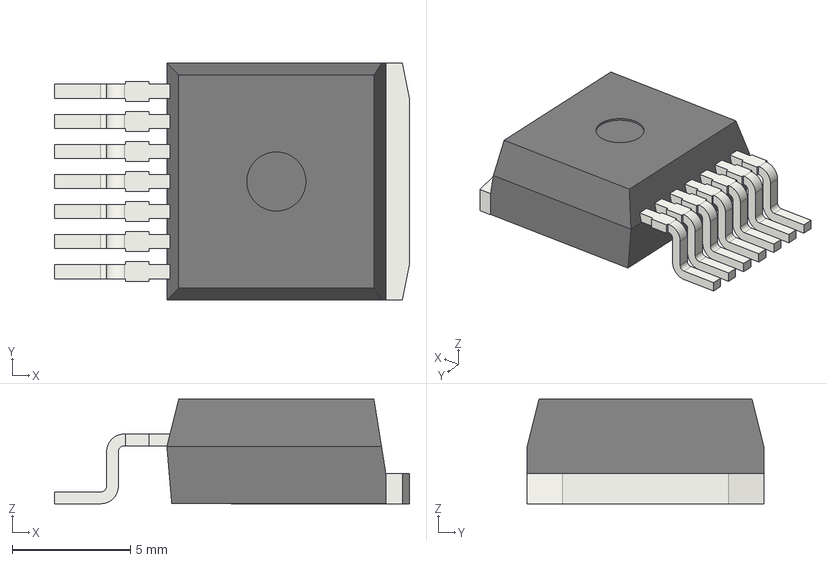
[picture p136: CAD file, 2025-02-12]
Models/Packages/Package_TO_SOT_SMD/TO-263-7_TabPin4.step
15.0 x 10.0 x 4.42 mm
a87cca3d-9c39-11ed-93f0-dde97e994e83_part
a87cca3e-9c39-11ed-93f0-dde97e994e83_part
a87cca3f-9c39-11ed-93f0-dde97e994e83_part
