Daxxn/KiCAD-Component-Library/Models/Packages/Package_TO_SOT_THT/TO-92.step

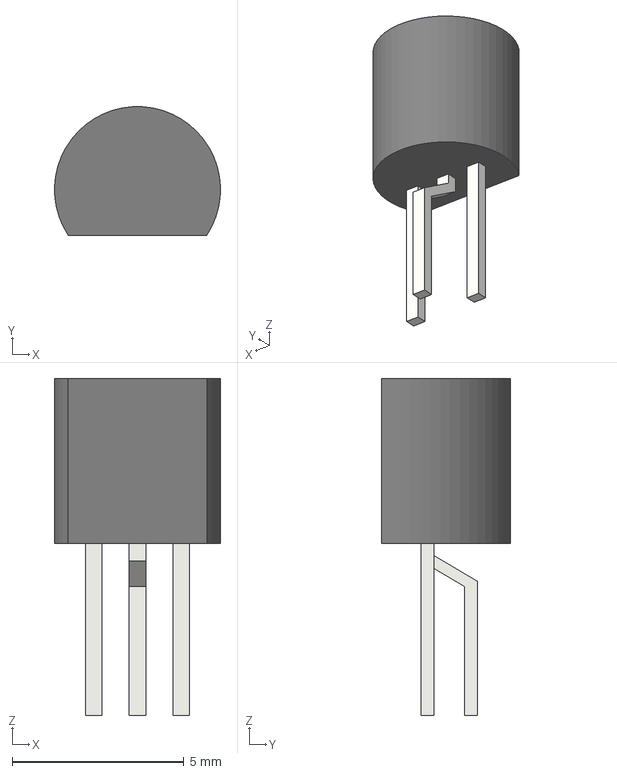
[picture p137: CAD file, 2025-02-12]
Models/Packages/Package_TO_SOT_THT/TO-92.step
4.83 x 3.74 x 9.80 mm
