Daxxn/KiCAD-Component-Library/Models/Passives/Capacitors/CP_Elec_3x5.4.step

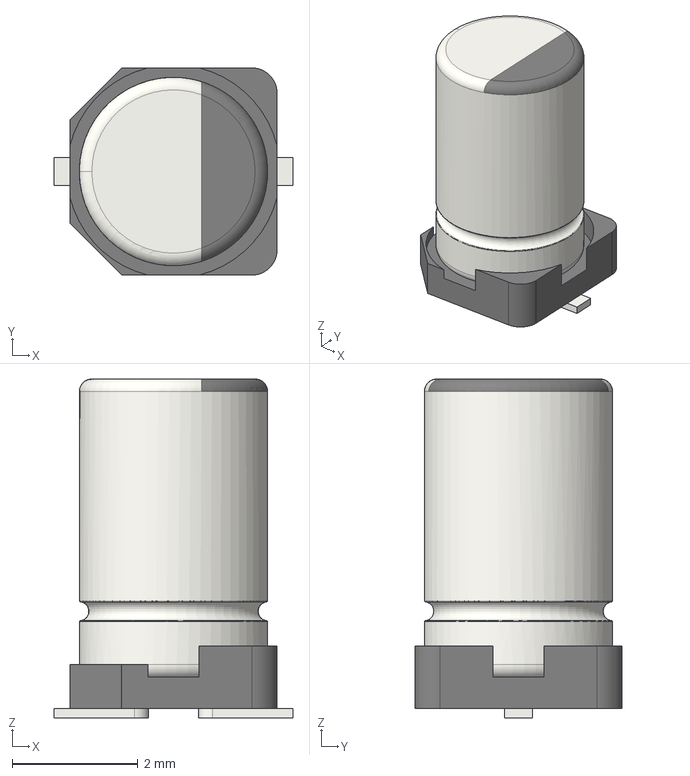
[picture p138: CAD file, 2025-02-12]
Models/Passives/Capacitors/CP_Elec_3x5.4.step
3.80 x 3.30 x 5.40 mm
