Daxxn/KiCAD-Component-Library/Models/Passives/Crystals/Crystal_SMD_MicroCrystal_CC8V-T1A-2Pin_2.0x1.2mm.step

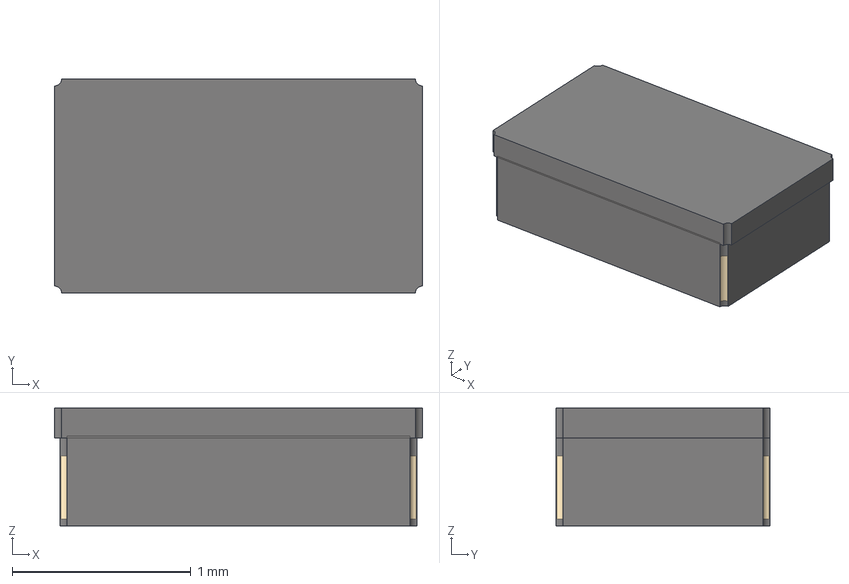
[picture p139: CAD file, 2025-02-12]
Models/Passives/Crystals/Crystal_SMD_MicroCrystal_CC8V-T1A-2Pin_2.0x1.2mm.step
2.06 x 1.20 x 0.66 mm
