Daxxn/KiCAD-Component-Library/Models/Passives/Diodes/Diode_Bridge_Vishay_MBLS.step

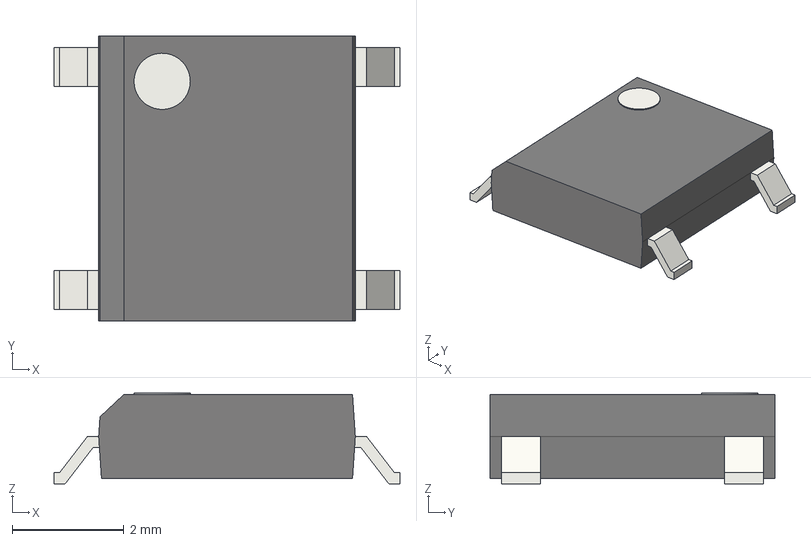
[picture p140: CAD file, 2025-02-12]
Models/Passives/Diodes/Diode_Bridge_Vishay_MBLS.step
6.20 x 5.10 x 1.63 mm
