Daxxn/KiCAD-Component-Library/Models/Passives/Inductors/0630CDMCCDS.step

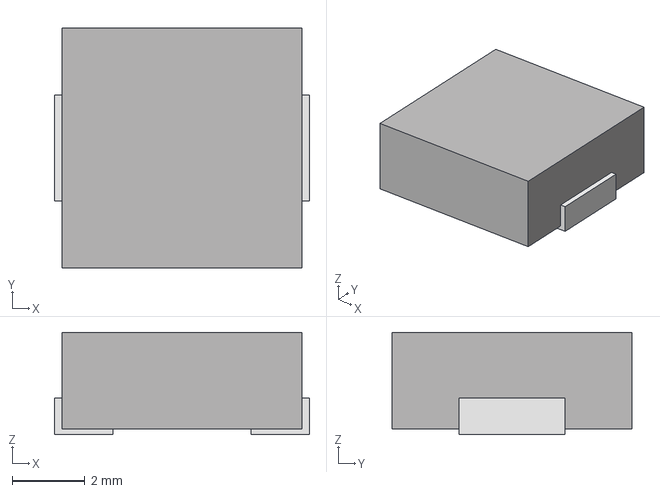
[picture p141: CAD file, 2025-04-12]
Models/Passives/Inductors/0630CDMCCDS.step
7.00 x 6.60 x 2.80 mm
