Daxxn/KiCAD-Component-Library/Models/Passives/Resistors/R_Shunt_Vishay_WSKW0612.step

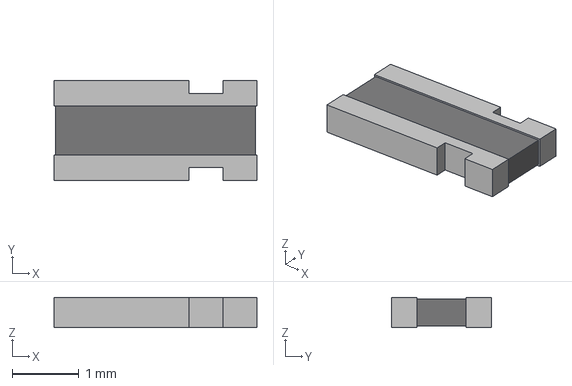
[picture p142: CAD file, 2025-02-12]
Models/Passives/Resistors/R_Shunt_Vishay_WSKW0612.step
3.05 x 1.50 x 0.457 mm
