Daxxn/KiCAD-Component-Library/Models/Relays/CB1-12V.step

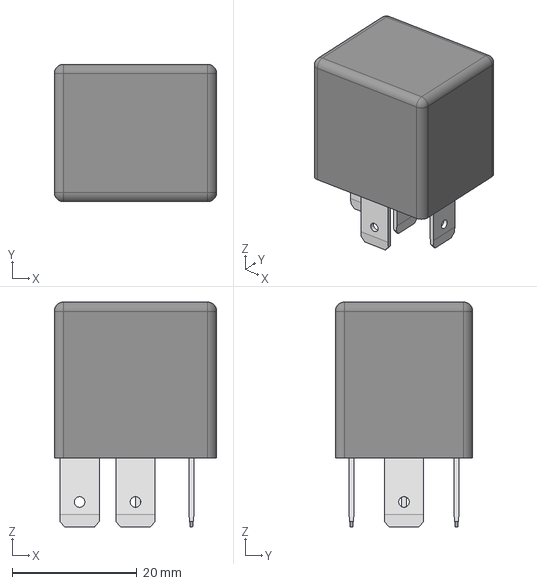
[picture p143: CAD file, 2025-04-12]
Models/Relays/CB1-12V.step
26.0 x 22.0 x 36.0 mm
