Daxxn/KiCAD-Component-Library/Models/Thermal/OMNI-UNI-18-75.step

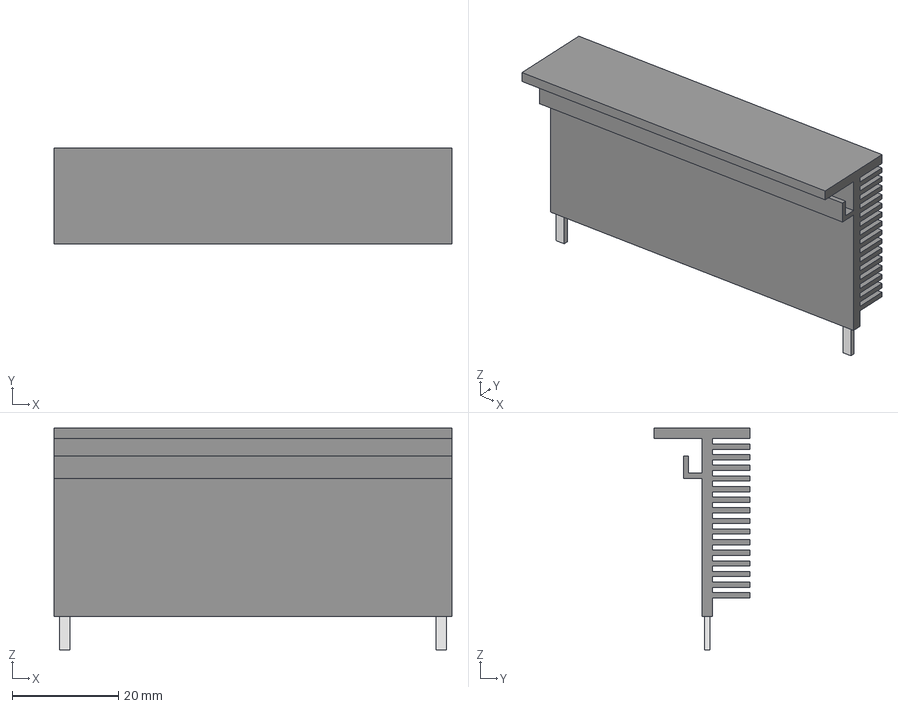
[picture p144: CAD file, 2025-04-12]
Models/Thermal/OMNI-UNI-18-75.step
75.0 x 18.0 x 41.8 mm
