Daxxn/KiCAD-Component-Library/Models/Transformer/Transformer_CHK_EI38-3VA_Neutral.step

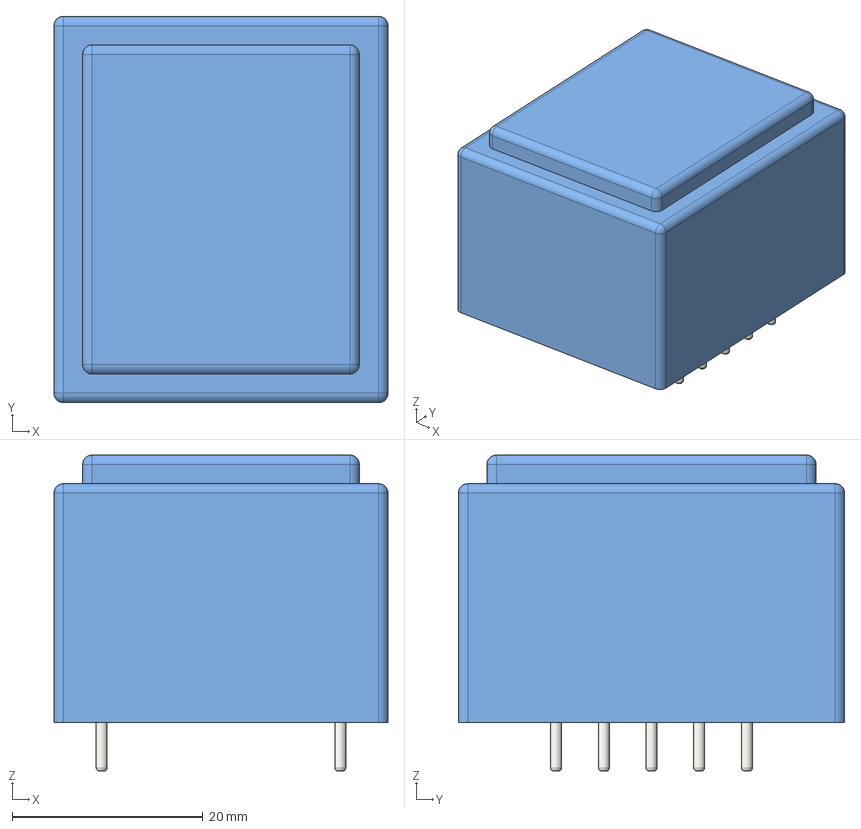
[picture p145: CAD file, 2025-04-12]
Models/Transformer/Transformer_CHK_EI38-3VA_Neutral.step
35.0 x 40.5 x 33.1 mm
Transformer_CHK_EI38_3VA_Neutral001
Transformer_CHK_EI38_3VA_Neutral
