Daxxn/KiCAD-Component-Library/Models/Connectors/Connector_FFC_FPC/Molex_502250-3391_2Rows-33Pins-1MP_P0.60mm_Horizontal.step

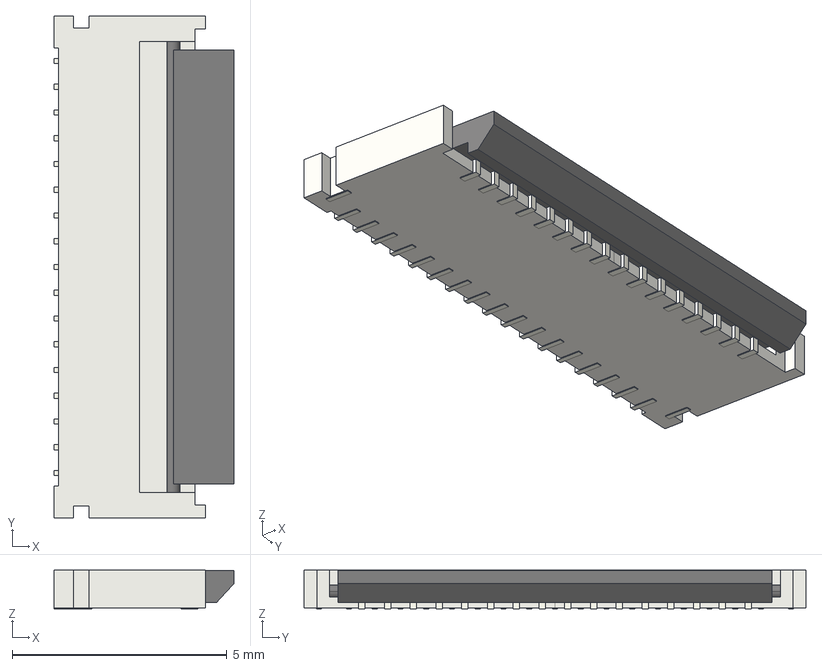
[picture p146: CAD file, 2025-02-12]
Models/Connectors/Connector_FFC_FPC/Molex_502250-3391_2Rows-33Pins-1MP_P0.60mm_Horizontal.step
4.19 x 11.7 x 0.9 mm
