Daxxn/KiCAD-Component-Library/(list of files, cad)

Other CAD files:
Models/Packages/Transistor_Power_Module/Infineon_EasyPIM-2B.step
Models/Connectors/Connector_Terminal/7795.STEP
Models/Hardware/Standoff-Brass-M3-15.stp
Models/Packages/Package_DirectFET/DirectFET_MT.step
Models/Connectors/006841045000.stp
Models/Connectors/039291027.stp
Models/Connectors/046841045100846+.stp
Models/Connectors/10029449-111RLF.stp
Models/Connectors/2834082-1 v3.step
Models/Connectors/2x17-PIN-CONN-20mm.step
Models/Connectors/2x17-PIN-CONN-20mm.stp
Models/Connectors/34-PIN-CONN-20mm.stp
Models/Connectors/34-PIN-SPACER-30.48mm.step
Models/Connectors/472192001.stp
Models/Connectors/501951-4000.stp
Models/Connectors/525593652.stp
Models/Connectors/541323662.stp
Models/Connectors/57PC5FS.step
Models/Connectors/640456-2 v3.step
Models/Connectors/690367290476 v4.step
Models/Connectors/903253006.stp
Models/Connectors/B24B-PHDSS(LF)(SN).stp
Models/Connectors/CONN-BANANA v4.step
Models/Connectors/CP30082-XLR.step
Models/Connectors/CUI_DEVICES_SJ-63073E.step
Models/Connectors/CUI_DEVICES_SJ-63073E.stp
Models/Connectors/Connector_DSUB/10090929-S26.stp
Models/Connectors/Connector_DSUB/LD09P24A4GV00LF.step
Models/Connectors/Connector_DSUB/LD15S24A4GV00LF.step
Models/Connectors/Connector_DSUB/LD15S33E4GV00LF.stp
Models/Connectors/Connector_DSUB/ild15s24a4gv00lf.igs
Models/Connectors/Connector_ECU/348302001.stp
Models/Connectors/Connector_ECU/366380003.stp
Models/Connectors/Connector_ECU/5007620481.stp
Models/Connectors/Connector_ECU/5007621001.stp
Models/Connectors/Connector_ECU/643330100.stp
Models/Connectors/Connector_ECU/MX34024UF1.step
Models/Connectors/Connector_Ethernet/432026105.stp
Models/Connectors/Connector_FFC_FPC/5-520315-6.stp
Models/Connectors/Connector_FFC_FPC/5019514000.step
Models/Connectors/Connector_FFC_FPC/5019514000.stp
Models/Connectors/Connector_FFC_FPC/5019514500.stp
Models/Connectors/Connector_FFC_FPC/5019515000.stp
Models/Connectors/Connector_FFC_FPC/5034802000.step
Models/Connectors/Connector_FFC_FPC/5034802000.stp
Models/Connectors/Connector_FFC_FPC/5051102491.stp
Models/Connectors/Connector_FFC_FPC/522070660.step
Models/Connectors/Connector_FFC_FPC/522070660.stp
Models/Connectors/Connector_FFC_FPC/526100672.step
Models/Connectors/Connector_FFC_FPC/526100672.stp
Models/Connectors/Connector_FFC_FPC/541324033.step
Models/Connectors/Connector_FFC_FPC/541324033.stp
Models/Connectors/Connector_FFC_FPC/59453-041110EDHLF.step
Models/Connectors/Connector_FFC_FPC/62684-402100ALF.step
Models/Connectors/Connector_FFC_FPC/62684-452100ALF.step
Models/Connectors/Connector_FFC_FPC/62684_401100ALF.stp
Models/Connectors/Connector_FFC_FPC/62684_40110ALF.step
Models/Connectors/Connector_FFC_FPC/AMP_62684-402100ALF.step
Models/Connectors/Connector_FFC_FPC/AMP_62684-451100ALF.step
Models/Connectors/Connector_FFC_FPC/AMP_62684-452100AHLF.STEP
Models/Connectors/Connector_FFC_FPC/F52Q-1A7H1-11006.stp
Models/Connectors/Connector_FFC_FPC/FFC2A32-20-T.step
Models/Connectors/Connector_FFC_FPC/Molex_502250-1791_2Rows-17Pins-1MP_P0.60mm_Horizontal.step
Models/Connectors/Connector_FFC_FPC/Molex_502250-2191_2Rows-21Pins-1MP_P0.60mm_Horizontal.step
Models/Connectors/Connector_FFC_FPC/Molex_502250-2391_2Rows-23Pins-1MP_P0.60mm_Horizontal.step
Models/Connectors/Connector_FFC_FPC/Molex_502250-2791_2Rows-27Pins-1MP_P0.60mm_Horizontal.step
Models/Connectors/Connector_FFC_FPC/Molex_502250-3591_2Rows-35Pins-1MP_P0.60mm_Horizontal.step
Models/Connectors/Connector_FFC_FPC/Molex_502250-3991_2Rows-39Pins-1MP_P0.60mm_Horizontal.step
Models/Connectors/Connector_FFC_FPC/Molex_502250-4191_2Rows-41Pins-1MP_P0.60mm_Horizontal.step
Models/Connectors/Connector_FFC_FPC/Molex_502250-5191_2Rows-51Pins-1MP_P0.60mm_Horizontal.step
Models/Connectors/Connector_FFC_FPC/TE_1-84952-0_1x10-1MP_P1.0mm_Horizontal.step
Models/Connectors/Connector_FFC_FPC/TE_1-84952-1_1x11-1MP_P1.0mm_Horizontal.step
Models/Connectors/Connector_FFC_FPC/TE_1-84952-2_1x12-1MP_P1.0mm_Horizontal.step
Models/Connectors/Connector_FFC_FPC/TE_1-84952-3_1x13-1MP_P1.0mm_Horizontal.step
Models/Connectors/Connector_FFC_FPC/TE_1-84952-4_1x14-1MP_P1.0mm_Horizontal.step
Models/Connectors/Connector_FFC_FPC/TE_1-84952-5_1x15-1MP_P1.0mm_Horizontal.step
Models/Connectors/Connector_FFC_FPC/TE_1-84952-6_1x16-1MP_P1.0mm_Horizontal.step
Models/Connectors/Connector_FFC_FPC/TE_1-84952-7_1x17-1MP_P1.0mm_Horizontal.step
Models/Connectors/Connector_FFC_FPC/TE_1-84952-8_1x18-1MP_P1.0mm_Horizontal.step
Models/Connectors/Connector_FFC_FPC/TE_1-84952-9_1x19-1MP_P1.0mm_Horizontal.step
Models/Connectors/Connector_FFC_FPC/TE_1-84953-0_1x10-1MP_P1.0mm_Horizontal.step
Models/Connectors/Connector_FFC_FPC/TE_1-84953-1_1x11-1MP_P1.0mm_Horizontal.step
Models/Connectors/Connector_FFC_FPC/TE_1-84953-2_1x12-1MP_P1.0mm_Horizontal.step
Models/Connectors/Connector_FFC_FPC/TE_1-84953-3_1x13-1MP_P1.0mm_Horizontal.step
Models/Connectors/Connector_FFC_FPC/TE_1-84953-4_1x14-1MP_P1.0mm_Horizontal.step
Models/Connectors/Connector_FFC_FPC/TE_1-84953-5_1x15-1MP_P1.0mm_Horizontal.step
Models/Connectors/Connector_FFC_FPC/TE_1-84953-6_1x16-1MP_P1.0mm_Horizontal.step
Models/Connectors/Connector_FFC_FPC/TE_1-84953-7_1x17-1MP_P1.0mm_Horizontal.step
Models/Connectors/Connector_FFC_FPC/TE_1-84953-8_1x18-1MP_P1.0mm_Horizontal.step
Models/Connectors/Connector_FFC_FPC/TE_1-84953-9_1x19-1MP_P1.0mm_Horizontal.step
Models/Connectors/Connector_FFC_FPC/TE_2-84952-0_1x20-1MP_P1.0mm_Horizontal.step
Models/Connectors/Connector_FFC_FPC/TE_2-84952-1_1x21-1MP_P1.0mm_Horizontal.step
Models/Connectors/Connector_FFC_FPC/TE_2-84952-2_1x22-1MP_P1.0mm_Horizontal.step
Models/Connectors/Connector_FFC_FPC/TE_2-84952-3_1x23-1MP_P1.0mm_Horizontal.step
Models/Connectors/Connector_FFC_FPC/TE_2-84952-4_1x24-1MP_P1.0mm_Horizontal.step
Models/Connectors/Connector_FFC_FPC/TE_2-84952-5_1x25-1MP_P1.0mm_Horizontal.step
Models/Connectors/Connector_FFC_FPC/TE_2-84952-6_1x26-1MP_P1.0mm_Horizontal.step
Models/Connectors/Connector_FFC_FPC/TE_2-84952-7_1x27-1MP_P1.0mm_Horizontal.step
Models/Connectors/Connector_FFC_FPC/TE_2-84952-8_1x28-1MP_P1.0mm_Horizontal.step
Models/Connectors/Connector_FFC_FPC/TE_2-84952-9_1x29-1MP_P1.0mm_Horizontal.step
Models/Connectors/Connector_FFC_FPC/TE_2-84953-0_1x20-1MP_P1.0mm_Horizontal.step
Models/Connectors/Connector_FFC_FPC/TE_2-84953-1_1x21-1MP_P1.0mm_Horizontal.step
Models/Connectors/Connector_FFC_FPC/TE_2-84953-2_1x22-1MP_P1.0mm_Horizontal.step
Models/Connectors/Connector_FFC_FPC/TE_2-84953-3_1x23-1MP_P1.0mm_Horizontal.step
Models/Connectors/Connector_FFC_FPC/TE_2-84953-4_1x24-1MP_P1.0mm_Horizontal.step
Models/Connectors/Connector_FFC_FPC/TE_2-84953-5_1x25-1MP_P1.0mm_Horizontal.step
Models/Connectors/Connector_FFC_FPC/TE_2-84953-6_1x26-1MP_P1.0mm_Horizontal.step
Models/Connectors/Connector_FFC_FPC/TE_2-84953-7_1x27-1MP_P1.0mm_Horizontal.step
Models/Connectors/Connector_FFC_FPC/TE_2-84953-8_1x28-1MP_P1.0mm_Horizontal.step
Models/Connectors/Connector_FFC_FPC/TE_2-84953-9_1x29-1MP_P1.0mm_Horizontal.step
Models/Connectors/Connector_FFC_FPC/TE_3-84952-0_1x30-1MP_P1.0mm_Horizontal.step
Models/Connectors/Connector_FFC_FPC/TE_3-84953-0_1x30-1MP_P1.0mm_Horizontal.step
Models/Connectors/Connector_FFC_FPC/TE_84952-4_1x04-1MP_P1.0mm_Horizontal.step
Models/Connectors/Connector_FFC_FPC/TE_84952-5_1x05-1MP_P1.0mm_Horizontal.step
Models/Connectors/Connector_FFC_FPC/TE_84952-6_1x06-1MP_P1.0mm_Horizontal.step
Models/Connectors/Connector_FFC_FPC/TE_84952-7_1x07-1MP_P1.0mm_Horizontal.step
Models/Connectors/Connector_FFC_FPC/TE_84952-8_1x08-1MP_P1.0mm_Horizontal.step
Models/Connectors/Connector_FFC_FPC/TE_84952-9_1x09-1MP_P1.0mm_Horizontal.step
Models/Connectors/Connector_FFC_FPC/TE_84953-4_1x04-1MP_P1.0mm_Horizontal.step
Models/Connectors/Connector_FFC_FPC/TE_84953-5_1x05-1MP_P1.0mm_Horizontal.step
Models/Connectors/Connector_FFC_FPC/TE_84953-6_1x06-1MP_P1.0mm_Horizontal.step
Models/Connectors/Connector_FFC_FPC/TE_84953-7_1x07-1MP_P1.0mm_Horizontal.step
Models/Connectors/Connector_FFC_FPC/TE_84953-8_1x08-1MP_P1.0mm_Horizontal.step
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
