Daxxn/KiCAD-Component-Library/(list of files, drawings)

Other design files:
Footprints/Imported ALW0425A-BGA-425-13x13mm/ALW0425A-BGA-425-13x13mm.PrjPcb
Footprints/Imported ALW0425A-BGA-425-13x13mm/ArduinoLibrary.PcbLib
Footprints/Imported ALW0425A-BGA-425-13x13mm/Daxxn_Batteries.PcbLib
Footprints/Imported ALW0425A-BGA-425-13x13mm/Daxxn_Connectors.PcbLib
Footprints/Imported ALW0425A-BGA-425-13x13mm/Daxxn_Diodes.PcbLib
Footprints/Imported ALW0425A-BGA-425-13x13mm/Daxxn_Displays.PcbLib
Footprints/Imported ALW0425A-BGA-425-13x13mm/Daxxn_Enclosures.PcbLib
Footprints/Imported ALW0425A-BGA-425-13x13mm/Daxxn_LEDs.PcbLib
Footprints/Imported ALW0425A-BGA-425-13x13mm/Daxxn_Logos_Art.PcbLib
Footprints/Imported ALW0425A-BGA-425-13x13mm/Daxxn_Other.PcbLib
Footprints/Imported ALW0425A-BGA-425-13x13mm/Daxxn_Packages.PcbLib
Footprints/Imported ALW0425A-BGA-425-13x13mm/Daxxn_Passives.PcbLib
Footprints/Imported ALW0425A-BGA-425-13x13mm/Daxxn_Protection.PcbLib
Footprints/Imported ALW0425A-BGA-425-13x13mm/Daxxn_Relays.PcbLib
Footprints/Imported ALW0425A-BGA-425-13x13mm/Daxxn_Standoffs.PcbLib
Footprints/Imported ALW0425A-BGA-425-13x13mm/Daxxn_Switches.PcbLib
Footprints/Imported ALW0425A-BGA-425-13x13mm/Daxxn_Thermal.PcbLib
