Daxxn/KiCAD-Component-Library/DesignBlocks/DX_CONN_Programming.kicad_blocks/CONN_PROG_SWD_5P_Header.kicad_block/CONN_PROG_SWD_5P_Header.kicad_sch

## KiCad design DesignBlocks/DX_CONN_Programming.kicad_blocks/CONN_PROG_SWD_5P_Header.kicad_block/CONN_PROG_SWD_5P_Header.kicad_sch (2025-11-15)

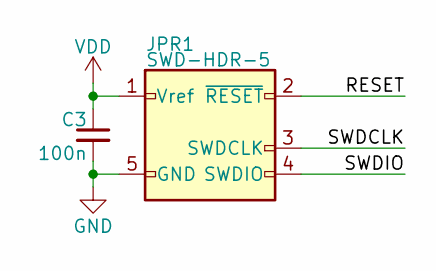
[picture p147: schematic CONN_PROG_SWD_5P_Header.kicad_sch]

Parts:
C3: 100n; CAP_0402; PartNumber 0201-0100-00086
JPR1: SWD-HDR-5; PinHeader_1x05_P2.54mm_Vertical

Connections:
GND: C3.2, JPR1.5 (GND)
RESET: JPR1.2 (~RESET)
SWDCLK: JPR1.3 (SWDCLK)
SWDIO: JPR1.4 (SWDIO)
VDD: C3.1, JPR1.1 (Vref)
