Daxxn/KiCAD-Component-Library/DesignBlocks/DX_CONN_Programming.kicad_blocks/CONN_PROG_SWD_6P_Header.kicad_block/CONN_PROG_SWD_6P_Header.kicad_sch

## KiCad design DesignBlocks/DX_CONN_Programming.kicad_blocks/CONN_PROG_SWD_6P_Header.kicad_block/CONN_PROG_SWD_6P_Header.kicad_sch (2025-11-15)

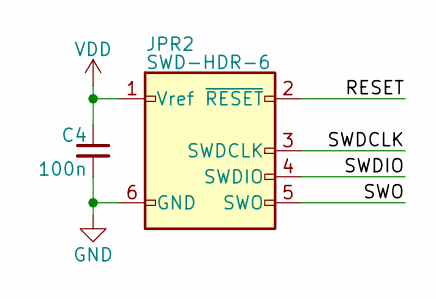
[picture p148: schematic CONN_PROG_SWD_6P_Header.kicad_sch]

Parts:
C4: 100n; CAP_0402; PartNumber 0201-0100-00086
JPR2: SWD-HDR-6; PinHeader_1x06_P2.54mm_Vertical

Connections:
GND: C4.2, JPR2.6 (GND)
RESET: JPR2.2 (~RESET)
SWDCLK: JPR2.3 (SWDCLK)
SWDIO: JPR2.4 (SWDIO)
SWO: JPR2.5 (SWO)
VDD: C4.1, JPR2.1 (Vref)
