Daxxn/KiCAD-Component-Library/DesignBlocks/DX_CONN_Programming.kicad_blocks/CONN_PROG_SWD_6P_TAG.kicad_block/CONN_PROG_SWD_6P_TAG.kicad_sch

## KiCad design DesignBlocks/DX_CONN_Programming.kicad_blocks/CONN_PROG_SWD_6P_TAG.kicad_block/CONN_PROG_SWD_6P_TAG.kicad_sch (2025-11-15)

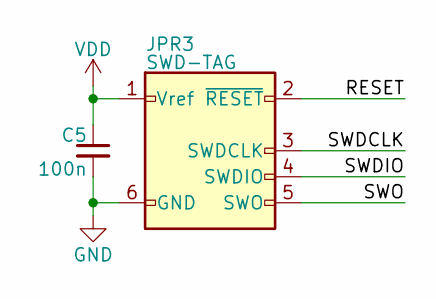
[picture p149: schematic CONN_PROG_SWD_6P_TAG.kicad_sch]

Parts:
C5: 100n; CAP_0402; PartNumber 0201-0100-00086
JPR3: SWD-TAG; Tag-Connect_TC2030-IDC-FP_2x03_P1.27mm_Vertical

Connections:
GND: C5.2, JPR3.6 (GND)
RESET: JPR3.2 (~RESET)
SWDCLK: JPR3.3 (SWDCLK)
SWDIO: JPR3.4 (SWDIO)
SWO: JPR3.5 (SWO)
VDD: C5.1, JPR3.1 (Vref)
