Daxxn/KiCAD-Component-Library/DesignBlocks/DX_CONN_Programming.kicad_blocks/CONN_PROG_SWD_10P_TAG.kicad_block/CONN_PROG_SWD_10P_TAG.kicad_sch

## KiCad design DesignBlocks/DX_CONN_Programming.kicad_blocks/CONN_PROG_SWD_10P_TAG.kicad_block/CONN_PROG_SWD_10P_TAG.kicad_sch (2025-11-15)

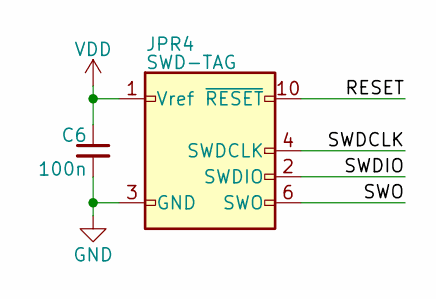
[picture p150: schematic CONN_PROG_SWD_10P_TAG.kicad_sch]

Parts:
C6: 100n; CAP_0402; PartNumber 0201-0100-00086
JPR4: SWD-TAG; Tag-Connect_TC2050-IDC-FP_2x05_P1.27mm_Vertical

Connections:
GND: C6.2, JPR4.3 (GND), JPR4.5 (GND), JPR4.9 (GNDDetect)
RESET: JPR4.10 (~RESET)
SWDCLK: JPR4.4 (SWDCLK)
SWDIO: JPR4.2 (SWDIO)
SWO: JPR4.6 (SWO)
VDD: C6.1, JPR4.1 (Vref)
