Daxxn/KiCAD-Component-Library/DesignBlocks/DX_Jumpers.kicad_blocks/STM32_BOOT_JUMPER.kicad_block/STM32_BOOT_JUMPER.kicad_sch

## KiCad design DesignBlocks/DX_Jumpers.kicad_blocks/STM32_BOOT_JUMPER.kicad_block/STM32_BOOT_JUMPER.kicad_sch (2025-11-15)

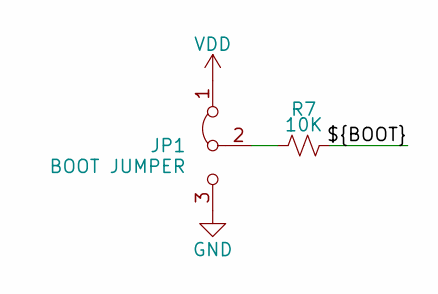
[picture p151: schematic STM32_BOOT_JUMPER.kicad_sch]

Parts:
JP1: BOOT JUMPER; PinHeader_1x03_P2.54mm_Vertical; PartNumber na
R7: 10K; RES_0402; PartNumber 0204-0000-00016

Connections:
${BOOT}: R7.2
GND: JP1.3 (B)
unnamed: JP1.2 (C), R7.1
VDD: JP1.1 (A)
