Daxxn/KiCAD-Component-Library/DesignBlocks/DX_Other.kicad_blocks/RESET_SWITCH.kicad_block/RESET_SWITCH.kicad_sch

## KiCad design DesignBlocks/DX_Other.kicad_blocks/RESET_SWITCH.kicad_block/RESET_SWITCH.kicad_sch (2025-11-15)

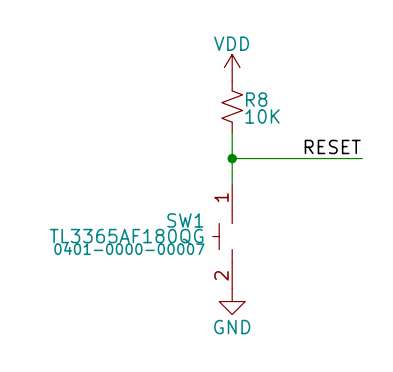
[picture p152: schematic RESET_SWITCH.kicad_sch]

Parts:
R8: 10K; RES_0402; PartNumber 0204-0000-00016
SW1: TL3365AF180QG; PartNumber 0401-0000-00007

Connections:
GND: SW1.2
RESET: R8.2, SW1.1
VDD: R8.1
