Daxxn/KiCAD-Component-Library/DesignBlocks/Daxxn_PWM_Lighting/PWM_Lighting_RGBW_Conn.kicad_block/PWM_Lighting_RGBW_Conn.kicad_sch

## KiCad design DesignBlocks/Daxxn_PWM_Lighting/PWM_Lighting_RGBW_Conn.kicad_block/PWM_Lighting_RGBW_Conn.kicad_sch (2025-04-12)

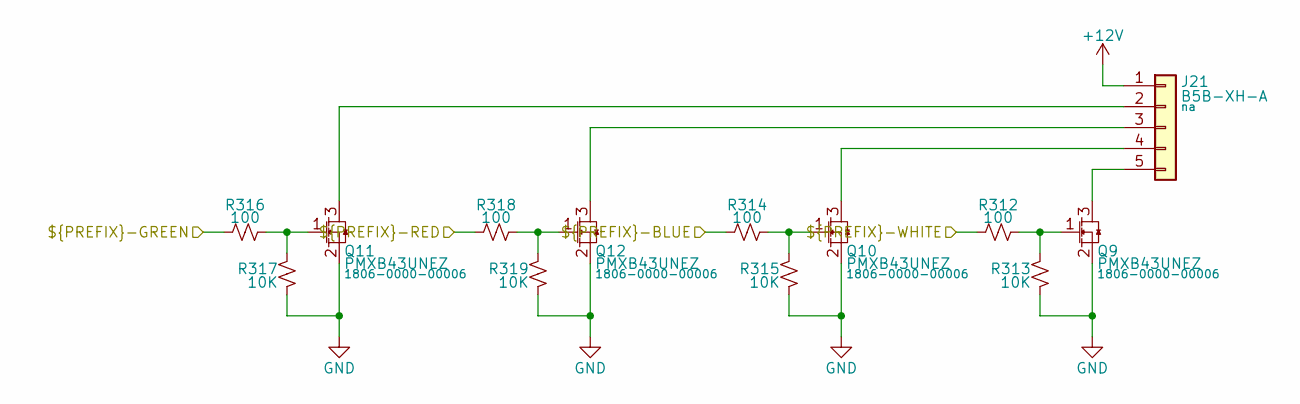
[picture p153: schematic PWM_Lighting_RGBW_Conn.kicad_sch]

Parts:
J21: B5B-XH-A; PartNumber na
Q9, Q10, Q11, Q12: PMXB43UNEZ; DFN1010D-3; PartNumber 1806-0000-00006
R312, R314, R316, R318: 100; RES_0402; PartNumber 0204-0000-00011
R313, R315, R317, R319: 10K; RES_0402; PartNumber 0204-0000-00016

Connections:
${PREFIX}-BLUE: R314.1
${PREFIX}-GREEN: R316.1
${PREFIX}-RED: R318.1
${PREFIX}-WHITE: R312.1
+12V: J21.1
GND: Q9.2 (S), Q10.2 (S), Q11.2 (S), Q12.2 (S), R313.2, R315.2, R317.2, R319.2
unnamed: J21.2, Q11.3 (D)
unnamed: J21.3, Q12.3 (D)
unnamed: J21.4, Q10.3 (D)
unnamed: J21.5, Q9.3 (D)
unnamed: Q9.1 (G), R312.2, R313.1
unnamed: Q10.1 (G), R314.2, R315.1
unnamed: Q11.1 (G), R316.2, R317.1
unnamed: Q12.1 (G), R318.2, R319.1
