Daxxn/KiCAD-Component-Library/DesignBlocks/Daxxn_PWM_Lighting/PWM_Lighting_RGB_Conn.kicad_block/PWM_Lighting_RGB_Conn.kicad_sch

## KiCad design DesignBlocks/Daxxn_PWM_Lighting/PWM_Lighting_RGB_Conn.kicad_block/PWM_Lighting_RGB_Conn.kicad_sch (2025-04-12)

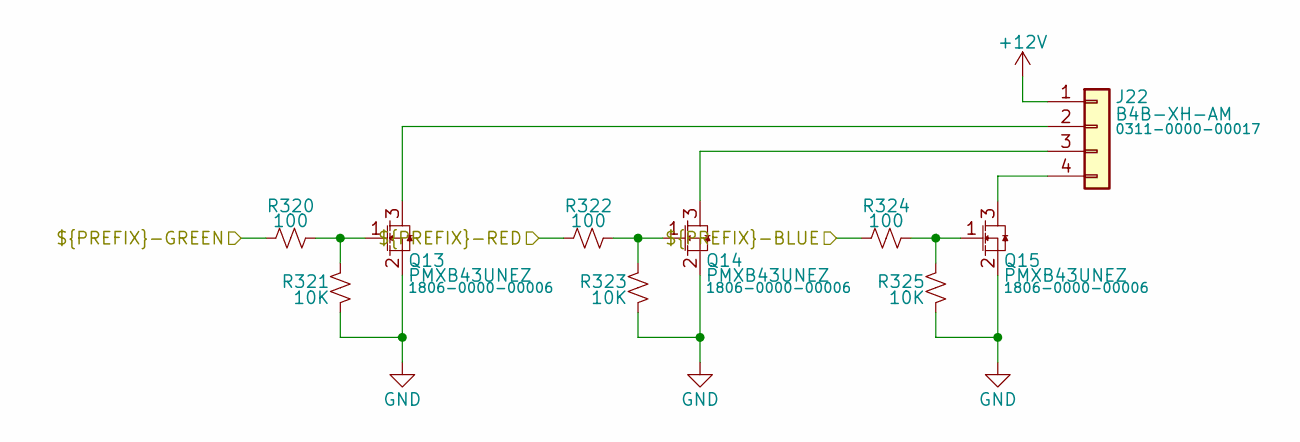
[picture p154: schematic PWM_Lighting_RGB_Conn.kicad_sch]

Parts:
J22: B4B-XH-AM; JST_XH_B4B-XH-A_1x04_P2.50mm_Vertical; PartNumber 0311-0000-00017
Q13, Q14, Q15: PMXB43UNEZ; DFN1010D-3; PartNumber 1806-0000-00006
R320, R322, R324: 100; RES_0402; PartNumber 0204-0000-00011
R321, R323, R325: 10K; RES_0402; PartNumber 0204-0000-00016

Connections:
${PREFIX}-BLUE: R324.1
${PREFIX}-GREEN: R320.1
${PREFIX}-RED: R322.1
+12V: J22.1
GND: Q13.2 (S), Q14.2 (S), Q15.2 (S), R321.2, R323.2, R325.2
unnamed: J22.2, Q13.3 (D)
unnamed: J22.3, Q14.3 (D)
unnamed: J22.4, Q15.3 (D)
unnamed: Q13.1 (G), R320.2, R321.1
unnamed: Q14.1 (G), R322.2, R323.1
unnamed: Q15.1 (G), R324.2, R325.1
