Daxxn/KiCAD-Component-Library/(commit log)

2023-01-02 Add a couple connectors and remove backup files
    [006841045000.stp, 046841045100846+.stp, AGQ200S4HZ-SMD v2.stp, Luminus-MP3014.stp, SJ-43515RS-SMT-TR v4.stp, USB3131-30-0230-A.stp]
2023-01-15 Component Backup 1-15-23
    [4-PLCC_3P2X2P8_INL.step, 525593652.stp, 541323662.stp, Bourns-TC33X.stp, LQH3NPN.stp, NHD-C0216AZ-FSW-GBW.STEP, NHD-C12832A1Z-FS(RGB).STEP, NHD-C12832A1Z.STEP]
2023-01-22 Add ST library and more footprints
    [CSS-1210TB.stp, DFN1010D-3.stp, KPJXHT-4S-S.step, KPJXHT-4S-S.stp, PCM12SMTR.stp, UFBGA144-7x7x0P6.step]
2023-03-10 Add lots of new parts
    [100-VQFNG_12X12.stp, 3214W.stp, 472192001.stp, DFN2510A-10.stp, FFC2B28-20-G.stp, FH12A-20S-0.5SH.stp, GSB4116341HR.stp, JS5208.stp]
2023-04-23 Save libraries 4-22-23
    [5-DFN-Power.stp, CUI_DEVICES_SJ-63073E.step, EG1218.stp, F26P_ASM.stp, K66X(HT)-A26P-N_rA4.IGS, MEM2061-01-188-00-A.stp, RTE0020A.stp, USON-8_2x3mm_P0.5mm.step]
2023-04-30 Add sensors, STM32, and more
2023-05-01 add automotive connectors
    [5007620481.stp, 903253006.stp]
2023-05-08 Add even MORE parts 5-8-23
    [039291027.stp, 5007620481.stp, 903253006.stp, CUI_DEVICES_SJ-63073E.stp, DFN2020D-6.step, KPJXHT-4S-S.stp, RKS0020A.stp]
2023-05-13 Update libraries 5-13-23
    [HVSON-8-3x3.step, IHLP2020CZ.step, IHLP6767GZ.step, RSM0032B.stp, SRP7050WA.stp]
2023-05-14 Add AM625 MPU and INA231
    [ALW0425A-BGA.step, YFF12-DSBGA-1.4x1.6-P0.4mm.step]
2023-06-03 Add memory IC symbol library and update pin1 indicators
    [19x19.960-19-12-S-AB-0.STEP, FBGA96_TB_MRN.step, MEM2075-00-140-01-A.stp]
2023-06-05 Update 6-5-23 - Add mamy many parts
    [10029449-111RLF.stp, PBH2UxxSNPNAGX.stp, QFN16_SOT1168-1_NEX.step, RKT0024A.stp]
2023-06-11 6-10-23 LOTS of new chips
    [541324033.stp, BQA0014A.stp, RL1632T4F-0612.step, X2WSON-6_1x1mm.stp, XSON-8_B1x1.95mm_P0.5mm.step]
2023-06-12 6-12-23 - Add chip models and more
    [16-UQFN_ZTA__DIO.step, 221AMC16R.STEP, 501951-4000.stp, FBGA96_ALL.step, QFN72_10X10_INR.step, VBGA-24_B6x8mm_P1mm.step, VFBGA153_ISI.step]
2025-02-12 add many more parts
    [010844062.stp, 039288240.stp, 039293046.stp, 039299046.stp, 039299063.stp, 039299243.stp, 12402012E212A.step, 1724470508.stp]
2025-04-12 SAVE 4-12-25
    [0630CDMCCDS.step, 10018783-10200TLF.STEP, 10018783-10201TLF.step, 10018783-10202TLF.STEP, 1002-014-01000.stp, 10029449-111RLF.STEP, 10090929-S26.stp, 10101788-002CLF.step]
2025-11-15 Add new parts | 11-15-25
    [10018783-10203TLF.stp, 470533000.stp, 5019514500.stp, 5019515000.stp, 62684-452100ALF.step, CONBNC001.STEP, CONN_PROG_SWD_10P_TAG.kicad_sch, CONN_PROG_SWD_5P_Header.kicad_sch]
