Daxxn/KiCAD-Component-Library/(notices)

Notices in the files:
Models/Passives/Diodes/D_2114_3652Metric.step:
Copyright (C) 2017, kicad StepUp
This program is free software: you can redistribute it and/or modify
it under the terms of the GNU General Public License as published by
the Free Software Foundation, either version 3 of the License, or
any later version.
itself might be covered by the GNU General Public License.
Models/LEDs/LED_1206_3216Metric.step:
Copyright (C) 2018, kicad StepUp
This work is licensed under the [Creative Commons CC-BY-SA 4.0 License](https://creativecommons.org/licenses/by-sa/4.0/legalcode),
with the following exception:
To the extent that the creation of electronic designs that use 'Licensed Material' can be considered to be 'Adapted Material',
You are free to use the library data in your own projects without the obligation to share your project files under this or any other license agreement.
Models/Packages/Package_DFN_QFN/QFN-64-1EP_8x8mm_P0.4mm_EP6.5x6.5mm.step:
Copyright (C) 2019, kicad StepUp
Models/Packages/Package_SIP/SIP-8_19x3mm_P2.54mm.step:
Copyright (C) 2020, kicad StepUp
Models/Packages/Package_DIP/DIP-18_W7.62mm_Socket.step:
Copyright (C) 2017, Terje Io
Models/Connectors/Connector_FFC_FPC/Molex_502250-3391_2Rows-33Pins-1MP_P0.60mm_Horizontal.step:
Copyright (C) 2018, Joel Holdsworth
Models/Packages/Package_SO/TSOP-I-24_18.4x6mm_P0.5mm.step:
Copyright (C) 2021, kicad StepUp
Models/Packages/Package_TO_SOT_SMD/TO-252-3_TabPin2.step:
Copyright (C) 2023, Ray Benitez
This work is licensed under the
[Creative Commons CC-BY-SA 4.0 License](https://creativecommons.org/licenses/by-sa/4.0/legalcode),
project files under this or any other license agreement. However, if you wish to distribute
Models/Connectors/Connector_Samtec_HPM_THT/Samtec_HPM-07-01-x-S_Straight_1x07_Pitch5.08mm.step:
Copyright (C) 2023, KiCAD
Models/Packages/Package_CSP/LFCSP-16-1EP_4x4mm_P0.65mm_EP2.6x2.6mm.step:
Copyright (C) 2022, KiCAD
Models/Connectors/Connector_USB/USB1135-15-P-L-B.stp:
author */ ('License CC BY-ND 4.0'),
